MatthiasGeorgImhof/Hardware_CSAT/auxio_board/README.md

# Auxilliary board #

The auxilliary board provides desktop connectivity and power for the cubesat modules

- STM32L496
- 2x CAN buses
- 3x USB
- 3.3V and unregulated power

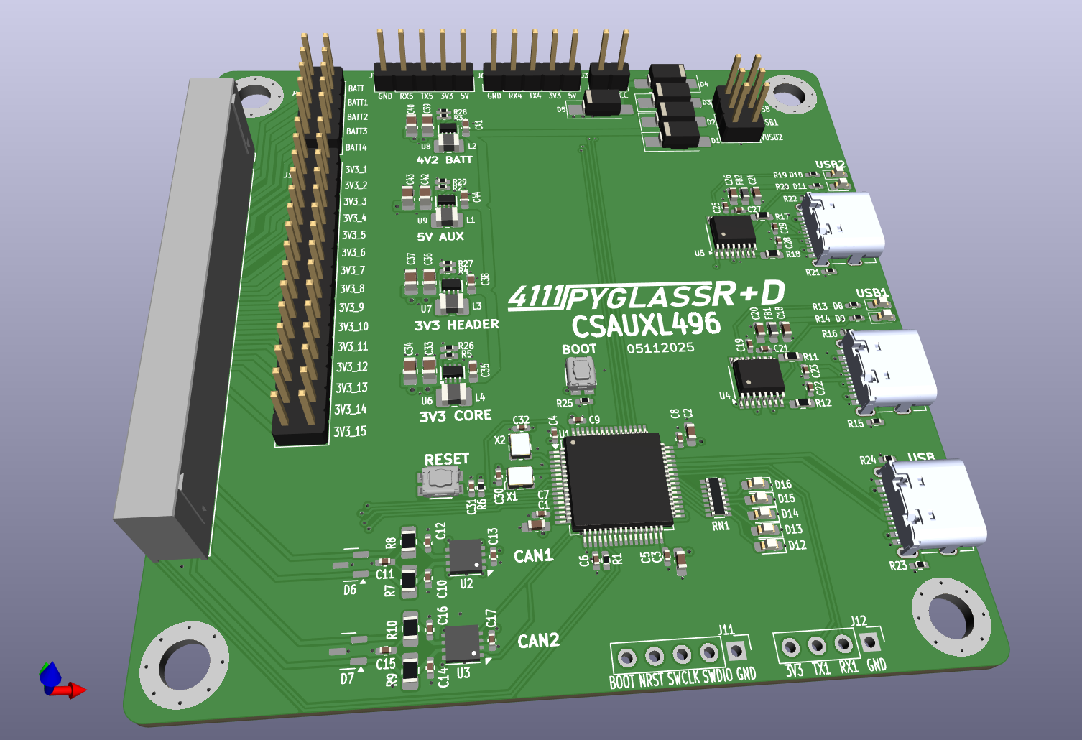
[picture p1: aux_board/aux_board_front.png]
Auxilliary board auxilliary board
