MatthiasGeorgImhof/Hardware_CSAT/avionics_board/README.md

# Avionics board #
- STM32L496 controller
- IMU and magenetometer
- UART for GPS receiver
- Magnetorquer controllers
- Temperature sensors
- Sun detectors

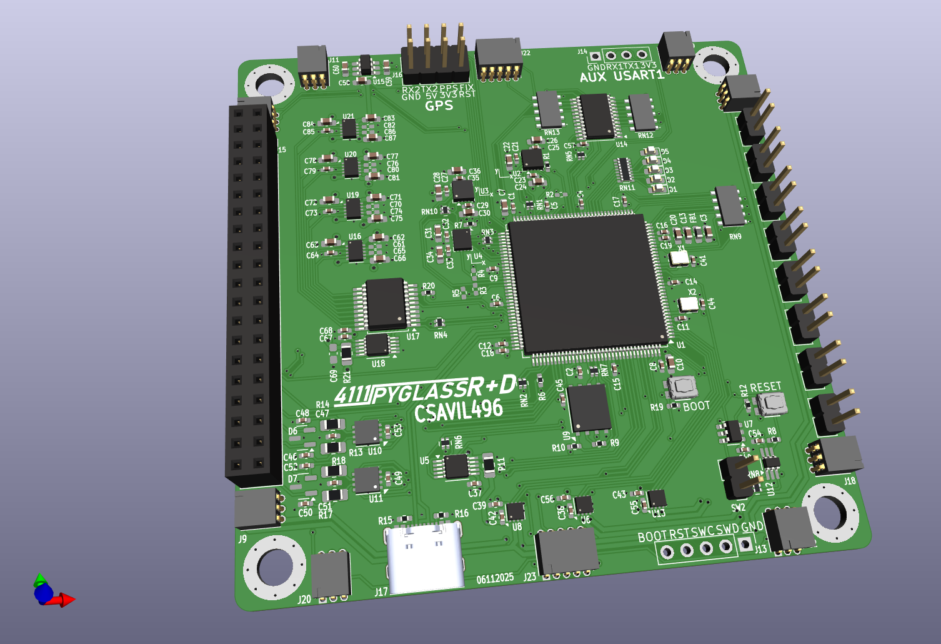
[picture p2: avionics_board/AVIONICS_BOARD.png]
Avionics board
