MatthiasGeorgImhof/Hardware_CSAT/eps_board/README.md

# Electric Power Supply (EPS) board

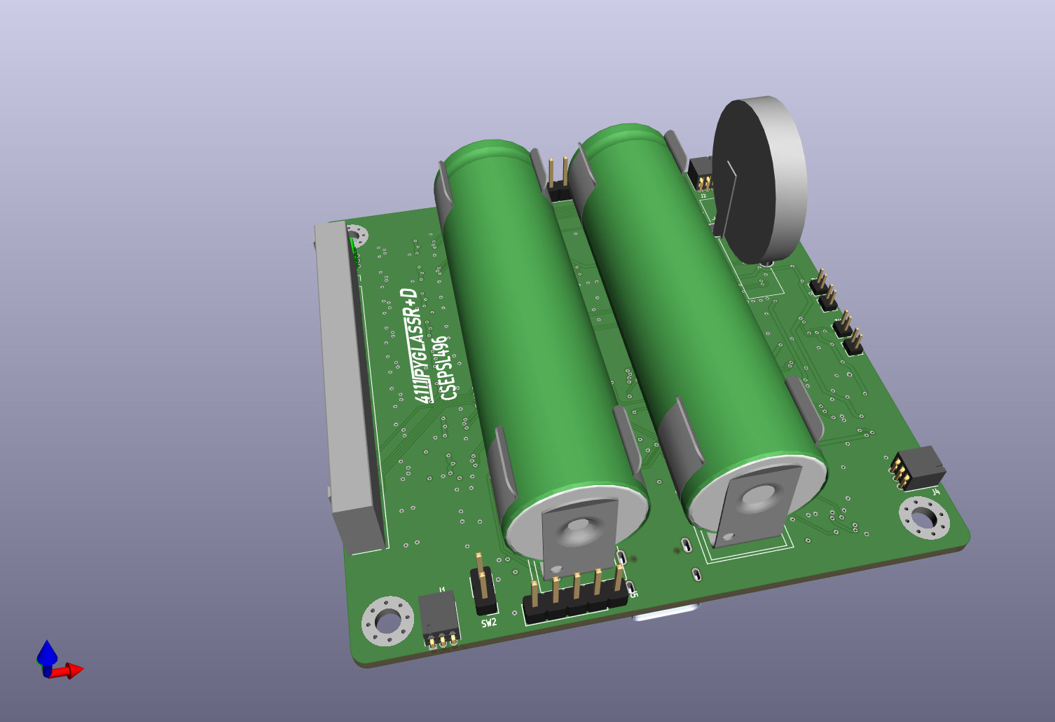
[picture p4: eps_board/EPS_front.png]
EPS board front side front side

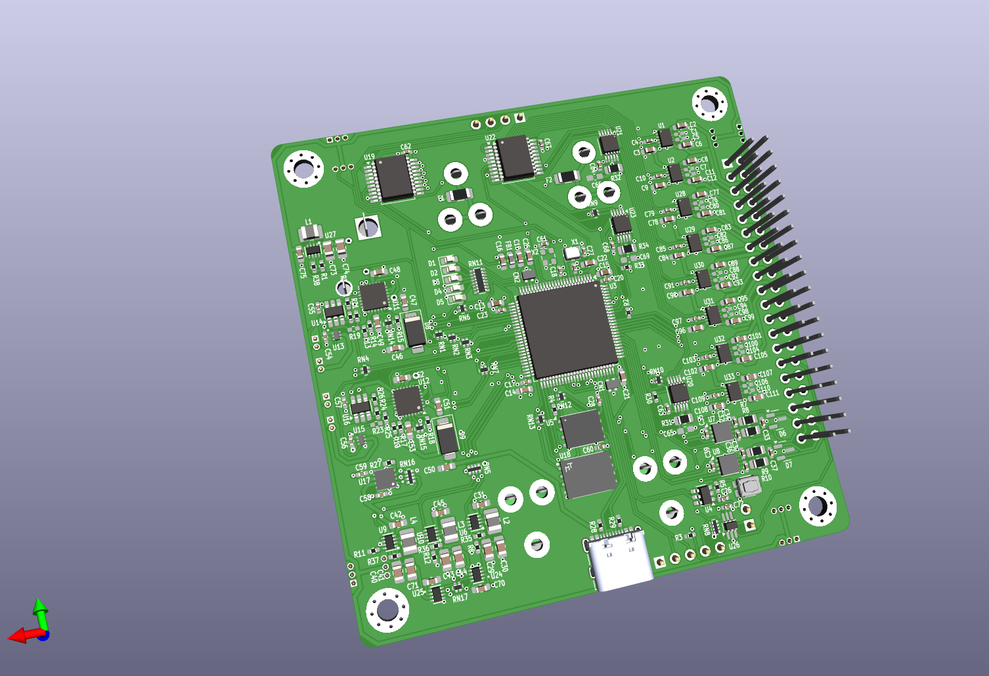
[picture p5: eps_board/EPS_back.png]
EPS board back side back side


- STM32L496VGTx controller
- 2x CAN buses
- 2x 18650 LiPo batteries for operation and 1x CR2450 cell for RTC
