MatthiasGeorgImhof/Hardware_CSAT/sci_board_wo_switches/README.md

# Science Board

- STM32L496VGTx
- 2x CAN buses
- 3x camera ports
- 1x I2C port

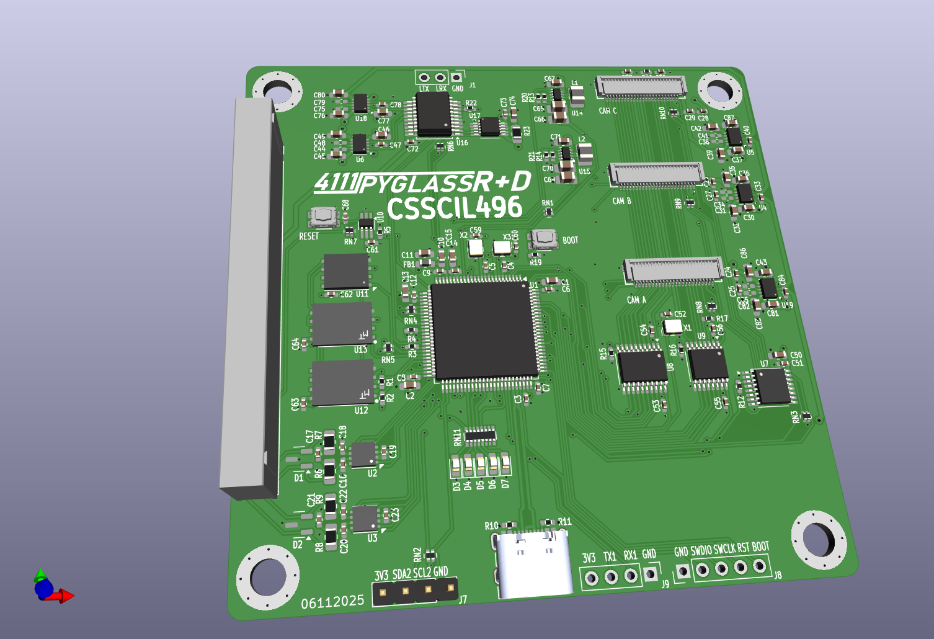
[picture p6: sci_board_wo_switches/sci_board_wo_switches_front.png]
Science board
 "Science board")
