MatthiasGeorgImhof/Hardware_CSAT/sci_board.inactive/sci_board.png

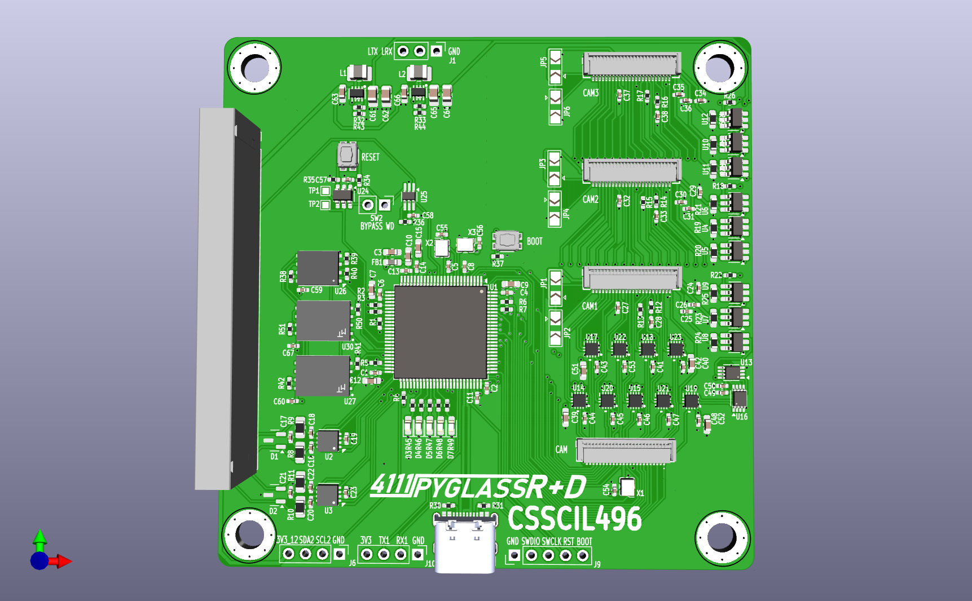
sci_board.inactive/sci_board.png
