MatthiasGeorgImhof/Hardware_CSAT/comm_board/inactive/step3d/LGA-28-6x6-0.7x0.7.step

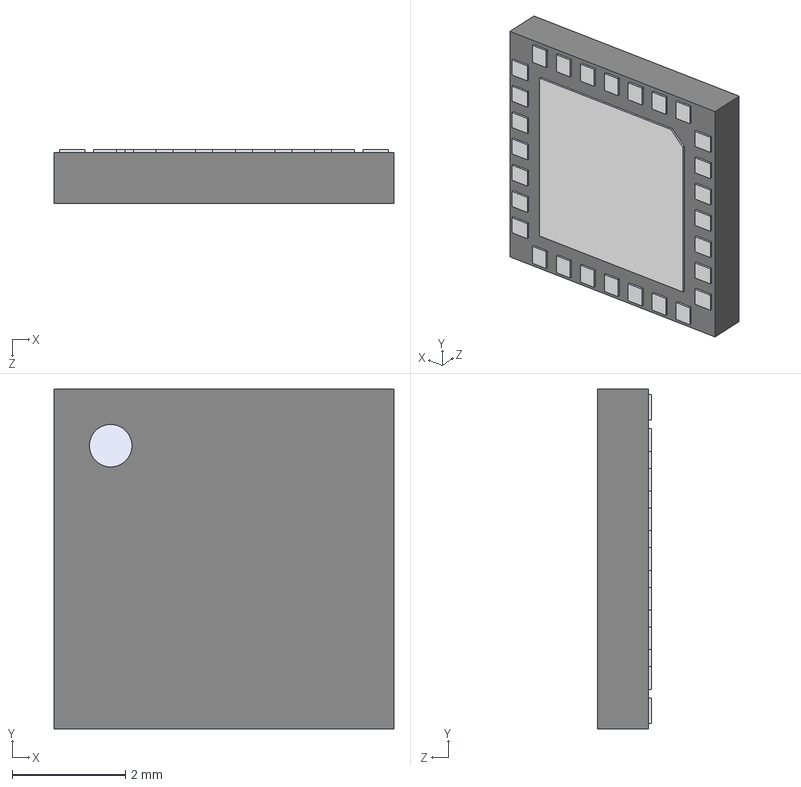
[picture p8: CAD file, 2026-06-08]
comm_board/inactive/step3d/LGA-28-6x6-0.7x0.7.step
6.00 x 6.00 x 0.95 mm
Open_CASCADE_STEP_translator_6.8_27.1
Open_CASCADE_STEP_translator_6.8_27.2.1
Thermal_Shape
Pin_Shape x 28
