MatthiasGeorgImhof/Hardware_CSAT/eps_board/inactive/Step3d/CR2450 VAN v1.step

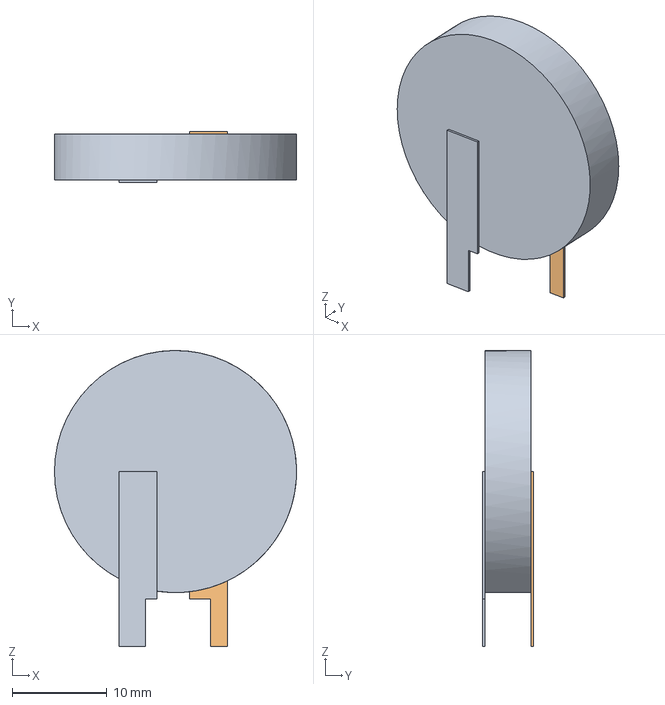
[picture p9: CAD file, 2026-06-08]
eps_board/inactive/Step3d/CR2450 VAN v1.step
25.6 x 5.35 x 31.3 mm
