MatthiasGeorgImhof/Hardware_CSAT/sci_board.inactive/Step3d/TSOT23-8_MP3416_MNP.step

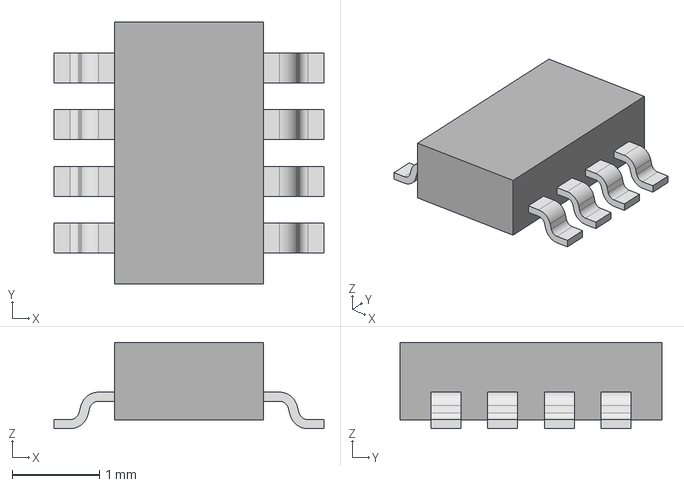
[picture p10: CAD file, 2026-06-08]
sci_board.inactive/Step3d/TSOT23-8_MP3416_MNP.step
3.09 x 3.00 x 0.991 mm
