MatthiasGeorgImhof/Hardware_CSAT/sci_board_wo_switches/inactive/Step3d/MT29F4G01ABAFDWB-IT_F.stp

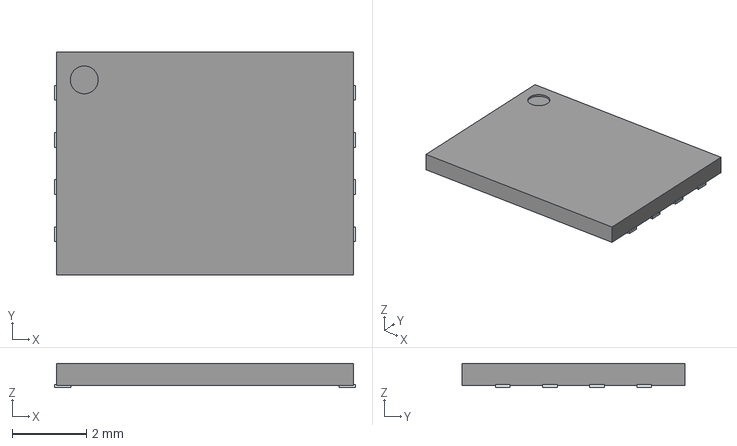
[picture p11: CAD file, 2026-06-08]
sci_board_wo_switches/inactive/Step3d/MT29F4G01ABAFDWB-IT_F.stp
8.10 x 6.00 x 0.65 mm
PinsArrayLR
