MatthiasGeorgImhof/Hardware_CSAT/auxio_board/inactive/step/ESQ-124-38-L-D.step

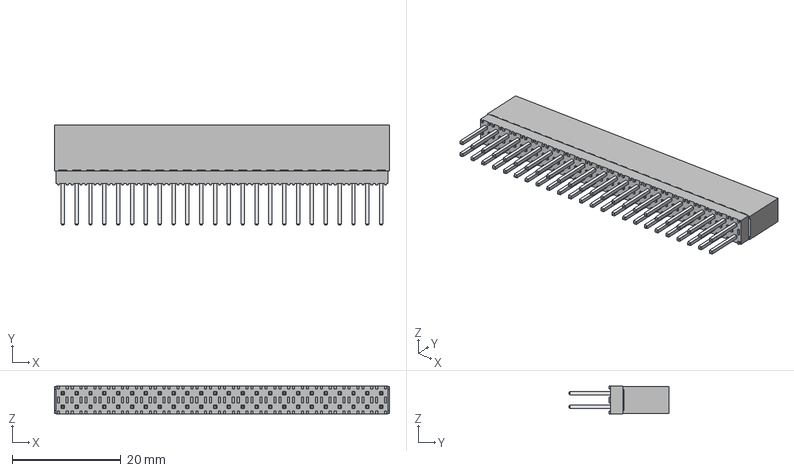
[picture p12: CAD file, 2026-06-08]
auxio_board/inactive/step/ESQ-124-38-L-D.step
61.5 x 18.4 x 5.08 mm
ESQ-124-38-L-D_socket
ESQ-124-38-L-D_pins
ESQ-124-38-L-D2_pins
ESQ-124-38-G-D-LL_bpins
