MatthiasGeorgImhof/Hardware_CSAT/common/step3d/TG2520_EPS.step

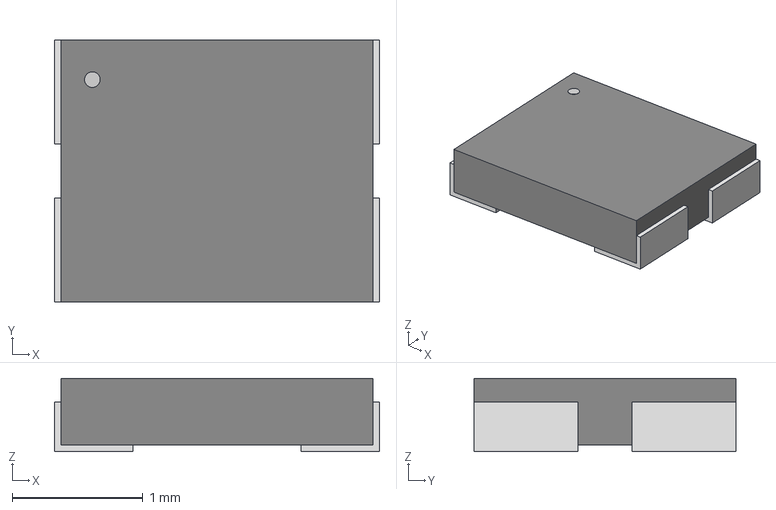
[picture p13: CAD file, 2026-06-08]
common/step3d/TG2520_EPS.step
2.49 x 2.01 x 0.561 mm
