MatthiasGeorgImhof/Hardware_CSAT/eps_board/inactive/Step3d/keystone-PN54.STEP

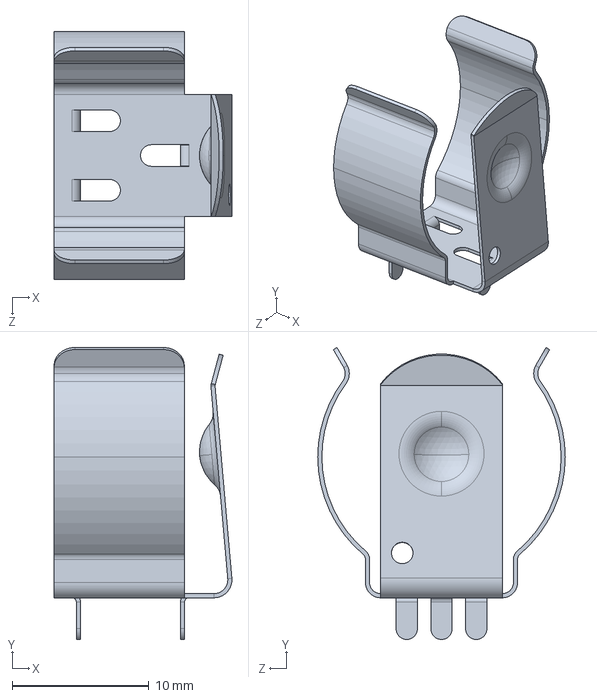
[picture p14: CAD file, 2026-06-08]
eps_board/inactive/Step3d/keystone-PN54.STEP
13.0 x 21.4 x 18.1 mm
