MatthiasGeorgImhof/Hardware_CSAT/sci_board.inactive/Step3d/ECS-270-20-30B-TR.step

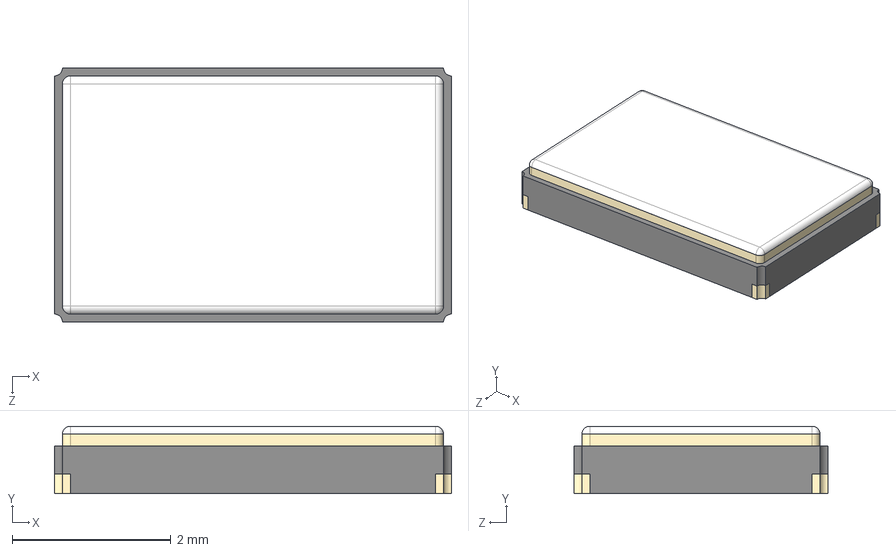
[picture p15: CAD file, 2026-06-08]
sci_board.inactive/Step3d/ECS-270-20-30B-TR.step
5.00 x 0.85 x 3.20 mm
