MatthiasGeorgImhof/Hardware_CSAT/auxio_board/inactive/step/ECS-TXO-2016-33-100-TR.step

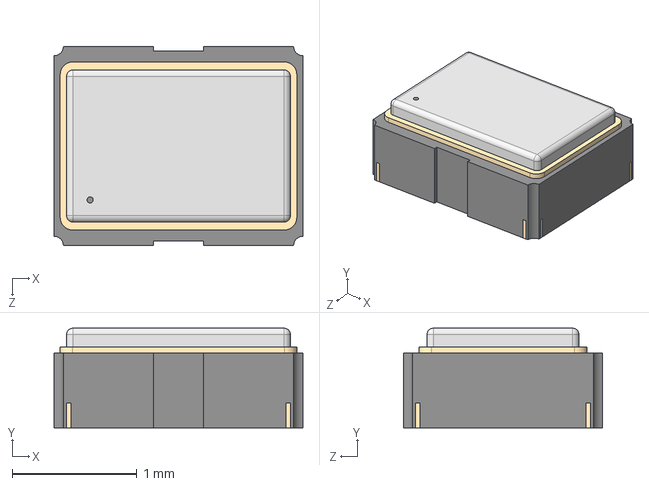
[picture p16: CAD file, 2026-06-08]
auxio_board/inactive/step/ECS-TXO-2016-33-100-TR.step
2.00 x 0.8 x 1.60 mm
