MatthiasGeorgImhof/Hardware_CSAT/comm_board/inactive/step3d/CONSMA001-G.step

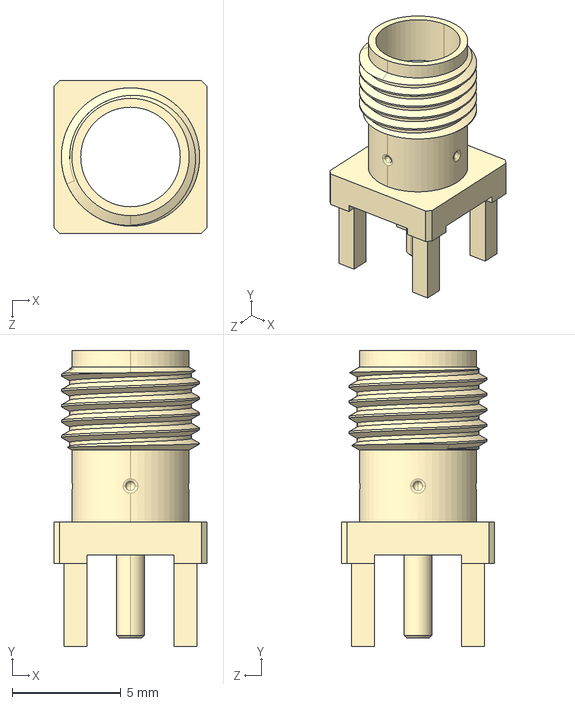
[picture p17: CAD file, 2026-06-08]
comm_board/inactive/step3d/CONSMA001-G.step
7.01 x 13.6 x 7.01 mm
