MatthiasGeorgImhof/Hardware_CSAT/eps_board/inactive/Step3d/User Library-CR2354-VCN-1.STEP

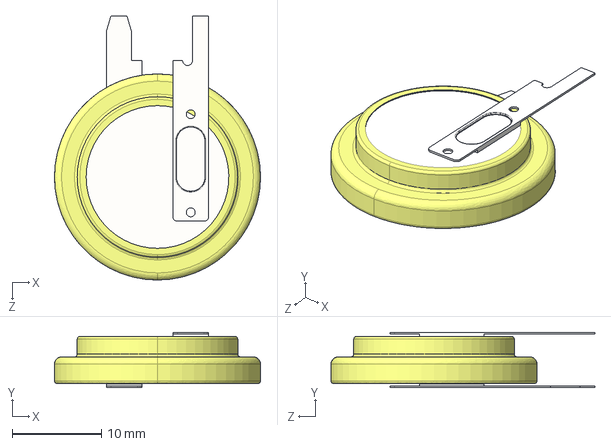
[picture p18: CAD file, 2026-06-08]
eps_board/inactive/Step3d/User Library-CR2354-VCN-1.STEP
23.1 x 6.20 x 29.6 mm
