MatthiasGeorgImhof/Hardware_CSAT/sci_board.inactive/Step3d/TMUX131RMGR.step

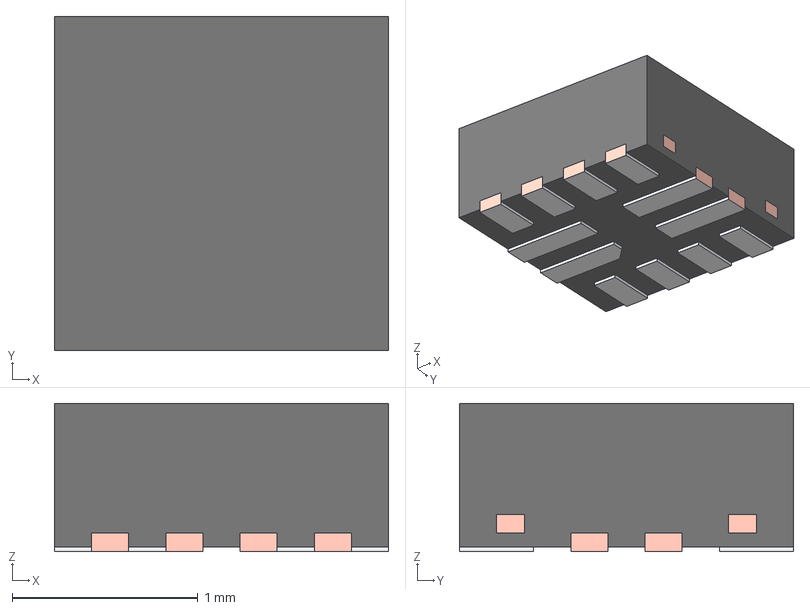
[picture p19: CAD file, 2026-06-08]
sci_board.inactive/Step3d/TMUX131RMGR.step
1.80 x 1.80 x 0.8 mm
FRAME
PIN1_AREA
