MatthiasGeorgImhof/Hardware_CSAT/auxio_board/inactive/step/evpaa602w.stp

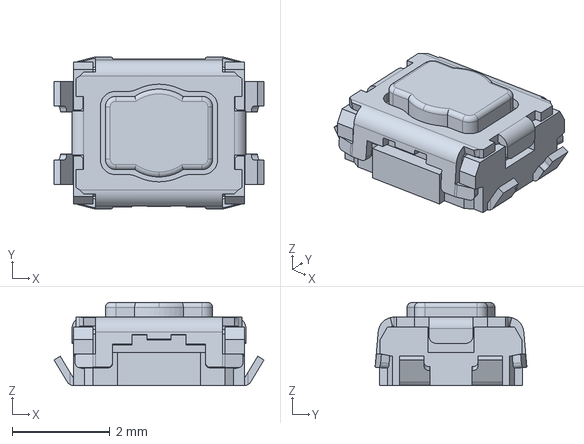
[picture p20: CAD file, 2026-06-08]
auxio_board/inactive/step/evpaa602w.stp
4.30 x 3.11 x 1.70 mm
