MatthiasGeorgImhof/Hardware_CSAT/comm_board/inactive/step3d/204-211.step

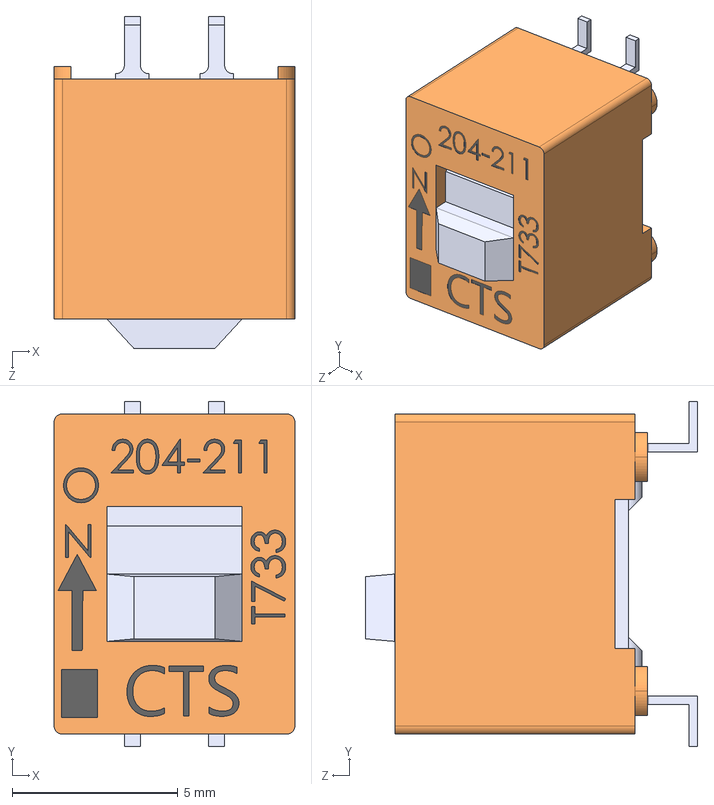
[picture p21: CAD file, 2026-06-08]
comm_board/inactive/step3d/204-211.step
7.27 x 10.4 x 10.0 mm
204-211R cover
204-211 actuator
204-2 pole assembly
