MatthiasGeorgImhof/Hardware_CSAT/common/step3d/SAMTEC-CLP-102-02-X-DH.step

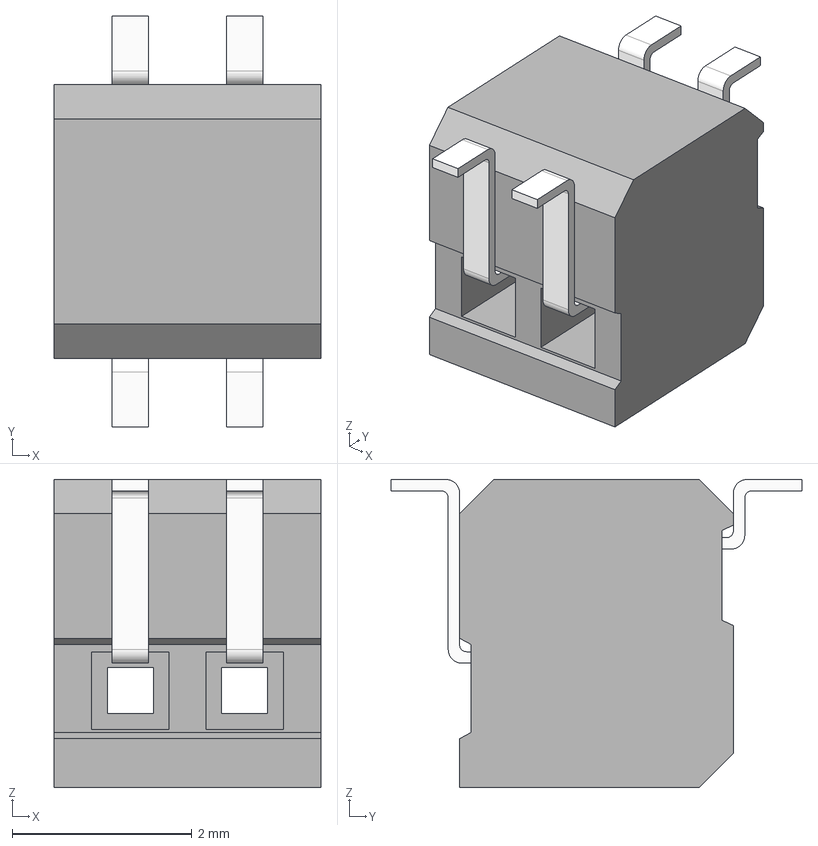
[picture p22: CAD file, 2026-06-08]
common/step3d/SAMTEC-CLP-102-02-X-DH.step
2.97 x 4.57 x 3.43 mm
CLP-102-2-F-DH-TR_terminal
C-70-04-1-F-02_Pin_2_dh
C-70-05-1-F-02_Pin_dh
