MatthiasGeorgImhof/Hardware_CSAT/sci_board.inactive/Step3d/SF-DFN8_EVS.step

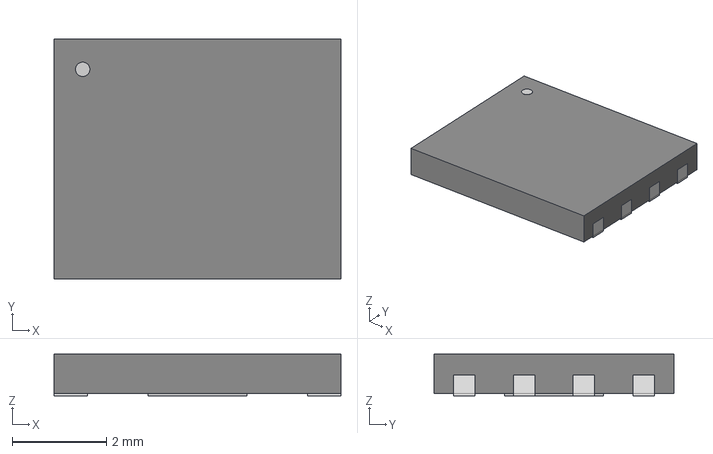
[picture p23: CAD file, 2026-06-08]
sci_board.inactive/Step3d/SF-DFN8_EVS.step
6.10 x 5.11 x 0.892 mm
