MatthiasGeorgImhof/Hardware_CSAT/sci_board_wo_switches/inactive/Step3d/MT29F2G01ABAGDWB-IT_G TR.step

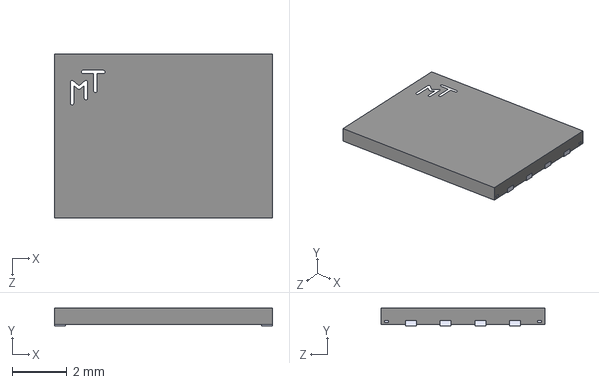
[picture p24: CAD file, 2026-06-08]
sci_board_wo_switches/inactive/Step3d/MT29F2G01ABAGDWB-IT_G TR.step
8.00 x 0.65 x 6.00 mm
