MatthiasGeorgImhof/Hardware_CSAT/comm_board/inactive/step3d/SF2446E.stp

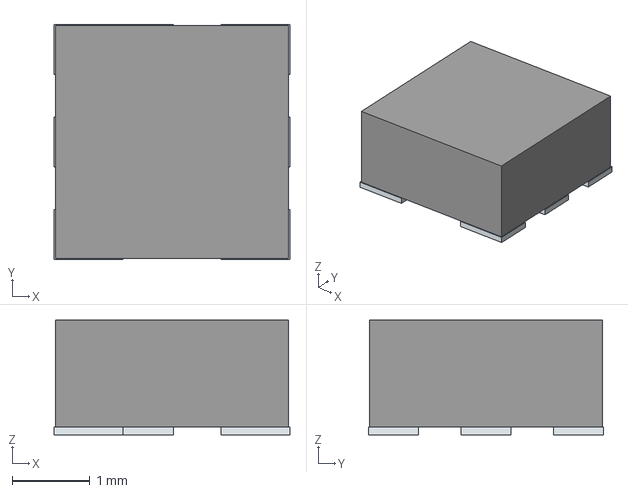
[picture p25: CAD file, 2026-06-08]
comm_board/inactive/step3d/SF2446E.stp
3.04 x 3.03 x 1.48 mm
Pins
