MatthiasGeorgImhof/Hardware_CSAT/common/step3d/ECS-2520MVLC-100-BN-TR.step

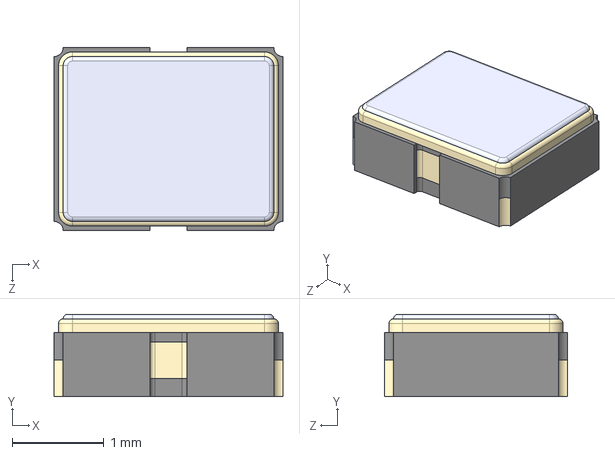
[picture p26: CAD file, 2026-06-08]
common/step3d/ECS-2520MVLC-100-BN-TR.step
2.50 x 0.9 x 2.00 mm
