MatthiasGeorgImhof/Hardware_CSAT/common/step3d/PW0020A.stp

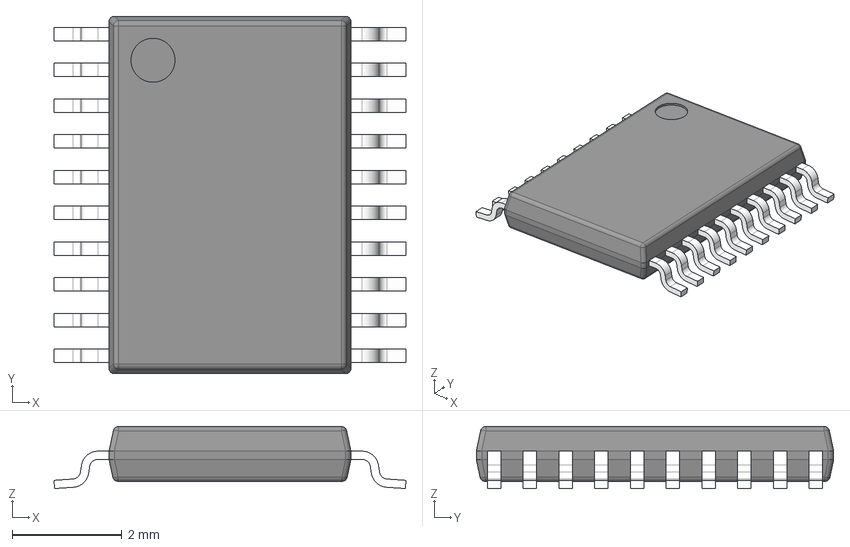
[picture p27: CAD file, 2026-06-08]
common/step3d/PW0020A.stp
6.40 x 6.50 x 1.13 mm
BODY-TSSOP
LEAD-TSSOP x 20
PIN1
