MatthiasGeorgImhof/Hardware_CSAT/common/step3d/DCU0008A.stp

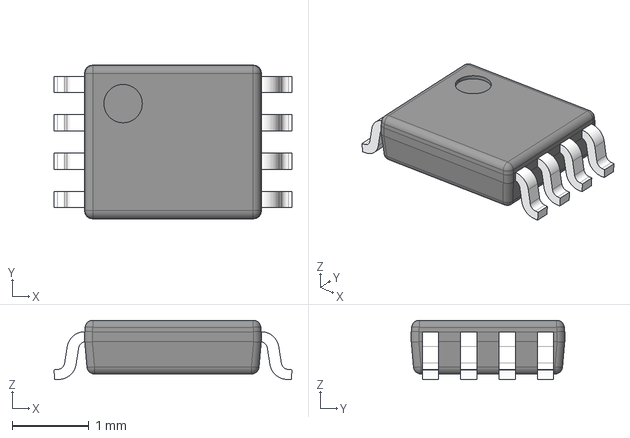
[picture p28: CAD file, 2026-06-08]
common/step3d/DCU0008A.stp
3.10 x 2.00 x 0.775 mm
BODY-VSSOP
LEAD-VSSOP x 8
