MatthiasGeorgImhof/Hardware_CSAT/common/step3d/YC158TJR.STEP

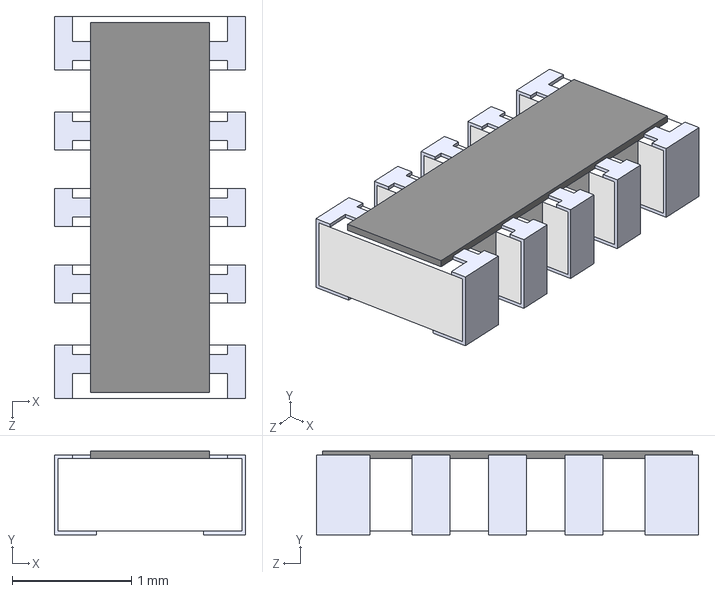
[picture p29: CAD file, 2026-06-08]
common/step3d/YC158TJR.STEP
1.60 x 0.7 x 3.20 mm
