MatthiasGeorgImhof/Hardware_CSAT/common/step3d/TCAN3413DRBR.STEP

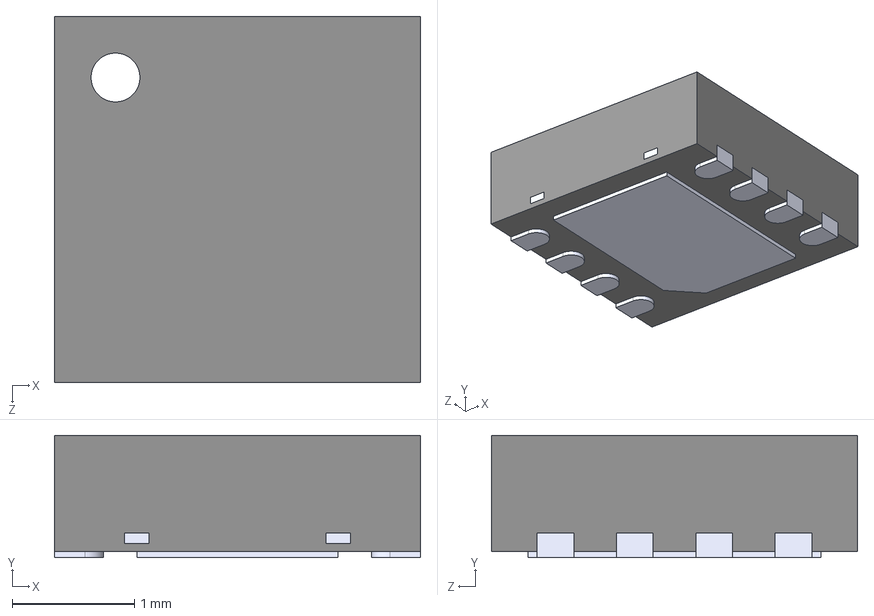
[picture p30: CAD file, 2026-06-08]
common/step3d/TCAN3413DRBR.STEP
3.00 x 1.00 x 3.00 mm
