MatthiasGeorgImhof/Hardware_CSAT/common/step3d/RJMG1BD3B8K1ANR.STEP

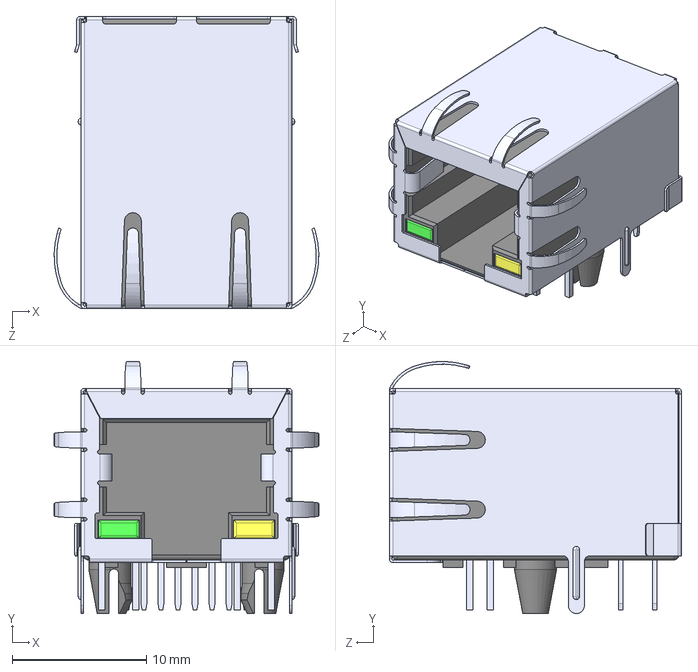
[picture p31: CAD file, 2026-06-08]
common/step3d/RJMG1BD3B8K1ANR.STEP
19.7 x 18.8 x 21.8 mm
