MatthiasGeorgImhof/Hardware_CSAT/common/step3d/SAMTEC-CLP-103-02-X-DH.step

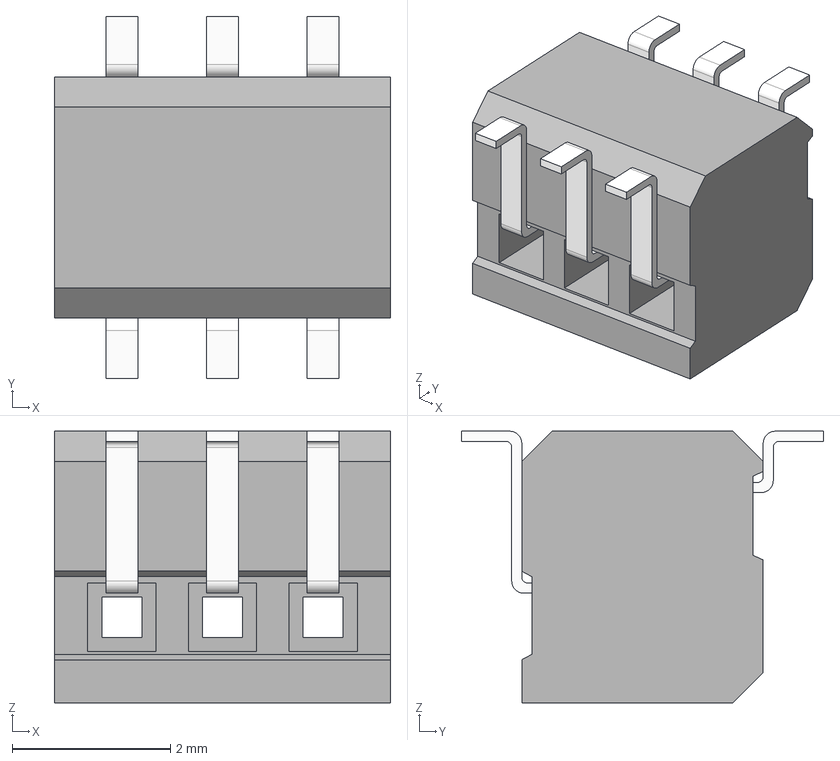
[picture p32: CAD file, 2026-06-08]
common/step3d/SAMTEC-CLP-103-02-X-DH.step
4.24 x 4.57 x 3.43 mm
CLP-103-2-L-DH-TR_terminal
C-70-04-1-L-03_Pin_2_dh
C-70-05-1-L-03_Pin_dh
