MatthiasGeorgImhof/Hardware_CSAT/common/step3d/W2A2-X.stp

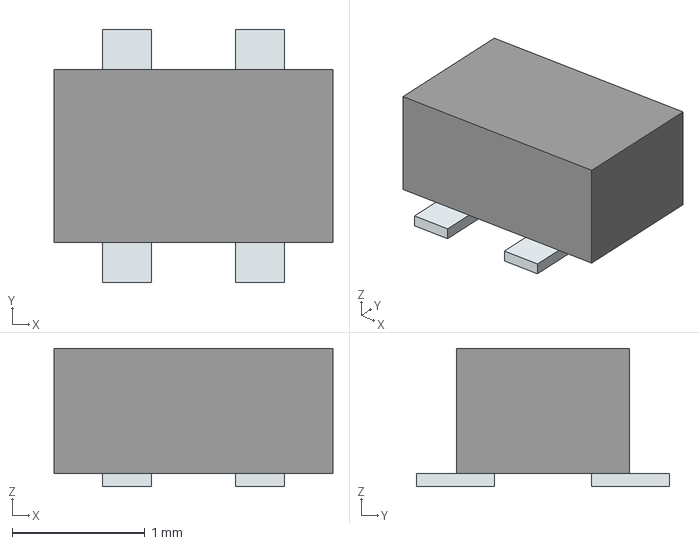
[picture p33: CAD file, 2026-06-08]
common/step3d/W2A2-X.stp
2.10 x 1.91 x 1.04 mm
Pins
