MatthiasGeorgImhof/Hardware_CSAT/common/step3d/SAMTEC-CLP-104-02-X-DH.step

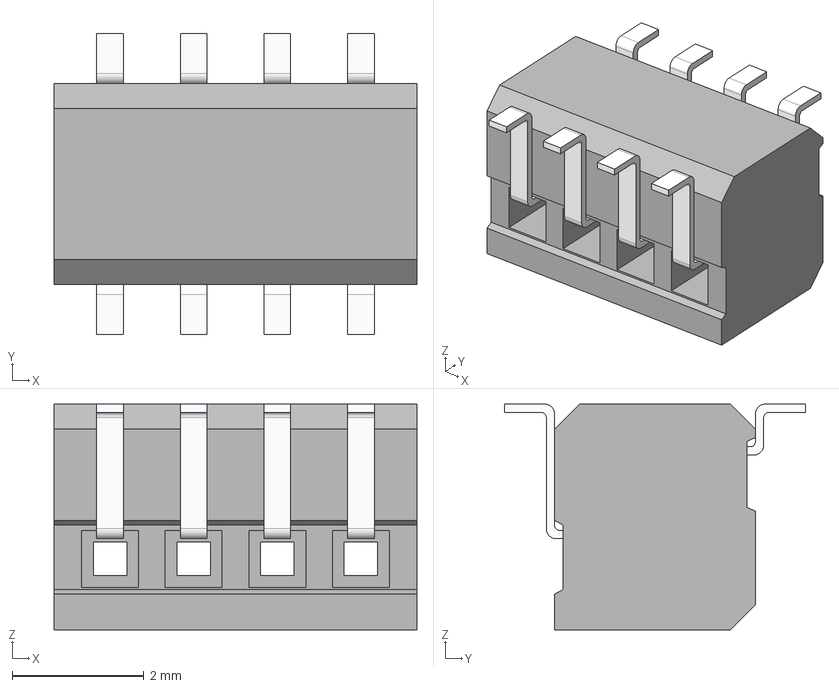
[picture p34: CAD file, 2026-06-08]
common/step3d/SAMTEC-CLP-104-02-X-DH.step
5.51 x 4.57 x 3.43 mm
CLP-104-2-F-DH_terminal
C-70-04-1-F-04_Pin_2_dh
C-70-05-1-F-04_Pin_dh
