MatthiasGeorgImhof/Hardware_CSAT/common/step3d/RZG0006A.stp

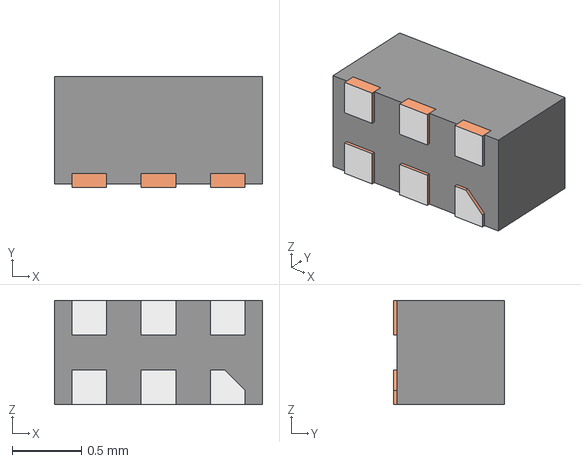
[picture p35: CAD file, 2026-06-08]
common/step3d/RZG0006A.stp
1.50 x 0.8 x 0.75 mm
BODY-RZG0006A
FRAME-RZG0006A
