MatthiasGeorgImhof/Hardware_CSAT/common/step3d/CC1101RGPR.stp

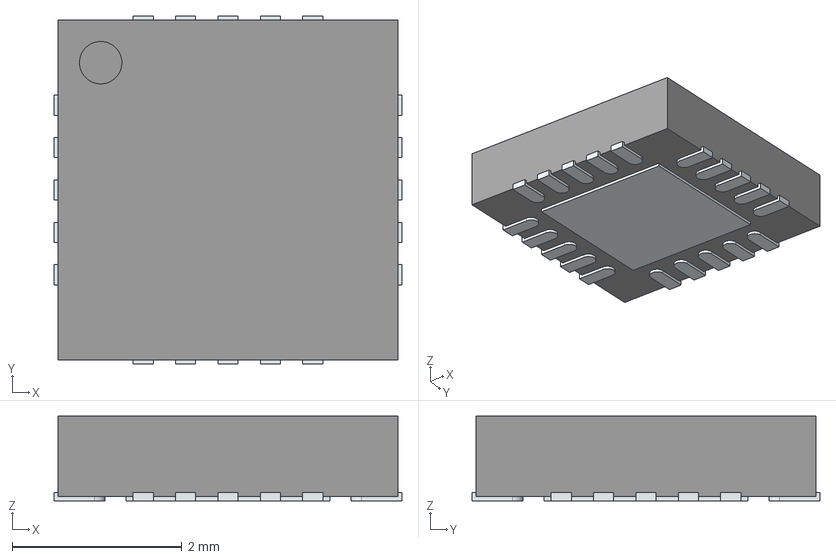
[picture p36: CAD file, 2026-06-08]
common/step3d/CC1101RGPR.stp
4.10 x 4.10 x 1.00 mm
ThermalPin
PinsArrayLR
PinsArrayTB
