MatthiasGeorgImhof/Hardware_CSAT/common/step3d/YC248-JR.STEP

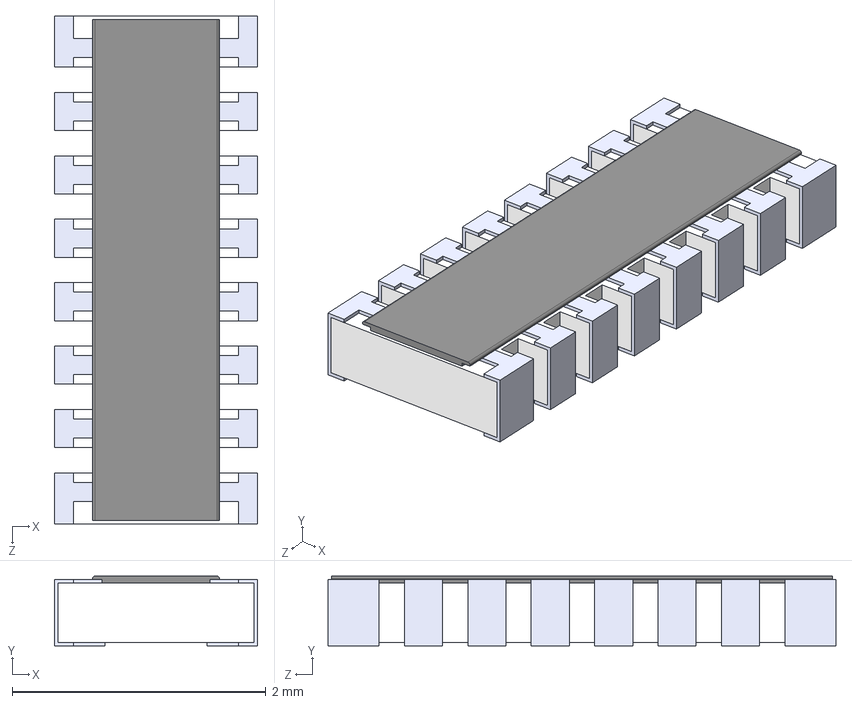
[picture p37: CAD file, 2026-06-08]
common/step3d/YC248-JR.STEP
1.60 x 0.55 x 4.00 mm
