MatthiasGeorgImhof/Hardware_CSAT/common/step3d/TSSOP8_SOT505-1_NXP.step

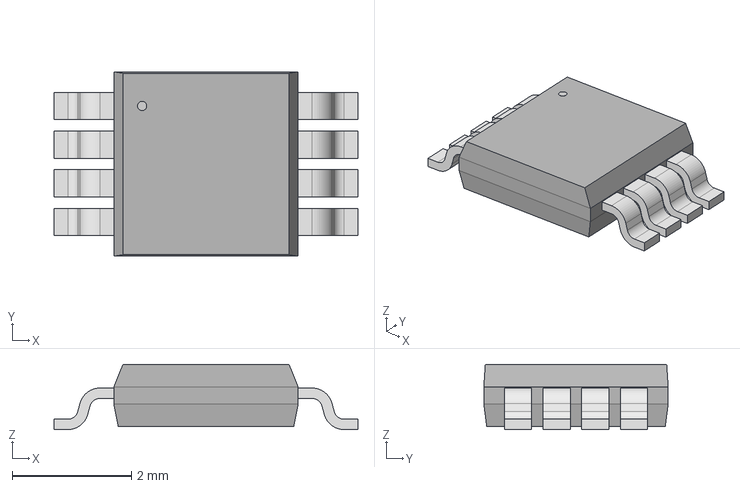
[picture p38: CAD file, 2026-06-08]
common/step3d/TSSOP8_SOT505-1_NXP.step
5.11 x 3.10 x 1.09 mm
