MatthiasGeorgImhof/Hardware_CSAT/common/step3d/SSOP28_MC_MCH.step

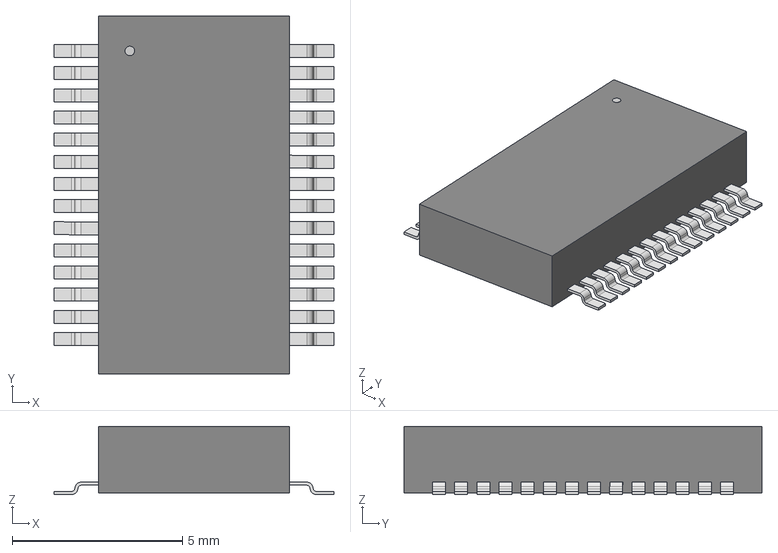
[picture p39: CAD file, 2026-06-08]
common/step3d/SSOP28_MC_MCH.step
8.20 x 10.5 x 2.00 mm
