MatthiasGeorgImhof/Hardware_CSAT/common/step3d/SSOP20_MC_MCH.step

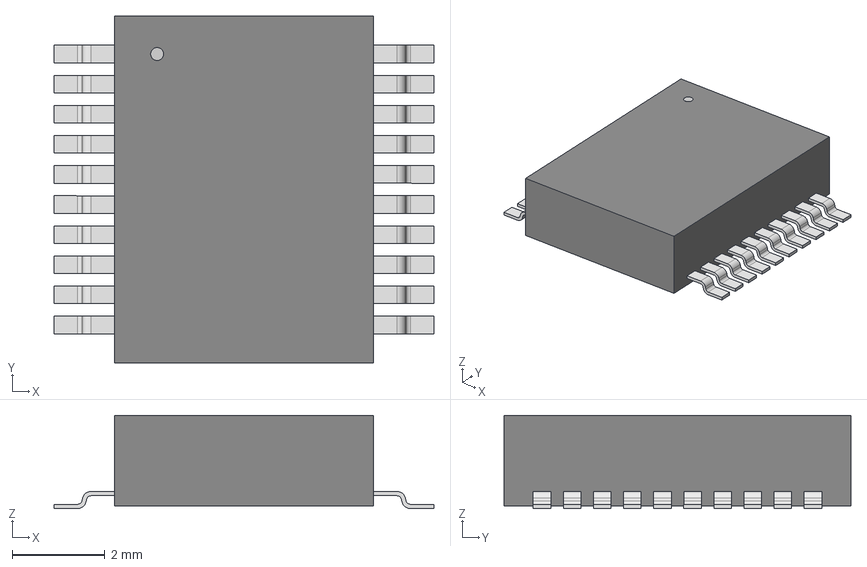
[picture p40: CAD file, 2026-06-08]
common/step3d/SSOP20_MC_MCH.step
8.20 x 7.49 x 2.01 mm
