MatthiasGeorgImhof/Hardware_CSAT/common/step3d/DRL0008A.stp

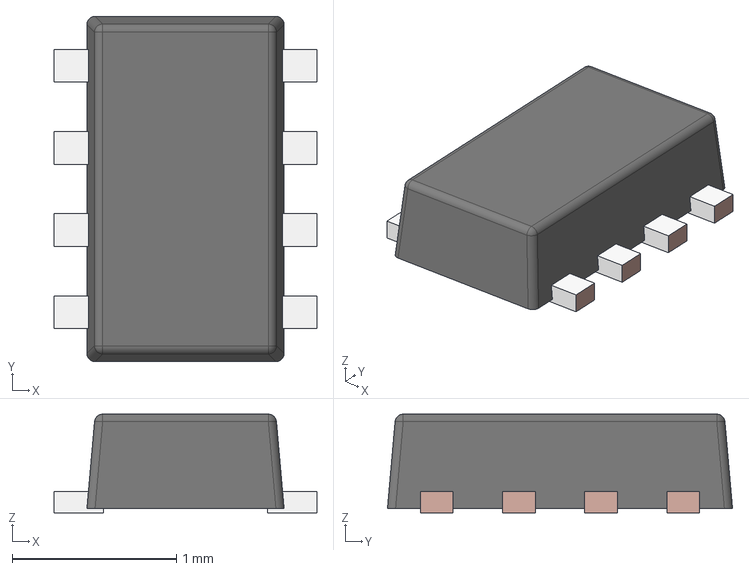
[picture p41: CAD file, 2026-06-08]
common/step3d/DRL0008A.stp
1.60 x 2.10 x 0.6 mm
FRAME-DRL0008A
BODY-SOT
