MatthiasGeorgImhof/Hardware_CSAT/common/step3d/YC358TJK.step

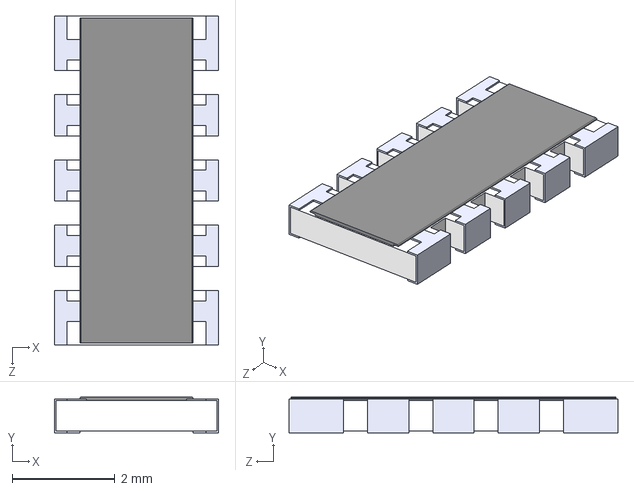
[picture p42: CAD file, 2026-06-08]
common/step3d/YC358TJK.step
3.20 x 0.7 x 6.40 mm
