MatthiasGeorgImhof/Hardware_CSAT/common/step3d/SAMTEC-CLP-106-02-X-DH.step

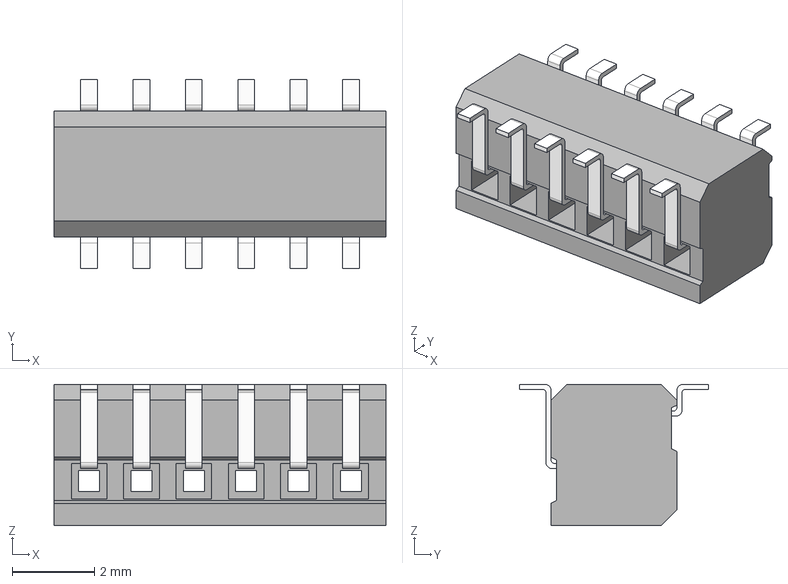
[picture p43: CAD file, 2026-06-08]
common/step3d/SAMTEC-CLP-106-02-X-DH.step
8.05 x 4.57 x 3.43 mm
CLP-106-2-F-DH_terminal
C-70-04-1-F-06_Pin_2_dh
C-70-05-1-F-06_Pin_dh
