MatthiasGeorgImhof/Hardware_CSAT/common/step3d/SAMTEC-CLP-105-02-X-DH.step

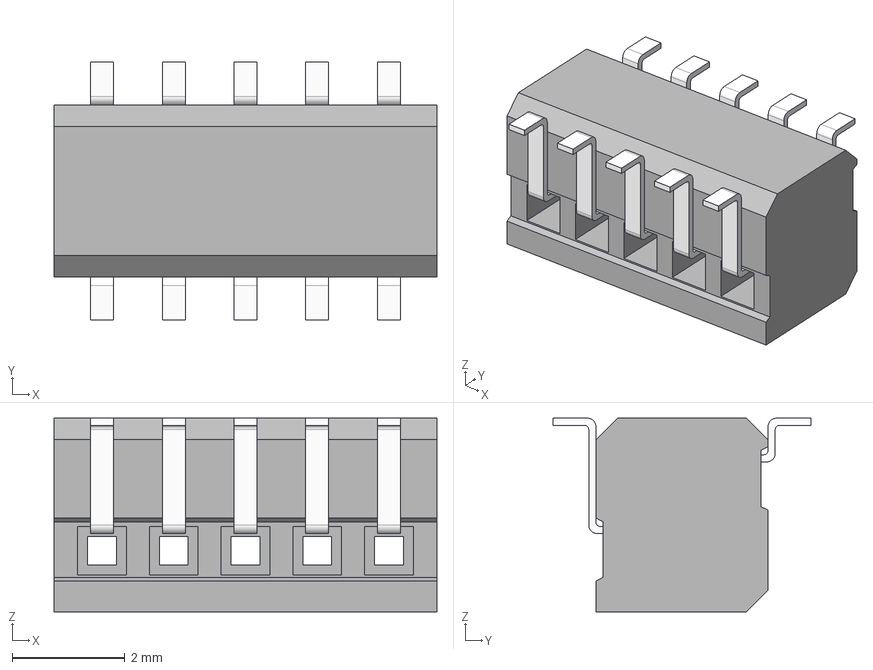
[picture p44: CAD file, 2026-06-08]
common/step3d/SAMTEC-CLP-105-02-X-DH.step
6.78 x 4.57 x 3.43 mm
CLP-105-2-F-DH_terminal
C-70-04-1-F-05_Pin_2_dh
C-70-05-1-F-05_Pin_dh
