MatthiasGeorgImhof/Hardware_CSAT/common/step3d/EXB-A10P.stp

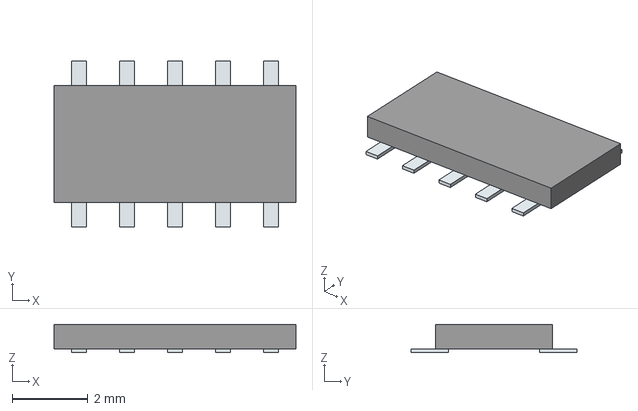
[picture p45: CAD file, 2026-06-08]
common/step3d/EXB-A10P.stp
6.40 x 4.40 x 0.75 mm
Pins
