MatthiasGeorgImhof/Hardware_CSAT/common/step3d/TSSOP20_SOT360-1_NEX.step

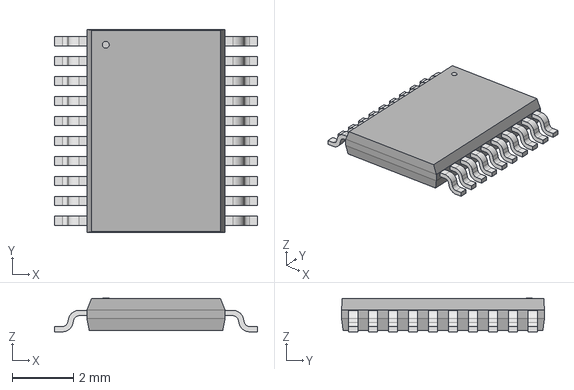
[picture p46: CAD file, 2026-06-08]
common/step3d/TSSOP20_SOT360-1_NEX.step
6.60 x 6.60 x 1.09 mm
