MatthiasGeorgImhof/Hardware_CSAT/common/step3d/RB1-125BAG1A.step

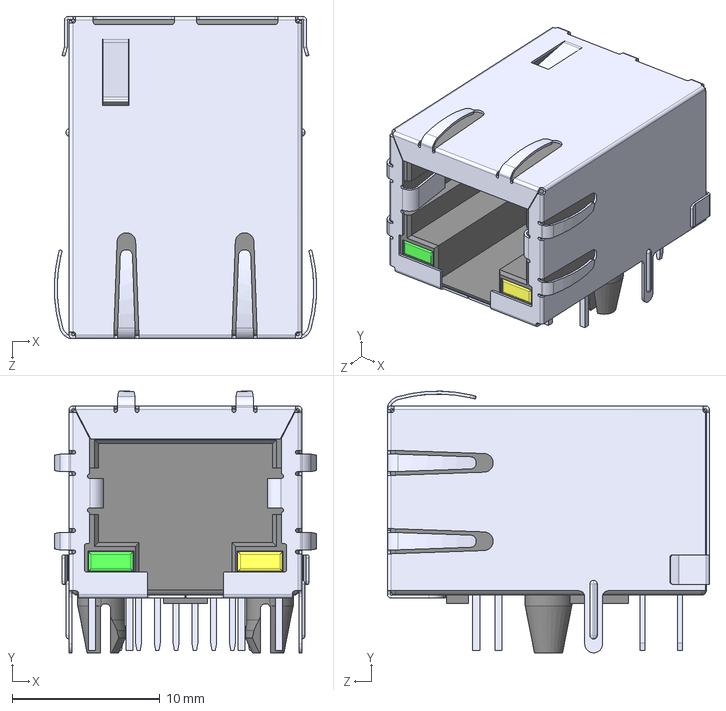
[picture p47: CAD file, 2026-06-08]
common/step3d/RB1-125BAG1A.step
17.7 x 17.7 x 21.8 mm
