MatthiasGeorgImhof/Hardware_CSAT/common/step3d/ECS-2033-100-AU.step

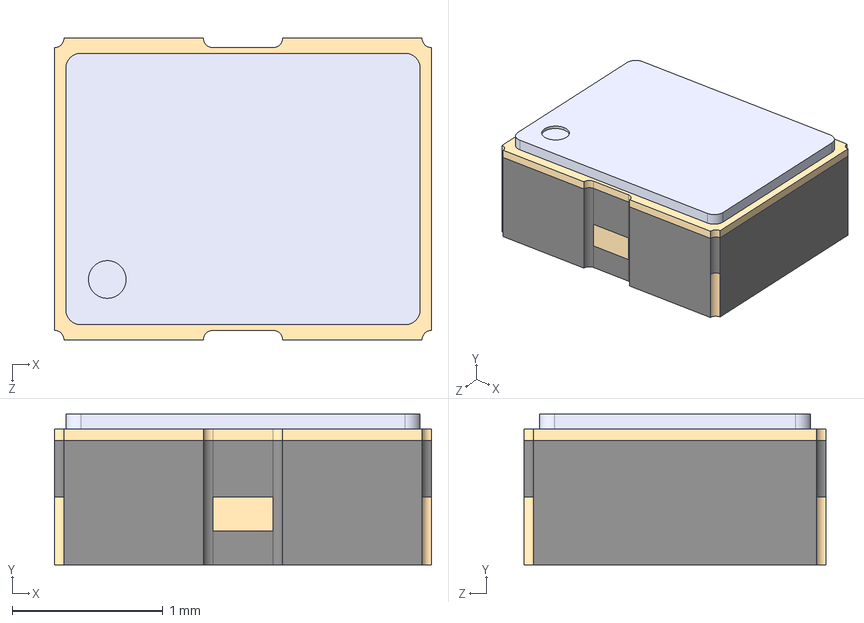
[picture p48: CAD file, 2026-06-08]
common/step3d/ECS-2033-100-AU.step
2.50 x 1.00 x 2.00 mm
