MatthiasGeorgImhof/Hardware_CSAT/common/step3d/CC1190RGVR.stp

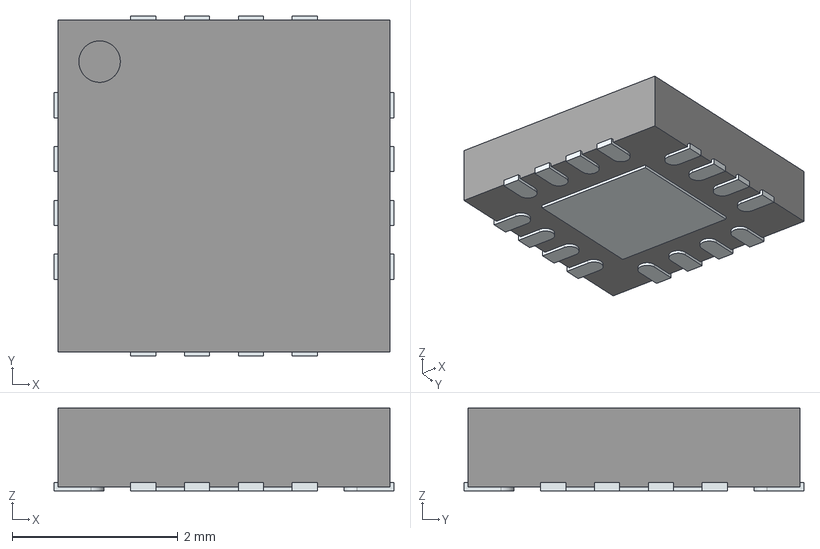
[picture p49: CAD file, 2026-06-08]
common/step3d/CC1190RGVR.stp
4.10 x 4.10 x 1.00 mm
ThermalPin
PinsArrayLR
PinsArrayTB
