MatthiasGeorgImhof/Hardware_CSAT/common/step3d/ECS-327MVATX-2-CN-TR3.STEP

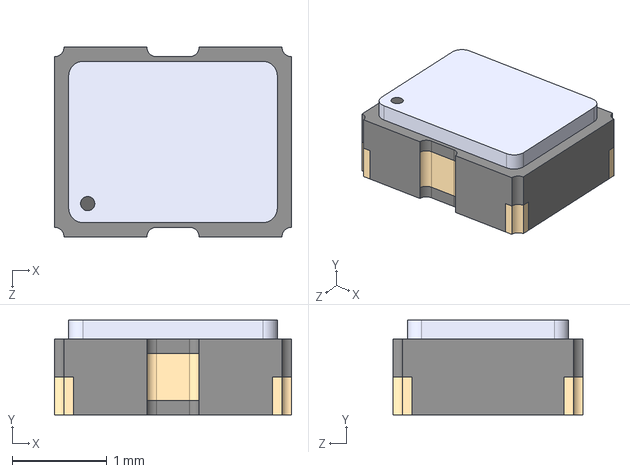
[picture p50: CAD file, 2026-06-08]
common/step3d/ECS-327MVATX-2-CN-TR3.STEP
2.50 x 1.00 x 2.00 mm
