MatthiasGeorgImhof/Hardware_CSAT/common/step3d/DMG0010A.stp

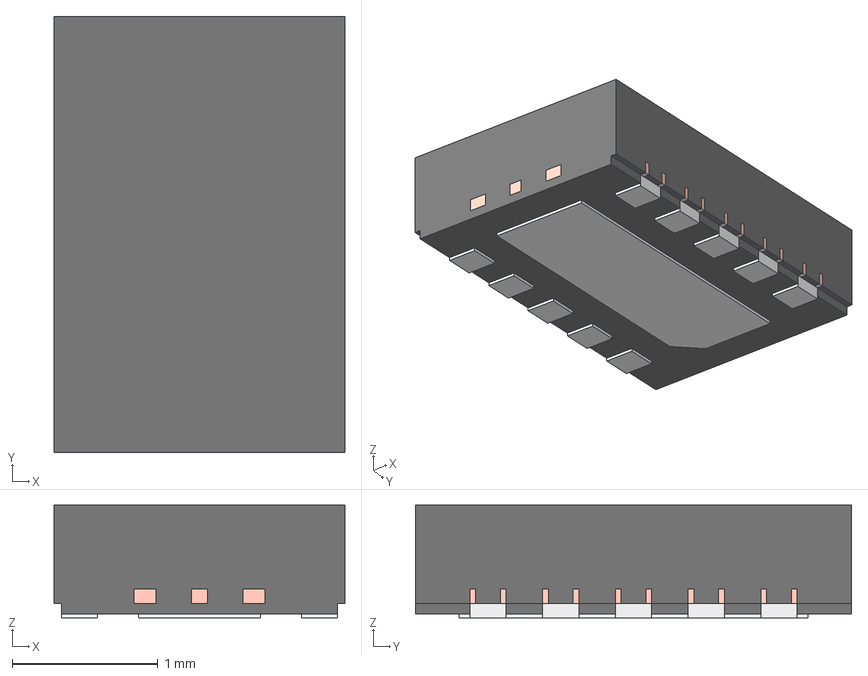
[picture p51: CAD file, 2026-06-08]
common/step3d/DMG0010A.stp
2.00 x 3.00 x 0.775 mm
BODY-SON_AF0
PIN1-ID
FRAME-DMG0010A_AF0
