MatthiasGeorgImhof/Hardware_CSAT/common/step3d/PW0016A.stp

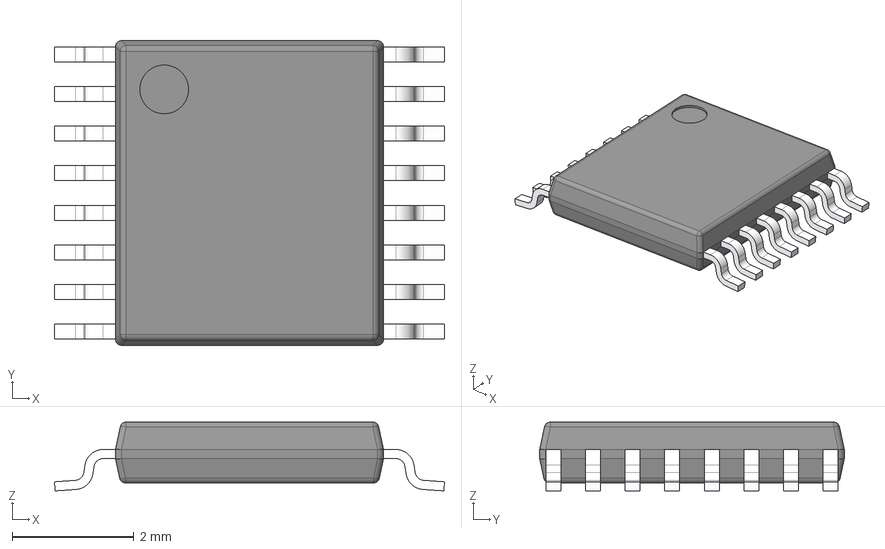
[picture p52: CAD file, 2026-06-08]
common/step3d/PW0016A.stp
6.40 x 5.00 x 1.13 mm
BODY-TSSOP
LEAD-TSSOP x 16
PIN1
