MatthiasGeorgImhof/Hardware_CSAT/(list of files, cad)

Other CAD files:
common/step3d/TPS2115ADRBR.step
auxio_board/inactive/step/10155435-00011LF.step
comm_board/inactive/step3d/JS202011JCQN.step
common/step3d/10051922-2410EHLF.STEP
common/step3d/10153301-201xxLF.stp
common/step3d/18650-battery-01a-v1.step
common/step3d/B39921B2672P810.stp
common/step3d/M50-3200345.step
common/step3d/M50-3200445.step
common/step3d/M50-3200545.step
common/step3d/M50-3200645.step
eps_board/inactive/Step3d/18650-battery-01a-v1.step
sci_board.inactive/Step3d/10051922-2410EHLF.STEP
sci_board_wo_switches/inactive/Step3d/10051922-2410EHLF.STEP
