MatthiasGeorgImhof/Hardware_CSAT/auxio_board/auxio_board.kicad_pcb

## KiCad design auxio_board/auxio_board.kicad_pcb (2026-09-15)

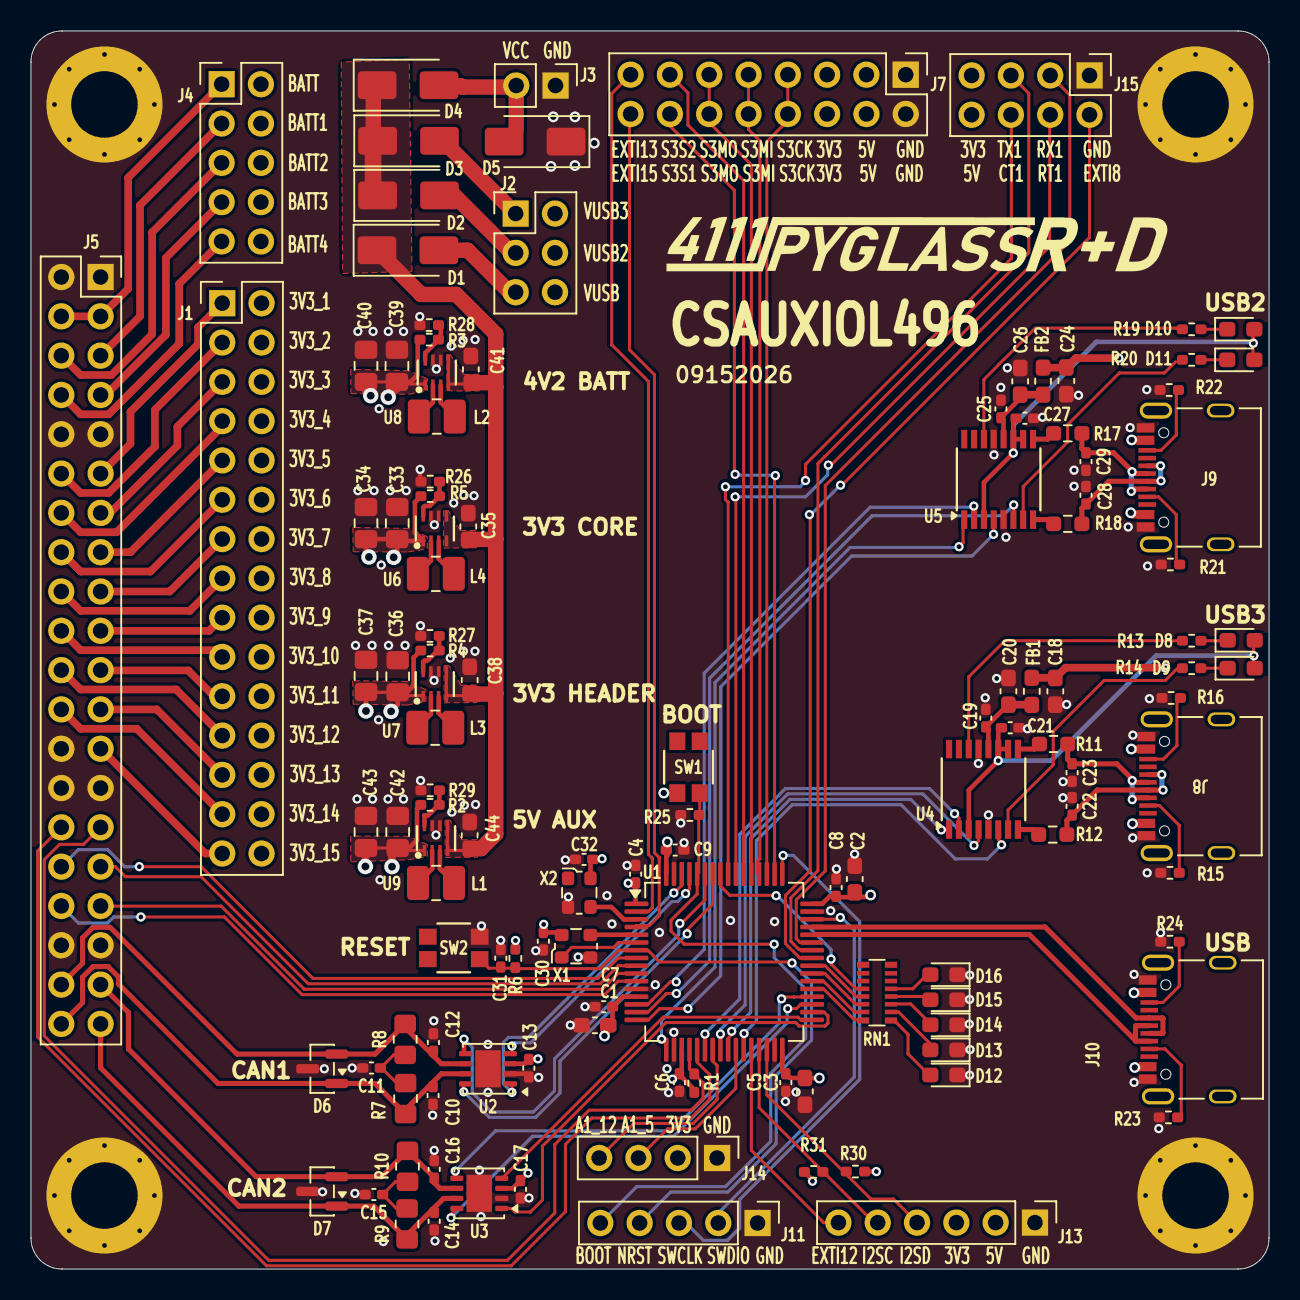
[picture p53: board auxio_board.kicad_pcb from above]

Board: 4 copper layers, 80.0 x 80.0 mm, 128 parts (0 on the bottom side), 135 nets.

Parts:
C1, C2, C3, C18, C20, C24, C26: 10uF; C_0603_1608Metric_Pad1.08x0.95mm_HandSolder
C4, C5, C6, C7, C8, C9, C19, C21, C25, C27: 100nF; C_0402_1005Metric_Pad0.74x0.62mm_HandSolder
C10, C12, C14, C16: 100p; C_0402_1005Metric_Pad0.74x0.62mm_HandSolder
C11, C15: 4n7; C_0402_1005Metric_Pad0.74x0.62mm_HandSolder
C13, C17, C30, C31, C32: 100n; C_0402_1005Metric_Pad0.74x0.62mm_HandSolder
C22, C23, C28, C29: 47pF; C_0402_1005Metric_Pad0.74x0.62mm_HandSolder
C33, C34, C36, C37, C39, C40, C42, C43: 47uF; C_0805_2012Metric_Pad1.18x1.45mm_HandSolder
C35, C38, C41, C44: 22uF; C_0603_1608Metric_Pad1.08x0.95mm_HandSolder
D1, D2, D3, D4: CDBA240LL-HF; D_SMA
D5: SMAJ6.0CA; D_SMA
D6, D7: NUP2105LT1G; SOT-23
D8, D10: LED_SMD_GREEN; LED_0603_1608Metric_Pad1.05x0.95mm_HandSolder
D9, D11: LED_SMD_RED; LED_0603_1608Metric_Pad1.05x0.95mm_HandSolder
D12: RED; LED_0603_1608Metric_Pad1.05x0.95mm_HandSolder
D13: GREEN; LED_0603_1608Metric_Pad1.05x0.95mm_HandSolder
D14, D15, D16: YELLOW; LED_0603_1608Metric_Pad1.05x0.95mm_HandSolder
FB1, FB2: 120R; L_0603_1608Metric_Pad1.05x0.95mm_HandSolder
H1, H2, H3, H4: MountingHole_Pad; MountingHole_4.3mm_M4_Pad_Via_Custom
J1: Conn_02x15_Odd_Even; PinHeader_2x15_P2.54mm_Vertical
J2: Conn_02x03_Odd_Even; PinHeader_2x03_P2.54mm_Vertical
J3: Conn_01x02_Pin; PinHeader_1x02_P2.54mm_Vertical
J4: Conn_02x05_Odd_Even; PinHeader_2x05_P2.54mm_Vertical
J5: PC104 Conn_02x20_Odd_Even; PinSocket_2x20_P2.54mm_Vertical
J7: Conn_02x08_Odd_Even; PinHeader_2x08_P2.54mm_Vertical
J8, J9, J10: 10155435-00011LF; AMPHENOL_10155435-00011LF
J11: Conn_01x05_Pin Vertical; PinHeader_1x05_P2.54mm_Vertical
J13: Conn_01x06_Pin; PinHeader_1x06_P2.54mm_Vertical
J14: Conn_01x04_Pin; PinHeader_1x04_P2.54mm_Vertical
J15: Conn_02x04_Odd_Even; PinHeader_2x04_P2.54mm_Vertical
L1, L2, L3, L4: 1uH; L_1008_2520Metric_Pad1.43x2.20mm_HandSolder
R1: 330K; R_0402_1005Metric_Pad0.72x0.64mm_HandSolder
R2: 806K; R_0402_1005Metric_Pad0.72x0.64mm_HandSolder
R3: 665K; R_0402_1005Metric_Pad0.72x0.64mm_HandSolder
R4, R5: 511K; R_0402_1005Metric_Pad0.72x0.64mm_HandSolder
R6, R25: 100K; R_0402_1005Metric_Pad0.72x0.64mm_HandSolder
R7, R8, R9, R10: 60R4; R_0805_2012Metric_Pad1.20x1.40mm_HandSolder
R11, R12, R17, R18: 27R; R_0603_1608Metric_Pad0.98x0.95mm_HandSolder
R13, R14, R19, R20: 1K; R_0402_1005Metric_Pad0.72x0.64mm_HandSolder
R15, R16, R21, R22, R23, R24, R30, R31: 5K1; R_0402_1005Metric_Pad0.72x0.64mm_HandSolder
R26, R27, R28, R29: 91K; R_0402_1005Metric_Pad0.72x0.64mm_HandSolder
RN1: 1K; R_Array_Convex_8x0602_widepads
SW1, SW2: EVP-AA602W; EVP602AA
U1: STM32L496RGT6; LQFP-64_10x10mm_P0.5mm
U2, U3: TCAN3414; VSON-8-1EP_3x3mm_P0.65mm_EP1.65x2.4mm
U4, U5: FT230XS; SSOP-16_3.9x4.9mm_P0.635mm
U6, U7, U8, U9: TPS631000DRLR; TPS631000DRLR_TEX
X1: 10MHz; Oscillator_SMD_ECS_2520MV-xxx-xx-4Pin_2.5x2.0mm
X2: 32.768KHZ; Oscillator_SMD_ECS_2520MV-xxx-xx-4Pin_2.5x2.0mm

Connections:
+3V3: C36.1, C37.1, J1.2, J1.4, J1.6, J1.8, J1.10, J1.12, J1.14, J1.16, J1.18, J1.20, J1.22, J1.24, J1.26, J1.28, J1.30, R4.2, U7.1 (VOUT)
+3V3_Core: C1.1, C2.1, C3.1, C4.1, C5.1, C6.1, C7.1, C8.1, C9.1, C13.1, C17.1, C30.1, C32.1, C33.1, C34.1, J7.5, J7.6, J13.3, J14.2, J15.7, R1.1, R5.2, R6.1, R30.2, R31.2, SW1.1, U1.1 (VBAT), U1.13 (VDDA), U1.19 (VDD), U1.32 (VDD), U1.48 (VDDUSB), U1.64 (VDD), U2.3 (VCC), U3.3 (VCC), U6.1 (VOUT), X1.4 (VDD), X2.4 (VCC)
+5V: C42.1, C43.1, J7.3, J7.4, J13.2, J15.8, R2.2, U9.1 (VOUT)
+VBAT: C39.1, C40.1, J4.2, J4.4, J4.6, J4.8, J4.10, R3.2, U8.1 (VOUT)
/*ATTENTION: J5.29, R1.2, U1.20 (PA4)
/*AVI_RST: J5.32, U1.8 (PC0)
/*COMM1_RST: J5.33, U1.10 (PC2)
/*COMM2_RST: J5.34, U1.11 (PC3)
/*EPS_RST: J5.30, U1.21 (PA5)
/*SCI_RST: J5.31, U1.9 (PC1)
/CAN1_H: C10.1, D6.1 (K), J5.40, R7.1, U2.7 (CANH)
/CAN1_L: C12.2, D6.2 (K), J5.38, R8.2, U2.6 (CANL)
/CAN2_H: C14.1, D7.1 (K), J5.39, R9.1, U3.7 (CANH)
/CAN2_L: C16.2, D7.2 (K), J5.37, R10.2, U3.6 (CANL)
/CAN TO USB/ASC1_IN12: J14.4, U1.23 (PA7)
/CAN TO USB/ASC1_IN15: J14.3, U1.26 (PB0)
/CAN TO USB/BOOT: J11.5, R25.1, SW1.2, U1.60 (PH3_BOOT0)
/CAN TO USB/CAN1_RX: U1.61 (PB8), U2.4 (RXD)
/CAN TO USB/CAN1_SHTD: U1.59 (PB7), U2.5 (SHTD)
/CAN TO USB/CAN1_STB: U1.58 (PB6), U2.8 (STB)
/CAN TO USB/CAN1_TX: U1.62 (PB9), U2.1 (TXD)
/CAN TO USB/CAN2_RX: U1.33 (PB12), U3.4 (RXD)
/CAN TO USB/CAN2_SHTD: U1.36 (PB15), U3.5 (SHTD)
/CAN TO USB/CAN2_STB: U1.35 (PB14), U3.8 (STB)
/CAN TO USB/CAN2_TX: U1.34 (PB13), U3.1 (TXD)
/CAN TO USB/EXTI_8: J15.2, U1.41 (PA8)
/CAN TO USB/EXTI_12: J13.6, U1.28 (PB2)
/CAN TO USB/EXTI_13: J7.15, U1.2 (PC13)
/CAN TO USB/EXTI_15: J7.16, U1.4 (PC15)
/CAN TO USB/FTDI1/3V3: C27.1, D10.2 (A), D11.2 (A), U5.3 (VCCIO), U5.10 (3V3OUT), U5.11 (~RESET)
/CAN TO USB/FTDI1/RXLED: R20.2, U5.7 (CBUS2)
/CAN TO USB/FTDI1/TXLED: R19.2, U5.14 (CBUS1)
/CAN TO USB/FTDI1/USB/DN: C29.1, J9.A7 (DN1_A), J9.B7 (DN2_B), R17.1
/CAN TO USB/FTDI1/USB/DP: C28.1, J9.A6 (DP1_A), J9.B6 (DP2_B), R18.1
/CAN TO USB/FTDI/3V3: C21.1, D8.2 (A), D9.2 (A), U4.3 (VCCIO), U4.10 (3V3OUT), U4.11 (~RESET)
/CAN TO USB/FTDI/RXLED: R14.2, U4.7 (CBUS2)
/CAN TO USB/FTDI/TXLED: R13.2, U4.14 (CBUS1)
/CAN TO USB/FTDI/USB/DN: C23.1, J8.A7 (DN1_A), J8.B7 (DN2_B), R11.1
/CAN TO USB/FTDI/USB/DP: C22.1, J8.A6 (DP1_A), J8.B6 (DP2_B), R12.1
/CAN TO USB/HSE_IN: U1.5 (PH0), X1.3 (OUTPUT)
/CAN TO USB/HSE_OE: U1.6 (PH1), X1.1 (TRI-STATE)
/CAN TO USB/I2C2_SCL: J13.5, R31.1, U1.29 (PB10)
/CAN TO USB/I2C2_SDA: J13.4, R30.1, U1.30 (PB11)
/CAN TO USB/LED1: RN1.16 (R), U1.37 (PC6)
/CAN TO USB/LED2: RN1.15 (R), U1.38 (PC7)
/CAN TO USB/LED3: RN1.14 (R), U1.39 (PC8)
/CAN TO USB/LED4: RN1.13 (R), U1.40 (PC9)
/CAN TO USB/LED5: RN1.12 (R), U1.57 (PB5)
/CAN TO USB/NRST: C31.1, J11.4, R6.2, SW2.3, U1.7 (NRST)
/CAN TO USB/OSC_32_IN: U1.3 (PC14), X2.3 (OUT)
/CAN TO USB/SPI3_CS1: J7.14, U1.50 (PA15)
/CAN TO USB/SPI3_CS2: J7.13, U1.54 (PD2)
/CAN TO USB/SPI3_MISO: J7.9, J7.10, U1.52 (PC11)
/CAN TO USB/SPI3_MOSI: J7.11, J7.12, U1.53 (PC12)
/CAN TO USB/SPI3_SCK: J7.7, J7.8, U1.51 (PC10)
/CAN TO USB/SYS_JTMS_SWCLK: J11.3, U1.49 (PA14)
/CAN TO USB/SYS_JTMS_SWDIO: J11.2, U1.46 (PA13)
/CAN TO USB/USART1_CTS: J15.6, U1.56 (PB4)
/CAN TO USB/USART1_RTS: J15.4, U1.55 (PB3)
/CAN TO USB/USART1_RX: J15.3, U1.43 (PA10)
/CAN TO USB/USART1_TX: J15.5, U1.42 (PA9)
/CAN TO USB/USART2_CTS: U1.14 (PA0), U5.2 (~RTS)
/CAN TO USB/USART2_RTS: U1.15 (PA1), U5.6 (~CTS)
/CAN TO USB/USART2_RX: U1.17 (PA3), U5.1 (TXD)
/CAN TO USB/USART2_TX: U1.16 (PA2), U5.4 (RXD)
/CAN TO USB/USART3_CTS: U1.22 (PA6), U4.2 (~RTS)
/CAN TO USB/USART3_RTS: U1.27 (PB1), U4.6 (~CTS)
/CAN TO USB/USART3_RX: U1.25 (PC5), U4.1 (TXD)
/CAN TO USB/USART3_TX: U1.24 (PC4), U4.4 (RXD)
/CAN TO USB/USB_OTG_FS_D+: J10.A6 (DP1_A), J10.B6 (DP2_B), U1.45 (PA12)
/CAN TO USB/USB_OTG_FS_D-: J10.A7 (DN1_A), J10.B7 (DN2_B), U1.44 (PA11)
/CAN TO USB/VBUS1: J2.6, J10.A4_B9 (VBUS), J10.B4_A9 (VBUS__1)
/CAN TO USB/VBUS2: C24.1, FB2.1, J2.4, J9.A4_B9 (VBUS), J9.B4_A9 (VBUS__1)
/CAN TO USB/VBUS3: C18.1, FB1.1, J2.2, J8.A4_B9 (VBUS), J8.B4_A9 (VBUS__1)
/INTERBOARD_CONNECTOR/3V3_1: J1.1, J5.11
/INTERBOARD_CONNECTOR/3V3_2: J1.3, J5.12
/INTERBOARD_CONNECTOR/3V3_3: J1.5, J5.13
/INTERBOARD_CONNECTOR/3V3_4: J1.7, J5.14
/INTERBOARD_CONNECTOR/3V3_5: J1.9, J5.15
/INTERBOARD_CONNECTOR/3V3_6: J1.11, J5.16
/INTERBOARD_CONNECTOR/3V3_7: J1.13, J5.17
/INTERBOARD_CONNECTOR/3V3_8: J1.15, J5.18
/INTERBOARD_CONNECTOR/3V3_9: J1.17, J5.19
/INTERBOARD_CONNECTOR/3V3_10: J1.19, J5.20
/INTERBOARD_CONNECTOR/3V3_11: J1.21, J5.21
/INTERBOARD_CONNECTOR/3V3_12: J1.23, J5.22
/INTERBOARD_CONNECTOR/3V3_13: J1.25, J5.23
/INTERBOARD_CONNECTOR/3V3_14: J1.27, J5.24
/INTERBOARD_CONNECTOR/3V3_15: J1.29, J5.25
/INTERBOARD_CONNECTOR/BATT: J4.1, J5.3, J5.4
/INTERBOARD_CONNECTOR/BATT_1: J4.3, J5.5
/INTERBOARD_CONNECTOR/BATT_2: J4.5, J5.6
/INTERBOARD_CONNECTOR/BATT_3: J4.7, J5.7
/INTERBOARD_CONNECTOR/BATT_4: J4.9, J5.8
/Regulator 3V3/LX1: L3.1, U7.3 (LX1)
/Regulator 3V3/LX2: L3.2, U7.2 (LX2)
/Regulator 3V3/R-: R4.1, R27.1, U7.8 (FB)
/Regulator 3V4/LX1: L4.1, U6.3 (LX1)
/Regulator 3V4/LX2: L4.2, U6.2 (LX2)
/Regulator 3V4/R-: R5.1, R26.1, U6.8 (FB)
/Regulator 4V2/LX1: L2.1, U8.3 (LX1)
/Regulator 4V2/LX2: L2.2, U8.2 (LX2)
/Regulator 4V2/R-: R3.1, R28.1, U8.8 (FB)
/Regulator 5V/LX1: L1.1, U9.3 (LX1)
/Regulator 5V/LX2: L1.2, U9.2 (LX2)
/Regulator 5V/R-: R2.1, R29.1, U9.8 (FB)
GND: C1.2, C2.2, C3.2, C4.2, C5.2, C6.2, C7.2, C8.2, C9.2, C10.2, C11.2, C12.1, C13.2, C14.2, C15.2, C16.1, C17.2, C18.2, C19.2, C20.2, C21.2, C22.2, C23.2, C24.2, C25.2, C26.2, C27.2, C28.2, C29.2, C30.2, C31.2, C32.2, C33.2, C34.2, C35.2, C36.2, C37.2, C38.2, C39.2, C40.2, C41.2, C42.2, C43.2, C44.2, D5.1 (A1), D6.3 (A), D7.3 (A), D12.1 (K), D13.1 (K), D14.1 (K), D15.1 (K), D16.1 (K), H1.1, H2.1, H3.1, H4.1, J3.1, J5.1, J5.2, J5.9, J5.10, J5.26, J5.27, J5.28, J5.35, J5.36, J7.1, J7.2, J8.A1_B12 (GND), J8.B1_A12 (GND__1), J9.A1_B12 (GND), J9.B1_A12 (GND__1), J10.A1_B12 (GND), J10.B1_A12 (GND__1), J11.1, J13.1, J14.1, J15.1, R15.1, R16.1, R21.1, R22.1, R23.1, R24.1, R25.2, R26.2, R27.2, R28.2, R29.2, SW2.4, U1.12 (VSSA), U1.18 (VSS), U1.31 (VSS), U1.47 (VSS), U1.63 (VSS), U2.2 (GND), U2.9 (GND), U3.2 (GND), U3.9 (GND), U4.5 (GND), U4.13 (GND), U5.5 (GND), U5.13 (GND), U6.6 (MODE), U6.7 (GND), U7.6 (MODE), U7.7 (GND), U8.6 (MODE), U8.7 (GND), U9.6 (MODE), U9.7 (GND), X1.2 (GND), X2.2 (GND)
unnamed: C11.1, R7.2, R8.1
unnamed: C15.1, R9.2, R10.1
unnamed: D1.2 (A), J2.5
unnamed: D2.2 (A), J2.3
unnamed: D3.2 (A), J2.1
unnamed: D4.2 (A), D5.2 (A2), J3.2
unnamed: D8.1 (K), R13.1
unnamed: D9.1 (K), R14.1
unnamed: D10.1 (K), R19.1
unnamed: D11.1 (K), R20.1
unnamed: D12.2 (A), RN1.1 (R)
unnamed: D13.2 (A), RN1.2 (R)
unnamed: D14.2 (A), RN1.3 (R)
unnamed: D15.2 (A), RN1.4 (R)
unnamed: D16.2 (A), RN1.5 (R)
unnamed: J8.A5 (CC1_A), R15.2
unnamed: J8.B5 (CC2_B), R16.2
unnamed: J9.A5 (CC1_A), R21.2
unnamed: J9.B5 (CC2_B), R22.2
unnamed: J10.A5 (CC1_A), R23.2
unnamed: J10.B5 (CC2_B), R24.2
unnamed: R11.2, U4.9 (USBDM)
unnamed: R12.2, U4.8 (USBDP)
unnamed: C19.1, C20.1, FB1.2, U4.12 (VCC)
unnamed: R17.2, U5.9 (USBDM)
unnamed: R18.2, U5.8 (USBDP)
unnamed: C25.1, C26.1, FB2.2, U5.12 (VCC)
VBUS: C35.1, C38.1, C41.1, C44.1, D1.1 (K), D2.1 (K), D3.1 (K), D4.1 (K), U6.4 (VIN), U6.5 (EN), U7.4 (VIN), U7.5 (EN), U8.4 (VIN), U8.5 (EN), U9.4 (VIN), U9.5 (EN)
