MatthiasGeorgImhof/Hardware_CSAT/eps_board/EPS.kicad_pcb

## KiCad design eps_board/EPS.kicad_pcb (2026-09-15)

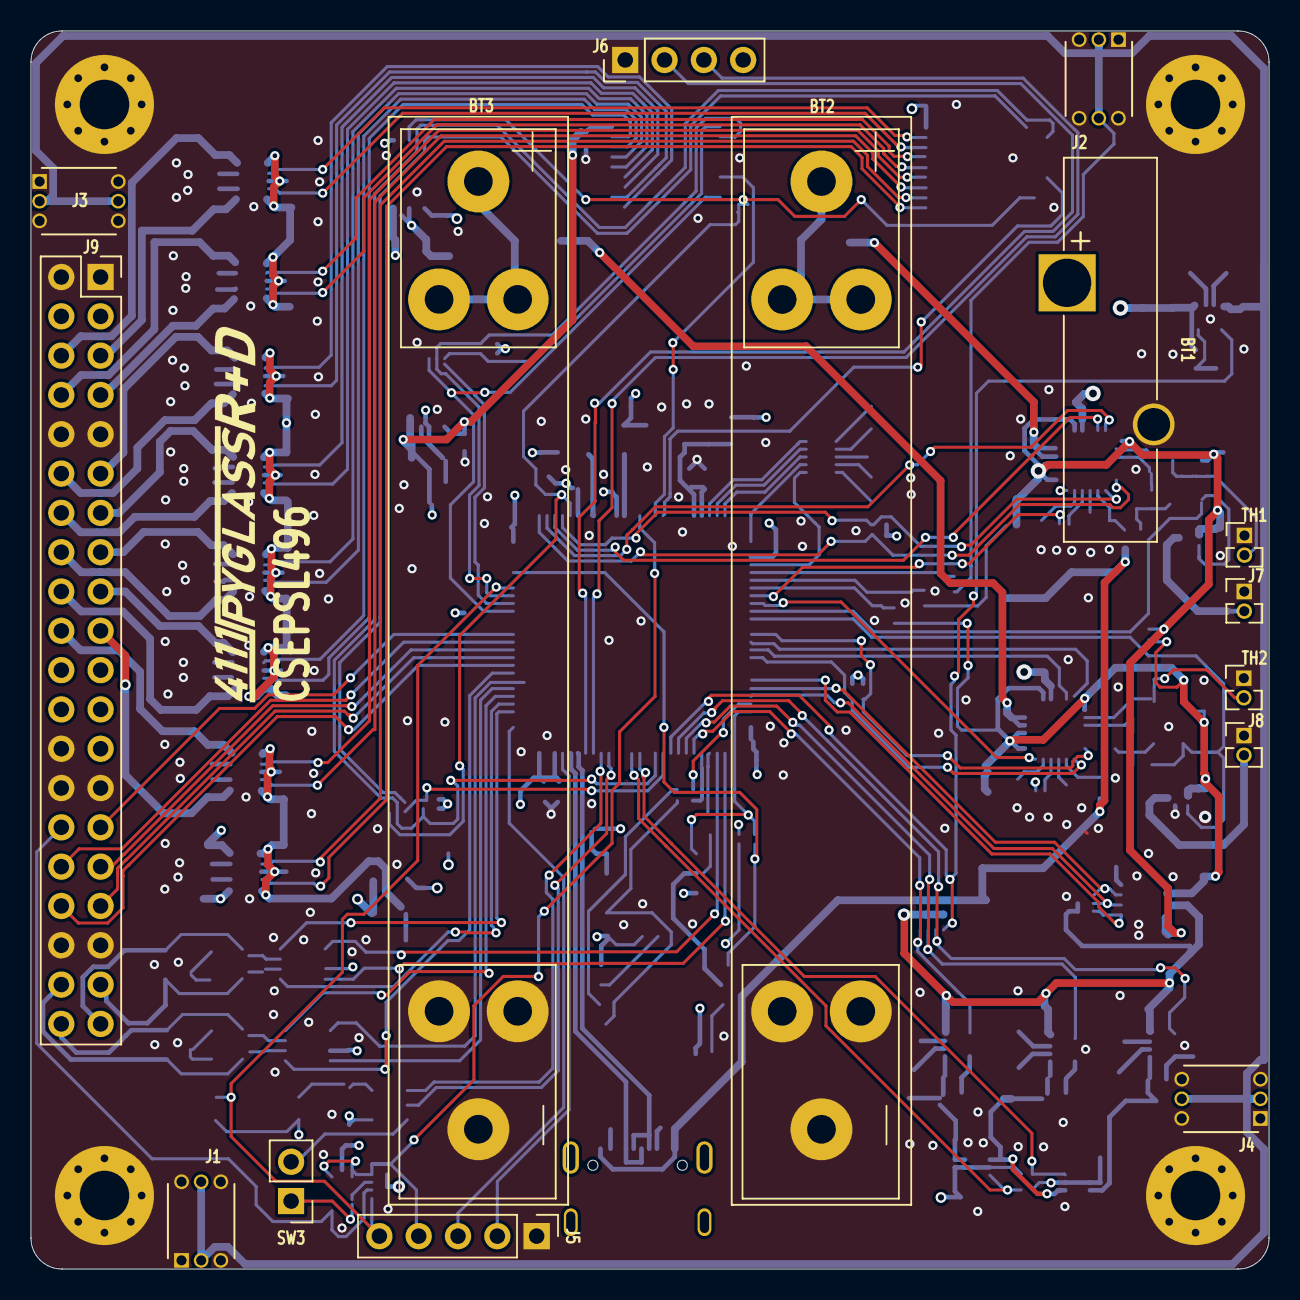
[picture p54: board EPS.kicad_pcb from above]

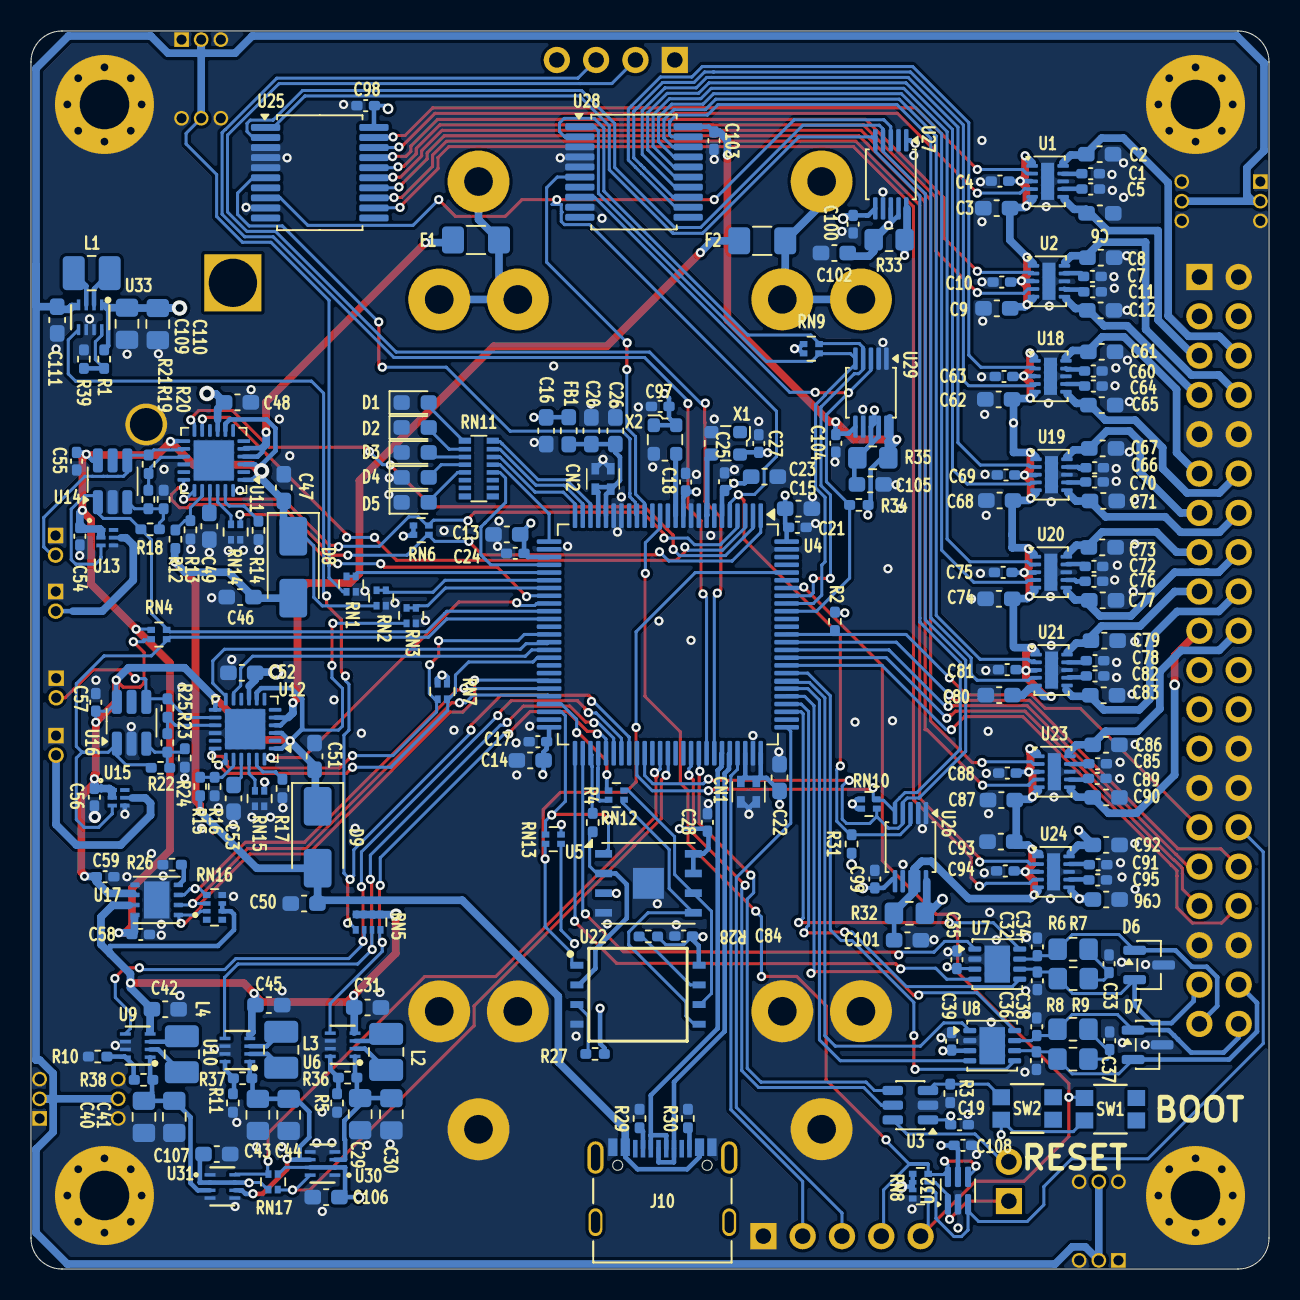
[picture p55: board EPS.kicad_pcb from below]

Board: 4 copper layers, 80.0 x 80.0 mm, 242 parts (223 on the bottom side), 187 nets.

Parts:
BT1: CR2450; Battery_Panasonic_CR2450-VAN_Vertical_CircularHoles
BT2, BT3: Battery_Cell; BatteryHolder_Keystone_54_v2_1x18650
C1, C5, C7, C11, C60, C64, C66, C70, C72, C76, C78, C82, C85, C89, C91, C95: 220pF; C_0402_1005Metric_Pad0.74x0.62mm_HandSolder
C2, C6, C8, C12, C61, C65, C67, C71, C73, C77, C79, C83, C86, C90, C92, C96: 10u; C_0603_1608Metric_Pad1.08x0.95mm_HandSolder
C3, C9, C62, C68, C74, C80, C87, C93: 22u; C_0603_1608Metric_Pad1.08x0.95mm_HandSolder
C4, C10, C27, C28, C35, C39, C63, C69, C75, C81, C84, C88, C94, C97, C108: 100n; C_0402_1005Metric_Pad0.74x0.62mm_HandSolder
C13, C14, C15, C16, C20, C22, C23, C26, C101, C102, C105, C106, C107: 10uF; C_0603_1608Metric_Pad1.08x0.95mm_HandSolder
C17, C18, C19, C21, C24, C25, C54, C55, C56, C57, C58, C59, C98, C99, C100, C103, C104: 100nF; C_0402_1005Metric_Pad0.74x0.62mm_HandSolder
C29, C30, C40, C41, C43, C44, C109, C110: 47uF; C_0805_2012Metric_Pad1.18x1.45mm_HandSolder
C31, C42, C45, C111: 22uF; C_0603_1608Metric_Pad1.08x0.95mm_HandSolder
C32, C34, C36, C38: 100p; C_0402_1005Metric_Pad0.74x0.62mm_HandSolder
C33, C37: 4n7; C_0402_1005Metric_Pad0.74x0.62mm_HandSolder
C46, C47, C48, C49, C50, C51, C52, C53: 4.7uF; C_0603_1608Metric_Pad1.08x0.95mm_HandSolder
CN1, CN2: 100nF; W2A2-X
D1: RED; LED_0603_1608Metric_Pad1.05x0.95mm_HandSolder
D2: GREEN; LED_0603_1608Metric_Pad1.05x0.95mm_HandSolder
D3, D4, D5: YELLOW; LED_0603_1608Metric_Pad1.05x0.95mm_HandSolder
D6, D7: NUP2105LT1G; SOT-23
D8, D9: NRVBA210LNT3G; D_SMA
F1, F2: Polyfuse; Fuse_1206_3216Metric_Pad1.42x1.75mm_HandSolder
FB1: 120R; L_0603_1608Metric_Pad1.05x0.95mm_HandSolder
H1, H2, H3, H4: MountingHole_Pad; MountingHole_3.2mm_M3_Pad_Via
J1, J2, J3, J4: Conn_02x03_Odd_Even; HARWIN_M50-3200345
J5: Conn_01x05_Pin Vertical; PinHeader_1x05_P2.54mm_Vertical
J6: Conn_01x04_Pin Vertical; PinHeader_1x04_P2.54mm_Vertical
J7, J8: Conn_01x02; PinHeader_1x02_P1.27mm_Vertical
J9: PC104 Conn_02x20_Odd_Even; PinSocket_2x20_P2.54mm_Vertical
J10: 10155435-00011LF; AMPHENOL_10155435-00011LF
L1, L2, L3, L4: 1uH; L_1008_2520Metric_Pad1.43x2.20mm_HandSolder
R1: 806K; R_0402_1005Metric_Pad0.72x0.64mm_HandSolder
R2: 330K; R_0402_1005Metric_Pad0.72x0.64mm_HandSolder
R3: 22K; R_0402_1005Metric_Pad0.72x0.64mm_HandSolder
R4: 22R; R_0402_1005Metric_Pad0.72x0.64mm_HandSolder
R5, R10, R11, R39: 91K; R_0402_1005Metric_Pad0.72x0.64mm_HandSolder
R6, R7, R8, R9: 60R4; R_0805_2012Metric_Pad1.20x1.40mm_HandSolder
R12, R15: 26.7K; R_0402_1005Metric_Pad0.72x0.64mm_HandSolder
R13, R16, R21, R25: 10K; R_0402_1005Metric_Pad0.72x0.64mm_HandSolder
R14, R17: 1M; R_0402_1005Metric_Pad0.72x0.64mm_HandSolder
R18, R22: DNP; R_0402_1005Metric_Pad0.72x0.64mm_HandSolder
R19, R23, R27, R28, R31, R34: 100K; R_0402_1005Metric_Pad0.72x0.64mm_HandSolder
R20, R24: 280K; R_0402_1005Metric_Pad0.72x0.64mm_HandSolder
R26: 330R; R_0402_1005Metric_Pad0.72x0.64mm_HandSolder
R29, R30: 5K1; R_0402_1005Metric_Pad0.72x0.64mm_HandSolder
R32, R33, R35: 10m; R_0805_2012Metric_Pad1.20x1.40mm_HandSolder
R36, R38: 511K; R_0402_1005Metric_Pad0.72x0.64mm_HandSolder
R37: 490K; R_0402_1005Metric_Pad0.72x0.64mm_HandSolder
RN1, RN2, RN3, RN4, RN6, RN7, RN13: 100K; R_Array_Convex_2x0402_widepads
RN5, RN8, RN16: 100K; R_Array_Convex_4x0402_widepads
RN9, RN10: 5K6; R_Array_Convex_2x0402_widepads
RN11: 1K; R_Array_Convex_8x0602_widepads
RN12: 22R; R_Array_Convex_2x0402_widepads
RN14, RN15, RN17: 10K; R_Array_Convex_2x0402_widepads
SW1, SW2: EVP-AA602W; EVP602AA
SW3: Conn_01x02_Pin Vertical; PinHeader_1x02_P2.54mm_Vertical
TH1, TH2: Thermistor_NTC; PinHeader_1x02_P1.27mm_Vertical
U1, U2, U18, U19, U20, U21, U23, U24: TPS22968QDMGRQ1; WSON-10-1EP_2x3mm_P0.5mm_EP0.84x2.4mm
U3: TPL5010; SOT-23-6
U4: STM32L496VGTx; LQFP-100_14x14mm_P0.5mm
U5: MR25H10; DFN-8-1EP_6x5mm_P1.27mm_EP2x2mm
U6, U9, U10, U33: TPS631000DRLR; TPS631000DRLR_TEX
U7, U8: TCAN3414; VSON-8-1EP_3x3mm_P0.65mm_EP1.65x2.4mm
U11, U12: LTC4066; QFN-24-1EP_4x4mm_P0.5mm_EP2.6x2.6mm
U13, U15: TPS22995; WQFN-HR6_RZG_TEX
U14, U16: MCP65R46; SOT-23-6_Handsoldering
U17: TPS2115ADRBR; SON65P300X300X100-9N
U22: MT29F4G01ABAFDWB-IT:F TR; SON127P800X600X65-8N
U25, U28: MCP23008T-E/SS; SSOP-20_5.3x7.2mm_P0.65mm
U26, U27: INA226AIDGSR; VSSOP-10_3x3mm_P0.5mm
U29: INA226; VSSOP-10_3x3mm_P0.5mm
U30, U31: LM66200DRLR; SOT-5X3_DRL_TEX
U32: 74LVC2G07; SOT-363_SC-70-6
X1: 32.768KHZ; Oscillator_SMD_ECS_2520MV-xxx-xx-4Pin_2.5x2.0mm
X2: 10MHz; Oscillator_SMD_ECS_2520MV-xxx-xx-4Pin_2.5x2.0mm

Connections:
+3V3: C103.1, C104.1, C107.1, R34.1, R35.1, RN17.3 (R2.2), U28.20 (VDD), U29.6 (VS), U29.10 (IN+), U31.2 (VOUT), U31.7 (VOUT)
+3V3_CORE: C13.1, C14.1, C15.1, C16.1, C17.1, C18.1, C19.1, C21.2, C22.2, C24.1, C27.1, C35.1, C39.1, C97.1, C98.1, C99.1, C100.1, C106.1, C108.2, CN1.1, CN1.2, FB1.1, J6.4, R2.1, R31.1, R32.1, RN6.1 (R1.1), RN6.2 (R2.1), RN7.1 (R1.1), RN7.2 (R2.1), RN8.5 (R4.2), RN8.6 (R3.2), RN8.7 (R2.2), RN9.1 (R1.1), RN9.2 (R2.1), RN10.1 (R1.1), RN10.2 (R2.1), RN17.1 (R1.1), SW1.2, SW2.2, U3.1 (VDD), U4.11 (VDD), U4.28 (VDD), U4.50 (VDD), U4.73 (VDDUSB), U4.75 (VDD), U4.100 (VDD), U7.3 (VCC), U8.3 (VCC), U25.20 (VDD), U26.6 (VS), U26.10 (IN+), U27.1 (A1), U27.6 (VS), U30.2 (VOUT), U30.7 (VOUT), U32.5 (VCC), X1.4 (VCC), X2.1 (TRI-STATE), X2.4 (VDD)
/3V3_1: C61.1, J9.11, U18.10 (VOUT1)
/3V3_2: C65.2, J9.12, U18.6 (VOUT2)
/3V3_3: C67.1, J9.13, U19.10 (VOUT1)
/3V3_4: C71.2, J9.14, U19.6 (VOUT2)
/3V3_5: C73.1, J9.15, U20.10 (VOUT1)
/3V3_6: C77.2, J9.16, U20.6 (VOUT2)
/3V3_7: C79.1, J9.17, U21.10 (VOUT1)
/3V3_8: C83.2, J9.18, U21.6 (VOUT2)
/3V3_9: C90.2, J9.19, U23.6 (VOUT2)
/3V3_10: C86.1, J9.20, U23.10 (VOUT1)
/3V3_EPS_FLASH: C84.1, C96.2, R27.1, R28.1, RN13.1 (R1.1), U22.8 (VCC), U24.6 (VOUT2)
/3V3_EPS_MRAM: C28.1, C92.1, RN13.2 (R2.1), U5.3 (~WP), U5.7 (~HOLD), U5.8 (VDD), U24.10 (VOUT1)
/*BC_1_CHRG: RN6.3 (R2.2), U4.1 (PE2), U11.18 (~CHRG)
/*BC_2_CHRG: RN7.3 (R2.2), U4.38 (PE7), U12.18 (~CHRG)
/*IDEAL_STATUS: RN16.3 (R3.1), U4.44 (PE13), U17.1 (STAT)
/ADC_SOLAR_RAW: RN1.3 (R2.2), RN1.4 (R1.2), U4.30 (PA5)
/ADC_VOUT1: RN2.3 (R2.2), RN2.4 (R1.2), U4.31 (PA6)
/ADC_VOUT2: RN3.3 (R2.2), RN3.4 (R1.2), U4.32 (PA7)
/ATTENTION: J9.29, R2.2, U4.88 (PD7)
/AVI_EXTRN_RST: J9.32, U4.87 (PD6)
/BATTERY_1/NTC: R21.2, TH1.2, U11.14 (NTC), U14.4 (-)
/BATTERY_1/VBAT: F1.1, U11.4 (BAT), U11.5 (BAT)
/BATTERY_1/VNTC: R19.1, R21.1, U11.15 (VNTC)
/BATTERY_2/NTC: R25.2, TH2.2, U12.14 (NTC), U16.4 (-)
/BATTERY_2/VBAT: F2.1, U12.4 (BAT), U12.5 (BAT)
/BATTERY_2/VNTC: R23.1, R25.1, U12.15 (VNTC)
/BATTERY_CHARGER_1/CLPROG: RN14.2 (R2.1), U11.22 (CLPROG)
/BATTERY_CHARGER_2/CLPROG: RN15.2 (R2.1), U12.22 (CLPROG)
/BATT_1: C6.2, J9.5, U1.6 (VOUT2)
/BATT_2: C2.1, J9.6, U1.10 (VOUT1)
/BATT_3: C12.2, J9.7, U2.6 (VOUT2)
/BATT_4: C8.1, J9.8, U2.10 (VOUT1)
/BC_1_ISTAT: RN14.1 (R1.1), U4.33 (PC4), U11.24 (ISTAT)
/BC_1_POL: RN6.4 (R1.2), U4.4 (PE5), U11.19 (POL)
/BC_1_SHDN: U4.2 (PE3), U11.12 (SHDN)
/BC_1_SUSP: U4.3 (PE4), U11.11 (SUSP)
/BC_2_ISTAT: RN15.1 (R1.1), U4.34 (PC5), U12.24 (ISTAT)
/BC_2_POL: RN7.4 (R1.2), U4.41 (PE10), U12.19 (POL)
/BC_2_SHDN: U4.39 (PE8), U12.12 (SHDN)
/BC_2_SUSP: U4.40 (PE9), U12.11 (SUSP)
/BOOT: J5.5, RN8.1 (R1.1), SW1.1, U4.94 (PH3)
/Boost Buck Regulator 5V1/LX1: L1.2, U33.3 (LX1)
/Boost Buck Regulator 5V1/LX2: L1.1, U33.2 (LX2)
/Boost Buck Regulator 5V1/R-: R1.2, R39.1, U33.8 (FB)
/CAN1_H: C36.1, D7.1 (K), J9.40, R8.1, U8.7 (CANH)
/CAN1_L: C38.2, D7.2 (K), J9.38, R9.2, U8.6 (CANL)
/CAN2_H: C32.1, D6.1 (K), J9.39, R6.1, U7.7 (CANH)
/CAN2_L: C34.2, D6.2 (K), J9.37, R7.2, U7.6 (CANL)
/COMM1_RST: J9.33, U4.85 (PD4)
/COMM2_RST: J9.34, U4.84 (PD3)
/EPS_EXTRN_RST: J9.30, RN8.2 (R2.1), U32.3 (IN2)
/HEATER1_ENABLED: R18.1, RN4.4 (R1.2), U4.35 (PB0), U13.3 (EN), U14.1
/HEATER2_ENABLED: R22.1, RN4.3 (R2.2), U4.36 (PB1), U15.3 (EN), U16.1
/I2C1_SCL: RN9.3 (R2.2), U4.92 (PB6), U28.1 (SCL), U29.5 (SCL)
/I2C1_SDA: RN9.4 (R1.2), U4.93 (PB7), U28.2 (SDA), U29.4 (SDA)
/I2C4_SCL: RN10.4 (R1.2), U4.59 (PD12), U25.1 (SCL), U26.5 (SCL), U27.5 (SCL)
/I2C4_SDA: RN10.3 (R2.2), U4.60 (PD13), U25.2 (SDA), U26.4 (SDA), U27.4 (SDA)
/I2C Power Switches 3VAUX/ENABLE_0: U18.2 (ON1), U28.12 (GP0)
/I2C Power Switches 3VAUX/ENABLE_1: U18.4 (ON2), U28.13 (GP1)
/I2C Power Switches 3VAUX/ENABLE_2: U19.2 (ON1), U28.14 (GP2)
/I2C Power Switches 3VAUX/ENABLE_3: U19.4 (ON2), U28.15 (GP3)
/I2C Power Switches 3VAUX/ENABLE_4: U20.2 (ON1), U28.16 (GP4)
/I2C Power Switches 3VAUX/ENABLE_5: U20.4 (ON2), U28.17 (GP5)
/I2C Power Switches 3VAUX/ENABLE_6: U21.2 (ON1), U28.18 (GP6)
/I2C Power Switches 3VAUX/ENABLE_7: U21.4 (ON2), U28.19 (GP7)
/I2C Power Switches 3VAUX/VBUS: C62.1, C63.1, C68.1, C69.1, C74.1, C75.1, C80.1, C81.1, C105.1, R35.2, U18.1 (VIN1), U18.3 (VBIAS), U18.5 (VIN2), U19.1 (VIN1), U19.3 (VBIAS), U19.5 (VIN2), U20.1 (VIN1), U20.3 (VBIAS), U20.5 (VIN2), U21.1 (VIN1), U21.3 (VBIAS), U21.5 (VIN2), U29.8 (VBUS), U29.9 (IN-)
/I2C Power Switches 3VCORE/3V3_METERED: C87.1, C88.1, C93.1, C94.1, C101.1, R32.2, U23.1 (VIN1), U23.3 (VBIAS), U23.5 (VIN2), U24.1 (VIN1), U24.3 (VBIAS), U24.5 (VIN2), U26.8 (VBUS), U26.9 (IN-)
/I2C Power Switches 3VCORE/ENABLE0: U24.4 (ON2), U25.12 (GP0)
/I2C Power Switches 3VCORE/ENABLE1: U24.2 (ON1), U25.13 (GP1)
/I2C Power Switches 3VCORE/ENABLE2: U23.4 (ON2), U25.14 (GP2)
/I2C Power Switches 3VCORE/ENABLE3: U23.2 (ON1), U25.15 (GP3)
/I2C Power Switches 3VCORE/ENABLE4: U2.4 (ON2), U25.16 (GP4)
/I2C Power Switches 3VCORE/ENABLE5: U2.2 (ON1), U25.17 (GP5)
/I2C Power Switches 3VCORE/ENABLE6: U1.4 (ON2), U25.18 (GP6)
/I2C Power Switches 3VCORE/ENABLE7: U1.2 (ON1), U25.19 (GP7)
/I2C Power Switches 3VCORE/VBUS_METERED: C3.1, C4.1, C9.1, C10.1, C102.1, R33.2, U1.1 (VIN1), U1.3 (VBIAS), U1.5 (VIN2), U2.1 (VIN1), U2.3 (VBIAS), U2.5 (VIN2), U27.8 (VBUS), U27.9 (IN-)
/IDEAL_DO0: RN16.2 (R2.1), U4.46 (PE15), U17.2 (D0)
/IDEAL_DO1: RN16.1 (R1.1), U4.45 (PE14), U17.3 (D1)
/INT_PS_3V3: R34.2, U4.91 (PB5), U28.8 (INT), U29.3 (ALERT)
/INT_PS_CORE_VBUS: R31.2, U4.5 (PE6), U25.8 (INT), U26.3 (ALERT), U27.3 (ALERT)
/NRST: J5.4, RN8.4 (R4.1), U4.14 (NRST), U32.4 (OUT2), U32.6 (OUT1)
/PMIC/CAN1_RX: U4.81 (PD0), U8.4 (RXD)
/PMIC/CAN1_SHDN: U4.83 (PD2), U8.5 (SHTD)
/PMIC/CAN1_STBY: U4.80 (PC12), U8.8 (STB)
/PMIC/CAN1_TX: U4.82 (PD1), U8.1 (TXD)
/PMIC/CAN2_RX: U4.51 (PB12), U7.4 (RXD)
/PMIC/CAN2_SHDN: U4.79 (PC11), U7.5 (SHTD)
/PMIC/CAN2_STBY: U4.78 (PC10), U7.8 (STB)
/PMIC/CAN2_TX: U4.52 (PB13), U7.1 (TXD)
/PMIC/HSE_CLK: U4.12 (PH0), X2.3 (OUTPUT)
/PMIC/LED_1: RN11.16 (R), U4.23 (PA0)
/PMIC/LED_2: RN11.15 (R), U4.24 (PA1)
/PMIC/LED_3: RN11.14 (R), U4.25 (PA2)
/PMIC/LED_4: RN11.13 (R), U4.26 (PA3)
/PMIC/LED_5: RN11.12 (R), U4.29 (PA4)
/PMIC/RCC_OSC32_IN: U4.8 (PC14), X1.3 (OUT)
/PMIC/SPI2_FLASH_CS: RN13.4 (R1.2), U4.96 (PB9), U22.1 (CS#)
/PMIC/SPI2_MISO: R4.2, U4.53 (PB14)
/PMIC/SPI2_MOSI: RN12.2 (R2.1), U4.54 (PB15)
/PMIC/SPI2_MRAM_CS: RN13.3 (R2.2), U4.48 (PB11), U5.1 (~CS)
/PMIC/SPI2_SCK: RN12.1 (R1.1), U4.47 (PB10)
/PMIC/SPI_MISO: R4.1, U5.2 (SO), U22.2 (SO/IO1)
/PMIC/SPI_MOSI: RN12.3 (R2.2), U5.5 (SI), U22.5 (SI/IO0)
/PMIC/SPI_SCK: RN12.4 (R1.2), U5.6 (SCK), U22.6 (SCK)
/PMIC/SWD_SWCLK: J5.3, U4.76 (PA14)
/PMIC/SWD_SWDIO: J5.2, U4.72 (PA13)
/PMIC/USART1_RX: J6.2, U4.69 (PA10)
/PMIC/USART1_TX: J6.3, U4.68 (PA9)
/PMIC/VDAA: C20.1, C26.2, CN2.1, CN2.2, FB1.2, U4.21 (VREF+), U4.22 (VDDA)
/POWER_3V3_RST: U4.16 (PC1), U28.6 (*RESET)
/POWER_CORE_VBUS_RST: U4.17 (PC2), U25.6 (*RESET)
/PWR3AUX_EN: RN5.3 (R3.1), U4.56 (PD9), U10.5 (EN)
/PWR3CORE_EN: RN5.4 (R4.1), U4.55 (PD8), U6.5 (EN)
/PWR3MAIN_EN: RN5.2 (R2.1), U4.57 (PD10), U9.5 (EN)
/Power Selector/Boost Buck Regulator 3V3/LX1: L2.2, U6.3 (LX1)
/Power Selector/Boost Buck Regulator 3V3/LX2: L2.1, U6.2 (LX2)
/Power Selector/Boost Buck Regulator 3V3/R+: C29.1, C30.1, R36.1, U6.1 (VOUT), U30.3 (VIN1)
/Power Selector/Boost Buck Regulator 3V3/R-: R5.1, R36.2, U6.8 (FB)
/Power Selector/Boost Buck Regulator 3V4/LX1: L4.2, U9.3 (LX1)
/Power Selector/Boost Buck Regulator 3V4/LX2: L4.1, U9.2 (LX2)
/Power Selector/Boost Buck Regulator 3V4/R+: C40.1, C41.1, R38.1, U9.1 (VOUT), U31.3 (VIN1)
/Power Selector/Boost Buck Regulator 3V4/R-: R10.1, R38.2, U9.8 (FB)
/Power Selector/Boost Buck Regulator 3V5/LX1: L3.2, U10.3 (LX1)
/Power Selector/Boost Buck Regulator 3V5/LX2: L3.1, U10.2 (LX2)
/Power Selector/Boost Buck Regulator 3V5/R+: C43.1, C44.1, R37.1, U10.1 (VOUT), U30.6 (VIN2), U31.6 (VIN2)
/Power Selector/Boost Buck Regulator 3V5/R-: R11.1, R37.2, U10.8 (FB)
/RST: RN8.3 (R3.1), SW3.1, U32.1 (IN1)
/SCI_EXTRN_RST: J9.31, U4.86 (PD5)
/SOLAR_EN: RN5.1 (R1.1), U4.58 (PD11), U33.5 (EN)
/STATUS_3V3: RN17.2 (R2.1), U4.62 (PD15), U31.8 (ST)
/STATUS_CORE: RN17.4 (R1.2), U4.63 (PC6), U30.8 (ST)
/USB_DN: J10.A7 (DN1_A), J10.B7 (DN2_B), U4.70 (PA11)
/USB_DP: J10.A6 (DP1_A), J10.B6 (DP2_B), U4.71 (PA12)
/VEXT: C46.1, C50.1, D8.2 (A), D9.2 (A), J10.A4_B9 (VBUS), J10.B4_A9 (VBUS__1), R12.2, R15.2
/VOUT1: C47.1, C54.1, C55.1, C58.2, D8.1 (K), RN2.1 (R1.1), RN4.1 (R1.1), U11.1 (OUT), U11.3 (OUT), U11.8 (OUT), U11.13 (HPWR), U13.1 (VBIAS), U13.2 (VIN), U14.6 (V+), U17.8 (IN1)
/VOUT2: C51.1, C56.1, C57.1, C59.2, D9.1 (K), RN3.1 (R1.1), RN4.2 (R2.1), U12.1 (OUT), U12.3 (OUT), U12.8 (OUT), U12.13 (HPWR), U15.1 (VBIAS), U15.2 (VIN), U16.6 (V+), U17.6 (IN2)
/VSOLAR_5V: C48.1, C52.1, C109.1, C110.1, R1.1, U11.9 (IN), U12.9 (IN), U33.1 (VOUT)
/VSOLAR_RAW: C111.1, J1.3, J1.4, J2.3, J2.4, J3.3, J3.4, J4.3, J4.4, RN1.1 (R1.1), U33.4 (VIN)
/WATCHDOG_DONE: U3.4 (DONE), U4.67 (PA8)
/WATCHDOG_WAKE: U3.5 (WAKE), U4.66 (PC9)
GND: BT1.2 (-), BT2.2 (-), BT3.2 (-), C1.2, C2.2, C3.2, C4.2, C5.1, C6.1, C7.2, C8.2, C9.2, C10.2, C11.1, C12.1, C13.2, C14.2, C15.2, C16.2, C17.2, C18.2, C19.2, C20.2, C21.1, C22.1, C23.2, C24.2, C25.2, C26.1, C27.2, C28.2, C29.2, C30.2, C31.2, C32.2, C33.2, C34.1, C35.2, C36.2, C37.2, C38.1, C39.2, C40.2, C41.2, C42.2, C43.2, C44.2, C45.2, C46.2, C47.2, C48.2, C49.2, C50.2, C51.2, C52.2, C53.2, C54.2, C55.2, C56.2, C57.2, C58.1, C59.1, C60.2, C61.2, C62.2, C63.2, C64.1, C65.1, C66.2, C67.2, C68.2, C69.2, C70.1, C71.1, C72.2, C73.2, C74.2, C75.2, C76.1, C77.1, C78.2, C79.2, C80.2, C81.2, C82.1, C83.1, C84.2, C85.2, C86.2, C87.2, C88.2, C89.1, C90.1, C91.2, C92.2, C93.2, C94.2, C95.1, C96.1, C97.2, C98.2, C99.2, C100.2, C101.2, C102.2, C103.2, C104.2, C105.2, C106.2, C107.2, C108.1, C109.2, C110.2, C111.2, CN1.3, CN1.4, CN2.3, CN2.4, D1.1 (K), D2.1 (K), D3.1 (K), D4.1 (K), D5.1 (K), D6.3 (A), D7.3 (A), H1.1, H2.1, H3.1, H4.1, J1.1, J1.2, J1.5, J1.6, J2.1, J2.2, J2.5, J2.6, J3.1, J3.2, J3.5, J3.6, J4.1, J4.2, J4.5, J4.6, J5.1, J6.1, J7.1, J8.1, J9.1, J9.2, J9.9, J9.10, J9.26, J9.27, J9.28, J9.35, J9.36, J10.A1_B12 (GND), J10.B1_A12 (GND__1), R3.2, R5.2, R10.2, R11.2, R13.1, R14.1, R16.1, R17.1, R20.2, R24.2, R26.2, R29.2, R30.1, R39.2, RN1.2 (R2.1), RN2.2 (R2.1), RN3.2 (R2.1), RN8.8 (R1.2), RN14.3 (R2.2), RN14.4 (R1.2), RN15.3 (R2.2), RN15.4 (R1.2), RN16.8 (R1.2), TH1.1, TH2.1, U1.8 (GND), U1.11 (TPAD), U2.8 (GND), U2.11 (TPAD), U3.2 (GND), U4.10 (VSS), U4.19 (VSSA), U4.20 (VREF-), U4.27 (VSS), U4.49 (VSS), U4.74 (VSS), U4.99 (VSS), U5.4 (VSS), U5.9 (PAD), U6.6 (MODE), U6.7 (GND), U7.2 (GND), U7.9 (GND), U8.2 (GND), U8.9 (GND), U9.6 (MODE), U9.7 (GND), U10.6 (MODE), U10.7 (GND), U11.16 (GND), U11.25 (GND), U12.16 (GND), U12.25 (GND), U13.4 (GND), U14.2 (V-), U15.4 (GND), U16.2 (V-), U17.5 (GND), U17.9 (EXP), U18.8 (GND), U18.11 (TPAD), U19.8 (GND), U19.11 (TPAD), U20.8 (GND), U20.11 (TPAD), U21.8 (GND), U21.11 (TPAD), U22.4 (VSS), U23.8 (GND), U23.11 (TPAD), U24.8 (GND), U24.11 (TPAD), U25.3 (A2), U25.4 (A1), U25.5 (A0), U25.9 (VSS), U26.1 (A1), U26.2 (A0), U26.7 (GND), U27.2 (A0), U27.7 (GND), U28.3 (A2), U28.4 (A1), U28.5 (A0), U28.9 (VSS), U29.1 (A1), U29.2 (A0), U29.7 (GND), U30.1 (GND), U30.4 (ON), U30.5 (GND), U31.1 (GND), U31.4 (ON), U31.5 (GND), U32.2 (GND), U33.6 (MODE), U33.7 (GND), X1.2 (GND), X2.2 (GND)
unnamed: BT1.1 (+), C23.1, C25.1, U4.6 (VBAT)
unnamed: BT2.1 (+), F1.2
unnamed: BT3.1 (+), F2.2
unnamed: C33.1, R6.2, R7.1
unnamed: C37.1, R8.2, R9.1
unnamed: D1.2 (A), RN11.1 (R)
unnamed: D2.2 (A), RN11.2 (R)
unnamed: D3.2 (A), RN11.3 (R)
unnamed: D4.2 (A), RN11.4 (R)
unnamed: D5.2 (A), RN11.5 (R)
unnamed: J7.2, U13.5 (VOUT)
unnamed: J8.2, U15.5 (VOUT)
unnamed: J10.A5 (CC1_A), R29.1
unnamed: J10.B5 (CC2_B), R30.2
unnamed: C1.1, U1.9 (CT1)
unnamed: C5.2, U1.7 (CT2)
unnamed: C7.1, U2.9 (CT1)
unnamed: C11.2, U2.7 (CT2)
unnamed: R3.1, SW2.1, U3.3 (DELAY/M_RST)
unnamed: SW3.2, U3.6 (~RST)
unnamed: R14.2, U11.23 (PROG)
unnamed: C49.1, U11.21 (TIMER)
unnamed: R12.1, R13.2, U11.20 (WALL)
unnamed: R17.2, U12.23 (PROG)
unnamed: C53.1, U12.21 (TIMER)
unnamed: R15.1, R16.2, U12.20 (WALL)
unnamed: R18.2, R19.2, R20.1, U14.3 (+)
unnamed: R22.2, R23.2, R24.1, U16.3 (+)
unnamed: R26.1, U17.4 (ILIM)
unnamed: C60.1, U18.9 (CT1)
unnamed: C64.2, U18.7 (CT2)
unnamed: C66.1, U19.9 (CT1)
unnamed: C70.2, U19.7 (CT2)
unnamed: C72.1, U20.9 (CT1)
unnamed: C76.2, U20.7 (CT2)
unnamed: C78.1, U21.9 (CT1)
unnamed: C82.2, U21.7 (CT2)
unnamed: R28.2, U22.7 (HOLD#/IO3)
unnamed: R27.2, U22.3 (WP#/IO2)
unnamed: C85.1, U23.9 (CT1)
unnamed: C89.2, U23.7 (CT2)
unnamed: C91.1, U24.9 (CT1)
unnamed: C95.2, U24.7 (CT2)
VBUS: C31.1, C42.1, C45.1, J9.3, J9.4, R33.1, RN5.5 (R4.2), RN5.6 (R3.2), RN5.7 (R2.2), RN5.8 (R1.2), RN16.6 (R3.2), RN16.7 (R2.2), U6.4 (VIN), U9.4 (VIN), U10.4 (VIN), U17.7 (OUT), U27.10 (IN+)
