MatthiasGeorgImhof/Hardware_CSAT/sci_extra/bodge/bodge.kicad_pcb

## KiCad design sci_extra/bodge/bodge.kicad_pcb (2026-06-08)

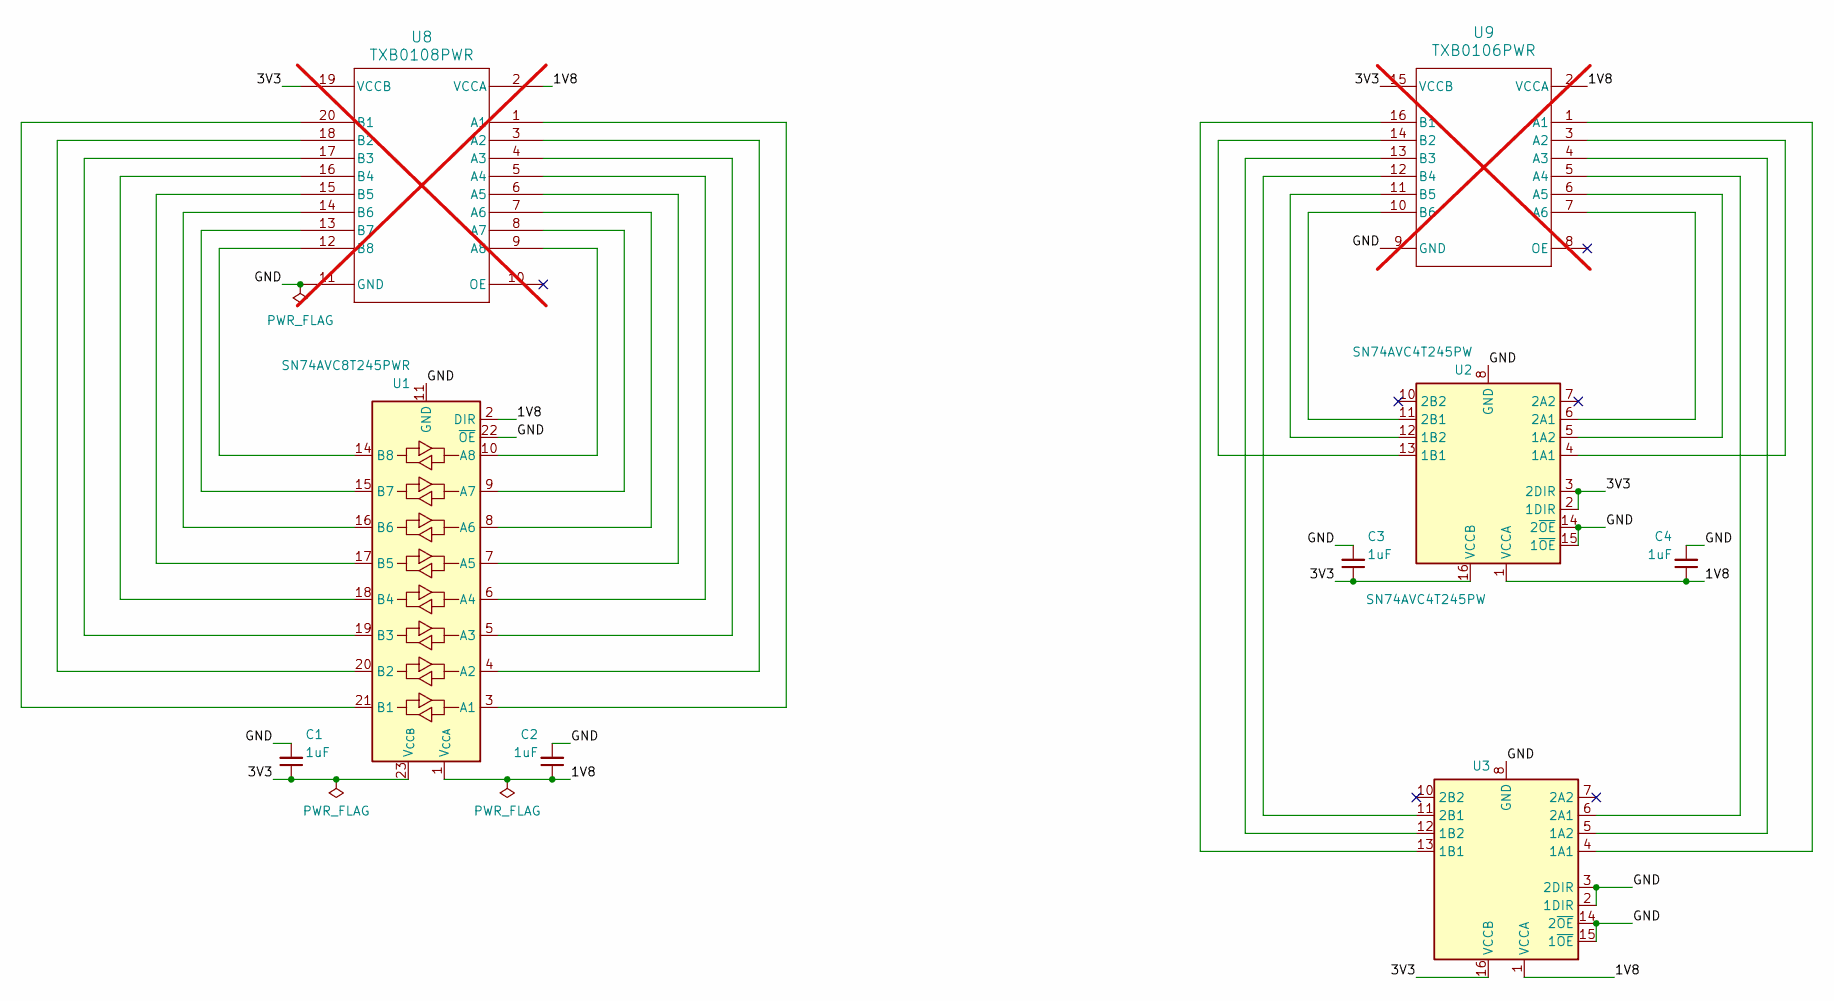
[picture p56: schematic bodge.kicad_sch]

Parts:
C1, C2, C3, C4: 1uF; C_0402_1005Metric_Pad0.74x0.62mm_HandSolder; Tolerance 10; Voltage 25; Part Number GRM155R61C105MA12D
U1: SN74AVC8T245PWR; TSSOP-24_4.4x7.8mm_P0.65mm; Part Number SN74AVC8T245PWR
U2, U3: SN74AVC4T245PW; TSSOP-16_4.4x5mm_P0.65mm; Part Number SN74AVC4T245PW
U8: TXB0108PWR; TSSOP-20_4.4x6.5mm_P0.65mm_Flipped; Part Number TXB0108PWR; not fitted
U9: TXB0106PWR; TSSOP-16_4.4x5mm_P0.65mm_Flipped; Part Number TXB0106PWR; not fitted

Connections:
/1V8: C2.1, C4.1, U1.1 (V_{CCA}), U1.2 (DIR), U2.1 (VCCA), U3.1 (VCCA), U8.2 (VCCA), U9.2 (VCCA)
/3V3: C1.1, C3.1, U1.23 (V_{CCB}), U1.24 (V_{CCB}), U2.2 (1DIR), U2.3 (2DIR), U2.16 (VCCB), U3.16 (VCCB), U8.19 (VCCB), U9.15 (VCCB)
/GND: C1.2, C2.2, C3.2, C4.2, U1.11 (GND), U1.12 (GND), U1.13 (GND), U1.22 (~OE), U2.8 (GND), U2.9 (GND), U2.14 (2~OE), U2.15 (1~OE), U3.2 (1DIR), U3.3 (2DIR), U3.8 (GND), U3.9 (GND), U3.14 (2~OE), U3.15 (1~OE), U8.11 (GND), U9.9 (GND)
unnamed: U1.3 (A1), U8.1 (A1)
unnamed: U1.4 (A2), U8.3 (A2)
unnamed: U1.5 (A3), U8.4 (A3)
unnamed: U1.6 (A4), U8.5 (A4)
unnamed: U1.7 (A5), U8.6 (A5)
unnamed: U1.8 (A6), U8.7 (A6)
unnamed: U1.9 (A7), U8.8 (A7)
unnamed: U1.10 (A8), U8.9 (A8)
unnamed: U1.21 (B1), U8.20 (B1)
unnamed: U1.20 (B2), U8.18 (B2)
unnamed: U1.19 (B3), U8.17 (B3)
unnamed: U1.18 (B4), U8.16 (B4)
unnamed: U1.17 (B5), U8.15 (B5)
unnamed: U1.16 (B6), U8.14 (B6)
unnamed: U1.15 (B7), U8.13 (B7)
unnamed: U1.14 (B8), U8.12 (B8)
unnamed: U2.4 (1A1), U9.3 (A2)
unnamed: U2.5 (1A2), U9.6 (A5)
unnamed: U2.13 (1B1), U9.14 (B2)
unnamed: U2.12 (1B2), U9.11 (B5)
unnamed: U2.6 (2A1), U9.7 (A6)
unnamed: U2.11 (2B1), U9.10 (B6)
unnamed: U3.4 (1A1), U9.1 (A1)
unnamed: U3.5 (1A2), U9.4 (A3)
unnamed: U3.13 (1B1), U9.16 (B1)
unnamed: U3.12 (1B2), U9.13 (B3)
unnamed: U3.6 (2A1), U9.5 (A4)
unnamed: U3.11 (2B1), U9.12 (B4)

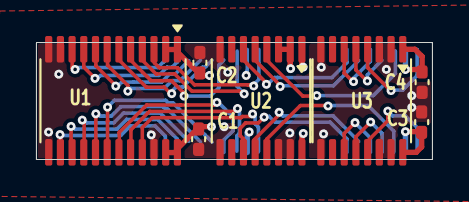
[picture p57: board bodge.kicad_pcb from above]

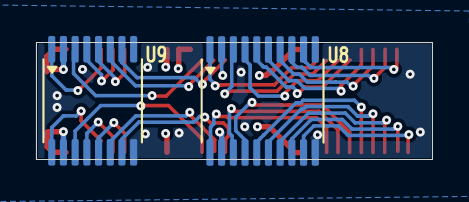
[picture p58: board bodge.kicad_pcb from below]

Board: 4 copper layers, 22.0 x 6.5 mm, 9 parts (2 on the bottom side), 31 nets.
