MatthiasGeorgImhof/Hardware_CSAT/comm_board/comm_board.kicad_pcb

## KiCad design comm_board/comm_board.kicad_pcb (2026-06-08)

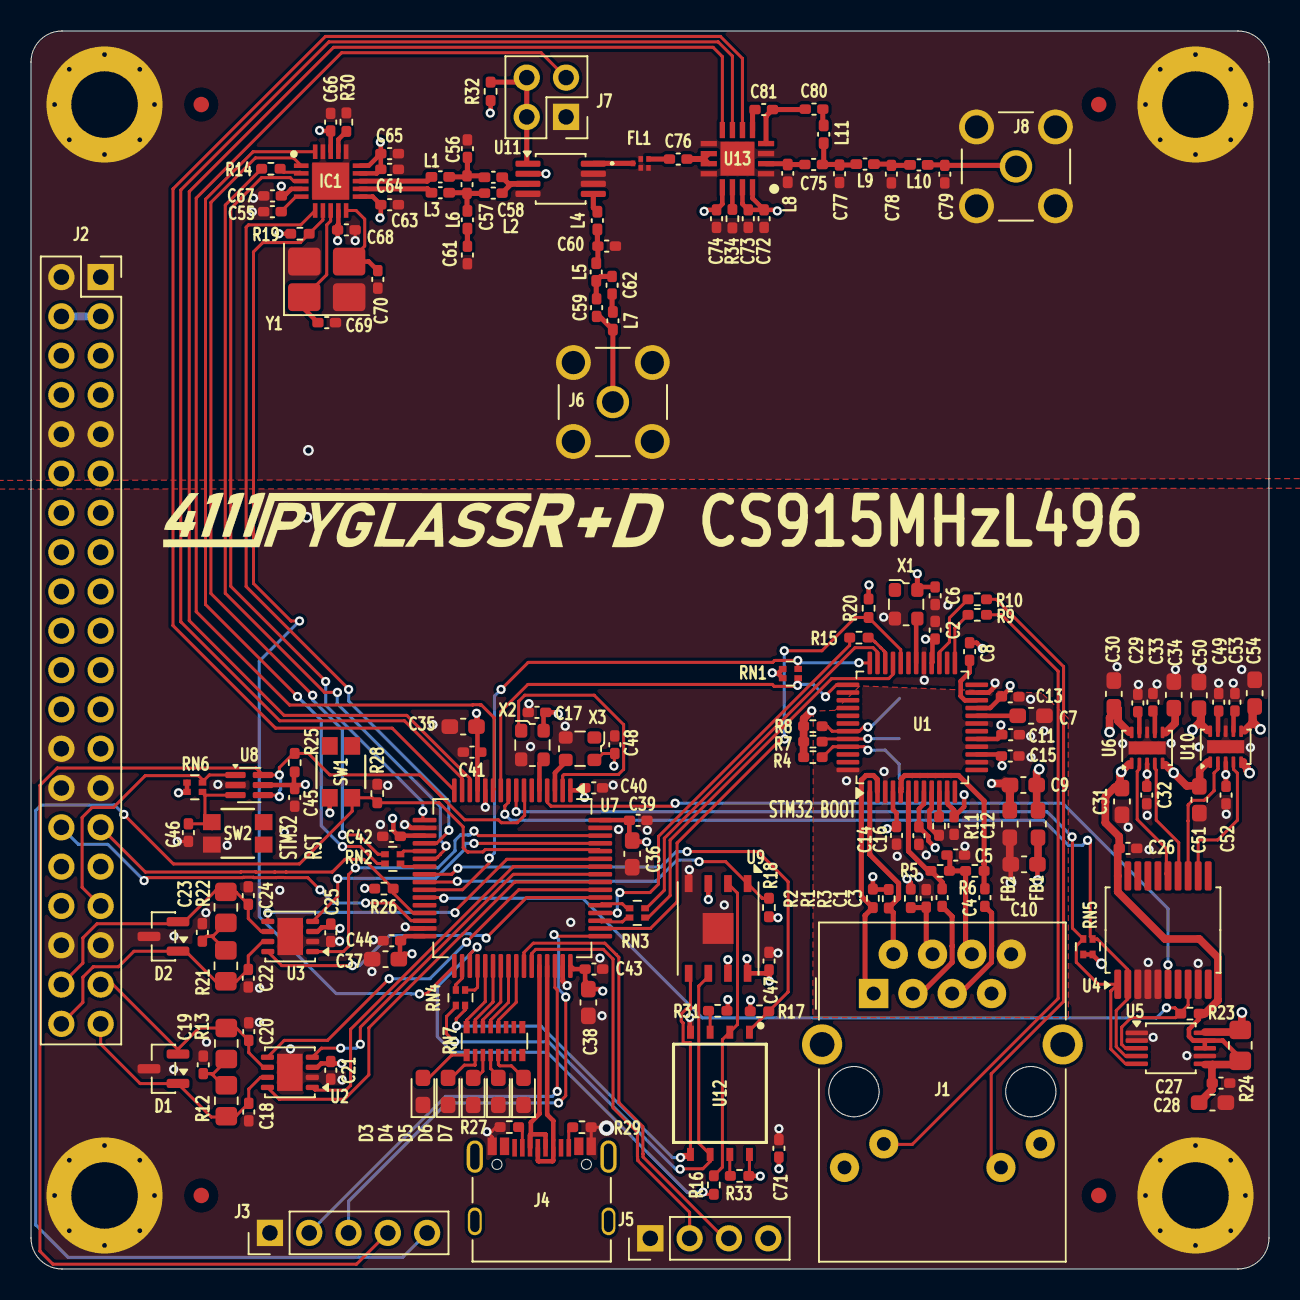
[picture p59: board comm_board.kicad_pcb from above]

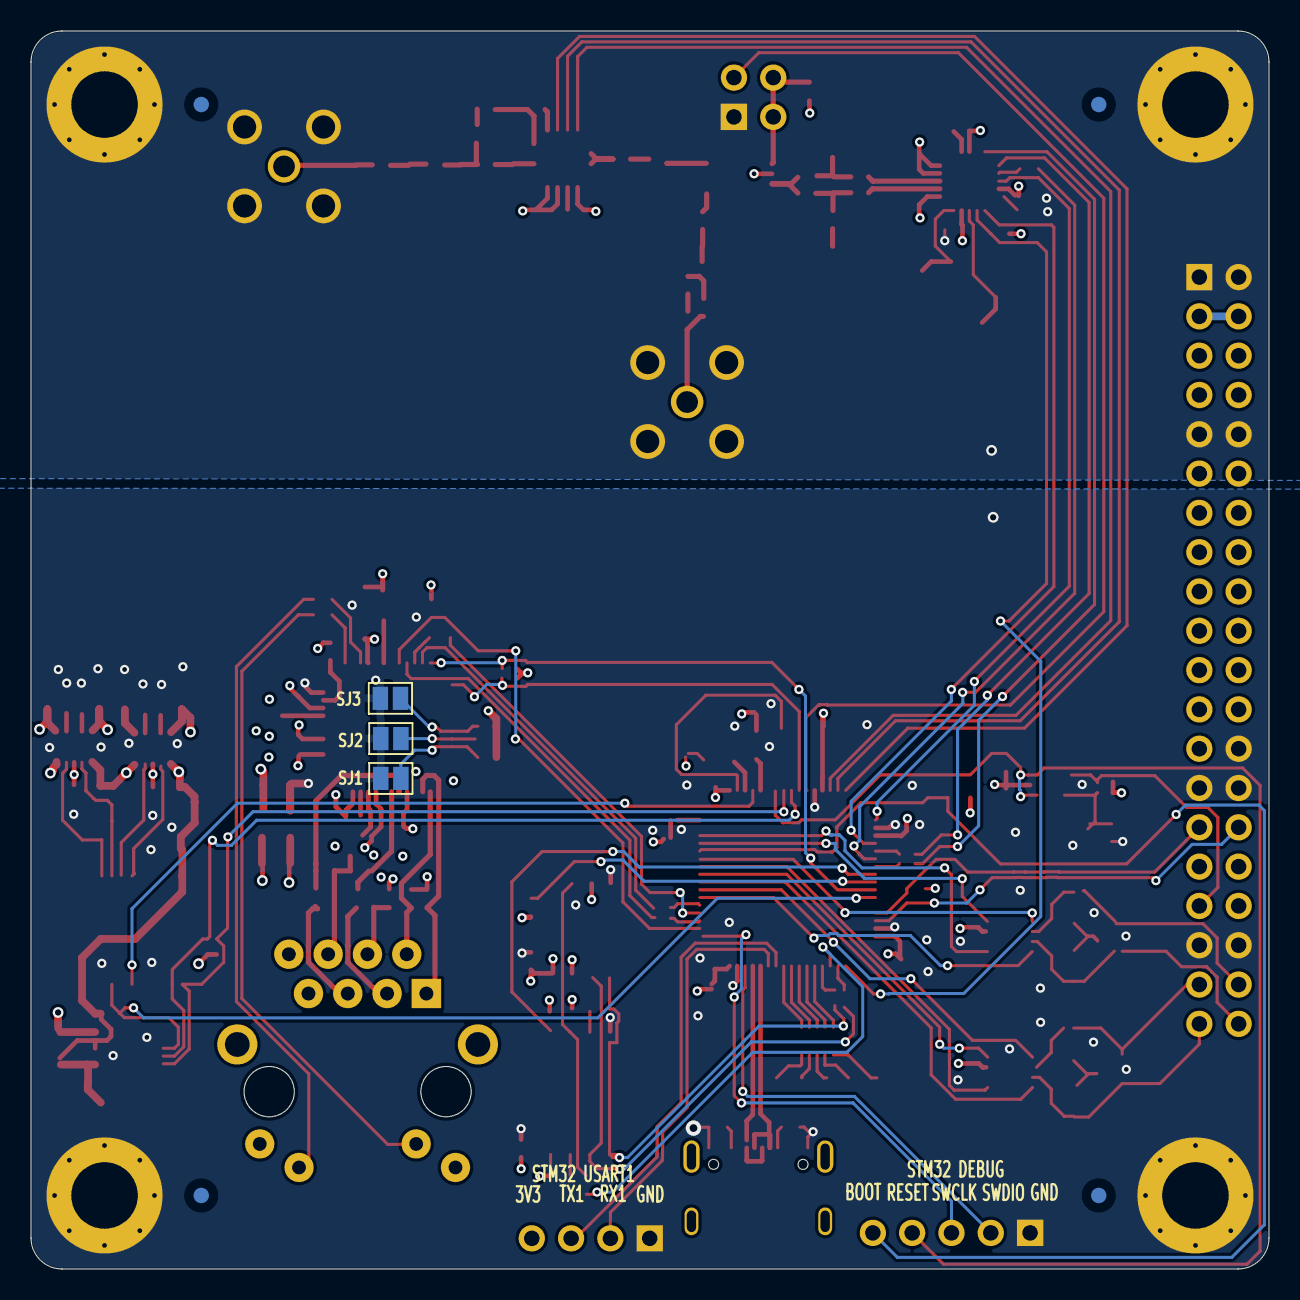
[picture p60: board comm_board.kicad_pcb from below]

Board: 4 copper layers, 80.0 x 80.0 mm, 186 parts (7 on the bottom side), 143 nets.

Parts:
C1, C5: 10nF; C_0402_1005Metric_Pad0.74x0.62mm_HandSolder
C2, C6, C8, C11, C12, C13, C14, C15, C16, C17, C21, C25, C26, C27, C32, C39, C40, C41, C42, C43, C44, C45, C46, C47, C48, C52, C71: 100nF; C_0402_1005Metric_Pad0.74x0.62mm_HandSolder
C3, C4: 6.8nF; C_0402_1005Metric_Pad0.74x0.62mm_HandSolder
C7, C9, C10, C28, C30, C34, C35, C36, C37, C38, C50, C54: 10uF; C_0603_1608Metric_Pad1.08x0.95mm_HandSolder
C18, C20, C22, C24: 100pF; C_0402_1005Metric_Pad0.74x0.62mm_HandSolder
C19, C23: 4nF7; C_0402_1005Metric_Pad0.74x0.62mm_HandSolder
C29, C33, C49, C53: 220pF; C_0402_1005Metric_Pad0.74x0.62mm_HandSolder
C31, C51: 22uF; C_0603_1608Metric_Pad1.08x0.95mm_HandSolder
C55, C61, C63, C64, C65, C66, C67, C68, C72, C73, C74: 100n; C_0402_1005Metric_Pad0.74x0.62mm_HandSolder
C56, C58, C59, C62: 1p5; C_0402_1005Metric_Pad0.74x0.62mm_HandSolder
C57: 1p; C_0402_1005Metric_Pad0.74x0.62mm_HandSolder
C60, C77: 3p3; C_0402_1005Metric_Pad0.74x0.62mm_HandSolder
C69, C70: 27p; C_0402_1005Metric_Pad0.74x0.62mm_HandSolder
C75, C76: 47p; C_0402_1005Metric_Pad0.74x0.62mm_HandSolder
C78: 8p2; C_0402_1005Metric_Pad0.74x0.62mm_HandSolder
C79: 0p5; C_0402_1005Metric_Pad0.74x0.62mm_HandSolder
C80, C81: 12p; C_0402_1005Metric_Pad0.74x0.62mm_HandSolder
D1, D2: NUP2105LT1G; SOT-23
D3: RED; LED_0603_1608Metric_Pad1.05x0.95mm_HandSolder
D4: GREEN; LED_0603_1608Metric_Pad1.05x0.95mm_HandSolder
D5, D6, D7: YELLOW; LED_0603_1608Metric_Pad1.05x0.95mm_HandSolder
FB1, FB2: 1K; L_0603_1608Metric_Pad1.05x0.95mm_HandSolder
FID1, FID2, FID3, FID4, FID5, FID6, FID7, FID8: Fiducial; Fiducial_1mm_Mask2mm
FL1: B39921B2672P810
H1, H2, H3, H4: MountingHole_Pad; MountingHole_4.3mm_M4_Pad_Via_Custom
IC1: CC1101RGPR; QFN50P400X400X100-21N-D
J1: RJ45_Amphenol_RJMG1BD3B8K1ANR
J2: PC104 Conn_02x20_Odd_Even; PinSocket_2x20_P2.54mm_Vertical
J3: Conn_01x05_Pin Vertical; PinHeader_1x05_P2.54mm_Vertical
J4: 10155435-00011LF; AMPHENOL_10155435-00011LF
J5: Conn_01x04_Pin Vertical; PinHeader_1x04_P2.54mm_Vertical
J6, J8: SMA Jack; LINX_CONSMA001-G
J7: Conn_02x03_Odd_Even; PinHeader_2x02_P2.54mm_Vertical
L1, L3, L4, L5, L7: 12n; L_0402_1005Metric_Pad0.77x0.64mm_HandSolder
L2, L6: 18n; L_0402_1005Metric_Pad0.77x0.64mm_HandSolder
L8: 10n; L_0402_1005Metric_Pad0.77x0.64mm_HandSolder
L9: 2n2; L_0402_1005Metric_Pad0.77x0.64mm_HandSolder
L10: 3n9; L_0402_1005Metric_Pad0.77x0.64mm_HandSolder
L11: 7n5; L_0402_1005Metric_Pad0.77x0.64mm_HandSolder
R1, R2, R5, R6: 49R9; R_0402_1005Metric_Pad0.72x0.64mm_HandSolder
R3: 10R; R_0402_1005Metric_Pad0.72x0.64mm_HandSolder
R4, R7, R8: 10K; R_0402_1005Metric_Pad0.72x0.64mm_HandSolder
R9, R10: 470R; R_0402_1005Metric_Pad0.72x0.64mm_HandSolder
R11: 12K4; R_0402_1005Metric_Pad0.72x0.64mm_HandSolder
R12, R13, R21, R22: 60R4; R_0805_2012Metric_Pad1.20x1.40mm_HandSolder
R14, R15, R16: 22R; R_0402_1005Metric_Pad0.72x0.64mm_HandSolder
R17, R18, R19, R20, R23, R25, R28, R31, R32, R33: 100K; R_0402_1005Metric_Pad0.72x0.64mm_HandSolder
R24: 10m; R_0805_2012Metric_Pad1.20x1.40mm_HandSolder
R26: 330K; R_0402_1005Metric_Pad0.72x0.64mm_HandSolder
R27, R29: 5K1; R_0402_1005Metric_Pad0.72x0.64mm_HandSolder
R30: 56K; R_0402_1005Metric_Pad0.72x0.64mm_HandSolder
R34: 3K3; R_0402_1005Metric_Pad0.72x0.64mm_HandSolder
RN1: 10K; R_Array_Convex_2x0402_widepads
RN2, RN3, RN4: 22R; R_Array_Convex_2x0402_widepads
RN5: 5K6; R_Array_Convex_2x0402_widepads
RN6: 100K; R_Array_Convex_2x0402_widepads
RN7: 1K; R_Array_Convex_8x0602_widepads
SJ1, SJ2, SJ3: SOLDERJUMPERREFLOW_NOPASTE; SolderJumper-2_P1.3mm_Open_Pad1.0x1.5mm
SW1, SW2: EVP-AA602W; EVP602AA
U1: W5500; LQFP-48_7x7mm_P0.5mm
U2, U3: TCAN3414; VSON-8-1EP_3x3mm_P0.65mm_EP1.65x2.4mm
U4: MCP23008T-E/SS; SSOP-20_5.3x7.2mm_P0.65mm
U5: INA226AIDGSR; VSSOP-10_3x3mm_P0.5mm
U6, U10: TPS22968QDMGRQ1; WSON-10-1EP_2x3mm_P0.5mm_EP0.84x2.4mm
U7: STM32L496RGTx; LQFP-64_10x10mm_P0.5mm
U8: 74LVC2G07; SOT-363_SC-70-6
U9: MR25H10; DFN-8-1EP_6x5mm_P1.27mm_EP2x2mm
U11: PE4250MLI; MSOP-8_3x3mm_P0.65mm
U12: MT29F4G01ABAFDWB-IT:F TR; SON127P800X600X65-8N
U13: CC1190RGVR; QFN65P400X400X100-17N-D
X1: 25MHz; Oscillator_SMD_ECS_2520MV-xxx-xx-4Pin_2.5x2.0mm
X2: 10MHz; Oscillator_SMD_ECS_2520MV-xxx-xx-4Pin_2.5x2.0mm
X3: 32.768KHZ; Oscillator_SMD_ECS_2520MV-xxx-xx-4Pin_2.5x2.0mm
Y1: 26MHz; Crystal_SMD_3225-4Pin_3.2x2.5mm_HandSoldering

Connections:
/3V3_AUX: J2.15, R24.1, U5.10 (IN+)
/3V3_BRIDGE: C17.1, C21.1, C25.1, C35.1, C36.1, C37.1, C38.1, C39.1, C40.1, C41.1, C42.1, C43.1, C44.1, C45.2, C48.1, J2.13, J5.4, R25.1, R26.1, RN5.3 (R2.2), RN5.4 (R1.2), RN6.1 (R1.1), RN6.2 (R2.1), SW1.1, U2.3 (VCC), U3.3 (VCC), U7.1 (VBAT), U7.13 (VDDA), U7.19 (VDD), U7.32 (VDD), U7.48 (VDDUSB), U7.64 (VDD), U8.5 (VCC), X2.4 (VDD), X3.4 (VCC)
/3V3_COMM: C54.2, C63.1, C64.1, C65.1, C66.1, C67.1, C68.1, IC1.4 (DVDD), IC1.9 (AVDD_1), IC1.11 (AVDD_2), IC1.14 (AVDD_3), IC1.15 (AVDD_4), IC1.18 (DGUARD), R19.1, R32.1, U10.6 (VOUT2), U11.2 (V1)
/3V3_LAN: C2.1, C6.1, C9.1, C30.1, FB1.1, J1.L1, J1.L4, R4.1, R7.1, R8.1, R20.1, RN1.3 (R2.2), RN1.4 (R1.2), U1.28 (VDD), U6.10 (VOUT1), X1.4 (VCC)
/CAN Bridge/3V3_MRAM: C47.1, C50.1, C71.1, R17.1, R18.1, R31.1, R33.1, U9.3 (~WP), U9.7 (~HOLD), U9.8 (VDD), U10.10 (VOUT1), U12.8 (VCC)
/CAN Bridge/CAN1_H: C22.1, D2.1 (K), J2.40, R21.1, U3.7 (CANH)
/CAN Bridge/CAN1_L: C24.2, D2.2 (K), J2.38, R22.2, U3.6 (CANL)
/CAN Bridge/CAN2_H: C18.1, D1.1 (K), J2.39, R12.1, U2.7 (CANH)
/CAN Bridge/CAN2_L: C20.2, D1.2 (K), J2.37, R13.2, U2.6 (CANL)
/CAN Bridge/COMM1_RST: J2.33, RN6.4 (R1.2), U8.1 (IN1)
/CAN Bridge/Flash/SPI_CLK: RN4.1 (R1.1), U9.6 (SCK), U12.6 (SCK)
/CAN Bridge/Flash/SPI_MISO: R16.1, U9.2 (SO), U12.2 (SO/IO1)
/CAN Bridge/Flash/SPI_MOSI: RN4.2 (R2.1), U9.5 (SI), U12.5 (SI/IO0)
/CAN Bridge/I2C2_SCL: RN5.2 (R2.1), U4.1 (SCL), U5.5 (SCL), U7.8 (PC0)
/CAN Bridge/I2C2_SDA: RN5.1 (R1.1), U4.2 (SDA), U5.4 (SDA), U7.9 (PC1)
/CAN Bridge/PMIC/BOOT: J3.5, R28.1, SW1.2, U7.60 (PH3_BOOT0)
/CAN Bridge/PMIC/CAN1_RX: U3.4 (RXD), U7.61 (PB8)
/CAN Bridge/PMIC/CAN1_SHDN: U3.5 (SHTD), U7.59 (PB7)
/CAN Bridge/PMIC/CAN1_STB: U3.8 (STB), U7.54 (PD2)
/CAN Bridge/PMIC/CAN1_TX: U3.1 (TXD), U7.62 (PB9)
/CAN Bridge/PMIC/CAN2_RX: U2.4 (RXD), U7.57 (PB5)
/CAN Bridge/PMIC/CAN2_SHDN: U2.5 (SHTD), U7.55 (PB3)
/CAN Bridge/PMIC/CAN2_STB: U2.8 (STB), U7.56 (PB4)
/CAN Bridge/PMIC/CAN2_TX: U2.1 (TXD), U7.58 (PB6)
/CAN Bridge/PMIC/EXTI0: RN1.2 (R2.1), U1.36 (~INT), U7.26 (PB0)
/CAN Bridge/PMIC/EXTI3: IC1.3 (GDO2), U7.17 (PA3)
/CAN Bridge/PMIC/EXTI4: IC1.6 (GDO0_(ATEST)), U7.20 (PA4)
/CAN Bridge/PMIC/EXTI10: J2.29, R26.2, U7.29 (PB10)
/CAN Bridge/PMIC/EXTI11: J2.30, U7.30 (PB11)
/CAN Bridge/PMIC/FS_DN: J4.A7 (DN1_A), J4.B7 (DN2_B), U7.44 (PA11)
/CAN Bridge/PMIC/FS_DP: J4.A6 (DP1_A), J4.B6 (DP2_B), U7.45 (PA12)
/CAN Bridge/PMIC/HSE_EN: U7.2 (PC13), X2.1 (TRI-STATE)
/CAN Bridge/PMIC/HSE_IN: U7.5 (PH0), X2.3 (OUTPUT)
/CAN Bridge/PMIC/LED1: RN7.16 (R), U7.37 (PC6)
/CAN Bridge/PMIC/LED2: RN7.15 (R), U7.38 (PC7)
/CAN Bridge/PMIC/LED3: RN7.14 (R), U7.39 (PC8)
/CAN Bridge/PMIC/LED4: RN7.13 (R), U7.40 (PC9)
/CAN Bridge/PMIC/LED5: RN7.12 (R), U7.41 (PA8)
/CAN Bridge/PMIC/NRST: J3.4, R25.2, U7.7 (NRST), U8.4 (OUT2), U8.6 (OUT1)
/CAN Bridge/PMIC/OSC32_IN: U7.3 (PC14), X3.3 (OUT)
/CAN Bridge/PMIC/PA0: U7.14 (PA0), U13.8 (PA_EN)
/CAN Bridge/PMIC/PA1: U7.15 (PA1), U13.7 (LNA_EN)
/CAN Bridge/PMIC/PA2: U7.16 (PA2), U13.6 (HGM)
/CAN Bridge/PMIC/PC2: RN1.1 (R1.1), U1.37 (~RST), U7.10 (PC2)
/CAN Bridge/PMIC/PC3: J7.3, U7.11 (PC3)
/CAN Bridge/PMIC/RESET: C46.1, RN6.3 (R2.2), SW2.3, U8.3 (IN2)
/CAN Bridge/PMIC/SPI1_MISO: R14.2, U7.22 (PA6)
/CAN Bridge/PMIC/SPI1_MOSI: RN2.3 (R2.2), U7.23 (PA7)
/CAN Bridge/PMIC/SPI1_SCK: RN2.4 (R1.2), U7.21 (PA5)
/CAN Bridge/PMIC/SPI2_MISO: R16.2, U7.35 (PB14)
/CAN Bridge/PMIC/SPI2_MOSI: RN4.3 (R2.2), U7.36 (PB15)
/CAN Bridge/PMIC/SPI2_SCK: RN4.4 (R1.2), U7.34 (PB13)
/CAN Bridge/PMIC/SPI3_MISO: R15.1, U7.52 (PC11)
/CAN Bridge/PMIC/SPI3_MOSI: RN3.3 (R2.2), U7.53 (PC12)
/CAN Bridge/PMIC/SPI3_SCK: RN3.4 (R1.2), U7.51 (PC10)
/CAN Bridge/PMIC/SYS_JTMS_SWCLK: J3.3, U7.49 (PA14)
/CAN Bridge/PMIC/SYS_JTMS_SWDIO: J3.2, U7.46 (PA13)
/CAN Bridge/PMIC/USART1_RX: J5.2, U7.43 (PA10)
/CAN Bridge/PMIC/USART1_TX: J5.3, U7.42 (PA9)
/CAN Bridge/Power Switch/ENABLE0: U4.12 (GP0), U10.4 (ON2)
/CAN Bridge/Power Switch/ENABLE1: U4.13 (GP1), U10.2 (ON1)
/CAN Bridge/Power Switch/ENABLE2: U4.14 (GP2), U6.4 (ON2)
/CAN Bridge/Power Switch/ENABLE3: U4.15 (GP3), U6.2 (ON1)
/CAN Bridge/Power Switch/VBUS: C26.1, C27.1, C28.1, C31.1, C32.1, C51.1, C52.1, R23.1, R24.2, U4.20 (VDD), U5.6 (VS), U5.8 (VBUS), U5.9 (IN-), U6.1 (VIN1), U6.3 (VBIAS), U6.5 (VIN2), U10.1 (VIN1), U10.3 (VBIAS), U10.5 (VIN2)
/CAN Bridge/Power Switch/VOUT2: C34.2, U6.6 (VOUT2)
/CAN Bridge/Power_INT: R23.2, U4.8 (INT), U5.3 (ALERT), U7.27 (PB1)
/CAN Bridge/Power_RST: U4.6 (*RESET), U7.4 (PC15)
/CAN Bridge/SPI_FLASH_CS: R17.2, U7.24 (PC4), U12.1 (CS#)
/CAN Bridge/SPI_LAN_CS: R20.2, U1.32 (~SCS), U7.50 (PA15)
/CAN Bridge/SPI_LAN_MISO: R15.2, U1.34 (MISO)
/CAN Bridge/SPI_LAN_MOSI: RN3.2 (R2.1), U1.35 (MOSI)
/CAN Bridge/SPI_LAN_SCK: RN3.1 (R1.1), U1.33 (SCLK)
/CAN Bridge/SPI_MRAM_CS: R18.2, U7.25 (PC5), U9.1 (~CS)
/CAN Bridge/SPI_RF_CS: IC1.7 (CSN), R19.2, U7.33 (PB12)
/CAN Bridge/SPI_RF_MISO: IC1.2 (SO_(GDO1)), R14.1
/CAN Bridge/SPI_RF_MOSI: IC1.20 (SI), RN2.2 (R2.1)
/CAN Bridge/SPI_RF_SCK: IC1.1 (SCLK), RN2.1 (R1.1)
/GND: C2.2, C6.2, C9.2, C17.2, C18.2, C19.2, C20.1, C21.2, C22.2, C23.2, C24.1, C25.2, C26.2, C27.2, C28.2, C29.2, C30.2, C31.2, C32.2, C33.1, C34.1, C35.2, C36.2, C37.2, C38.2, C39.2, C40.2, C41.2, C42.2, C43.2, C44.2, C45.1, C46.2, C47.2, C48.2, C49.2, C50.2, C51.2, C52.2, C53.1, C54.1, C55.2, C56.1, C60.2, C61.2, C63.2, C64.2, C65.2, C66.2, C67.2, C68.2, C69.2, C70.2, C71.2, C72.2, C73.2, C74.2, C77.2, C78.2, C79.2, D1.3 (A), D2.3 (A), D3.1 (K), D4.1 (K), D5.1 (K), D6.1 (K), D7.1 (K), FB2.1, FL1.2 (GROUND_1), FL1.3 (GROUND_2), FL1.5 (GROUND_3), H1.1, H2.1, H3.1, H4.1, IC1.16 (GND_1), IC1.19 (GND_2), IC1.21 (GND_3), J2.1, J2.2, J2.9, J2.10, J2.26, J2.27, J2.28, J2.35, J2.36, J3.1, J4.A1_B12 (GND), J4.B1_A12 (GND__1), J5.1, J6.2 (Ext), J7.1, J8.2 (Ext), L8.1, R27.1, R28.2, R29.1, R30.2, R34.2, SJ1.2 (B), SJ2.2 (B), SJ3.2 (B), SW2.4, U1.23 (RSVD), U1.29 (GND), U2.2 (GND), U2.9 (GND), U3.2 (GND), U3.9 (GND), U4.3 (A2), U4.4 (A1), U4.5 (A0), U4.9 (VSS), U5.1 (A1), U5.2 (A0), U5.7 (GND), U6.8 (GND), U6.11 (TPAD), U7.12 (VSSA), U7.18 (VSS), U7.31 (VSS), U7.47 (VSS), U7.63 (VSS), U8.2 (GND), U9.4 (VSS), U9.9 (PAD), U10.8 (GND), U10.11 (TPAD), U11.4 (N/C_OR_GND), U11.6 (GND_1), U11.7 (GND_2), U12.4 (VSS), U13.1 (GND_1), U13.3 (GND_2), U13.9 (GND_3), U13.12 (GND_4), U13.17 (GND_5), X1.2 (GND), X2.2 (GND), X3.2 (GND), Y1.2 (G), Y1.4 (G)
/INTERBOARD_CONNECTOR2/BATT: J2.3, J2.4
/PW_RF_915MHz/RF_INOUT: FL1.1 (INPUT), U11.8 (RF2)
/SPI_LAN/AGND: C1.2, C5.2, C7.2, C8.2, C10.2, C11.2, C12.2, C13.2, C14.2, C15.2, C16.2, FB2.2, J1.R8, R11.2, U1.3 (AGND), U1.9 (AGND), U1.14 (AGND), U1.16 (AGND), U1.19 (AGND), U1.48 (AGND)
/SPI_LAN/AVDD: C10.1, C11.1, C12.1, C13.1, C14.1, C15.1, C16.1, FB1.2, R1.1, R2.1, R3.1, U1.4 (AVDD), U1.8 (AVDD), U1.11 (AVDD), U1.15 (AVDD), U1.17 (AVDD), U1.21 (AVDD)
/SPI_LAN/GREENLED: J1.L3, R9.1
/SPI_LAN/RX+: C3.2, R5.2, U1.6 (RXP)
/SPI_LAN/RX-: C4.2, R6.2, U1.5 (RXN)
/SPI_LAN/TX+: J1.R1 (TD+), R2.2, U1.2 (TXP)
/SPI_LAN/TX-: J1.R2 (TD-), R1.2, U1.1 (TXN)
/SPI_LAN/YELLOWLED: J1.L2, R10.1
/VRF: C72.1, C73.1, C74.1, J2.5, U13.13 (VDD_LNA), U13.15 (VDD_PA2), U13.16 (VDD_PA1)
unnamed: C19.1, R12.2, R13.1
unnamed: C23.1, R21.2, R22.1
unnamed: C56.2, C57.1, L1.2, L2.1
unnamed: C57.2, C58.1, L3.2, L6.1
unnamed: C59.1, C62.1, L5.2
unnamed: C60.1, L4.2, L5.1
unnamed: C61.1, L6.2
unnamed: C62.2, L7.1
unnamed: C75.2, C77.1, L9.1, L11.1
unnamed: C78.1, L9.2, L10.1
unnamed: C80.1, L11.2
unnamed: D3.2 (A), RN7.1 (R)
unnamed: D4.2 (A), RN7.2 (R)
unnamed: D5.2 (A), RN7.3 (R)
unnamed: D6.2 (A), RN7.4 (R)
unnamed: D7.2 (A), RN7.5 (R)
unnamed: C76.1, FL1.4 (OUTPUT)
unnamed: C55.1, IC1.5 (DCOUPL)
unnamed: IC1.17 (RBIAS), R30.1
unnamed: IC1.13 (RF_N), L1.1
unnamed: IC1.12 (RF_P), L3.1
unnamed: C69.1, IC1.8 (XOSC_Q1), Y1.1
unnamed: C70.1, IC1.10 (XOSC_Q2), Y1.3
unnamed: C4.1, J1.R5 (RCT)
unnamed: C3.1, J1.R3 (RD+)
unnamed: C5.1, J1.R6 (RD-), R5.1, R6.1
unnamed: C1.1, J1.R4 (TCT), R3.2
unnamed: J4.A5 (CC1_A), R27.2
unnamed: J4.B5 (CC2_B), R29.2
unnamed: C59.2, J6.1 (In), L7.2
unnamed: J7.2, J7.4, R32.2, U11.1 (V2/DIR)
unnamed: C79.1, J8.1 (In), L10.2
unnamed: R4.2, SJ1.1 (A), U1.45 (PMODE0)
unnamed: R7.2, SJ2.1 (A), U1.44 (PMODE1)
unnamed: R8.2, SJ3.1 (A), U1.43 (PMODE2)
unnamed: C8.1, U1.22 (1V2O)
unnamed: R10.2, U1.27 (ACTLED)
unnamed: R11.1, U1.10 (EXRES1)
unnamed: R9.2, U1.25 (LINKLED)
unnamed: C7.1, U1.20 (TOCAP)
unnamed: U1.30 (XI/CLKIN), X1.3 (OUT)
unnamed: C29.1, U6.9 (CT1)
unnamed: C33.2, U6.7 (CT2)
unnamed: C49.1, U10.9 (CT1)
unnamed: C53.2, U10.7 (CT2)
unnamed: L4.1, U11.5 (RF1)
unnamed: C58.2, L2.2, U11.3 (RFC)
unnamed: R33.2, U12.7 (HOLD#/IO3)
unnamed: R31.2, U12.3 (WP#/IO2)
unnamed: R34.1, U13.14 (BIAS)
unnamed: C81.1, U13.5 (LNA_IN)
unnamed: C76.2, U13.10 (LNA_OUT), U13.11 (PA_IN)
unnamed: C75.1, L8.2, U13.2 (PA_OUT)
unnamed: C80.2, C81.2, U13.4 (TR_SW)
