MatthiasGeorgImhof/Hardware_CSAT/sci_board_wo_switches/sci_board_wo_switches.kicad_pcb

## KiCad design sci_board_wo_switches/sci_board_wo_switches.kicad_pcb (2026-06-08)

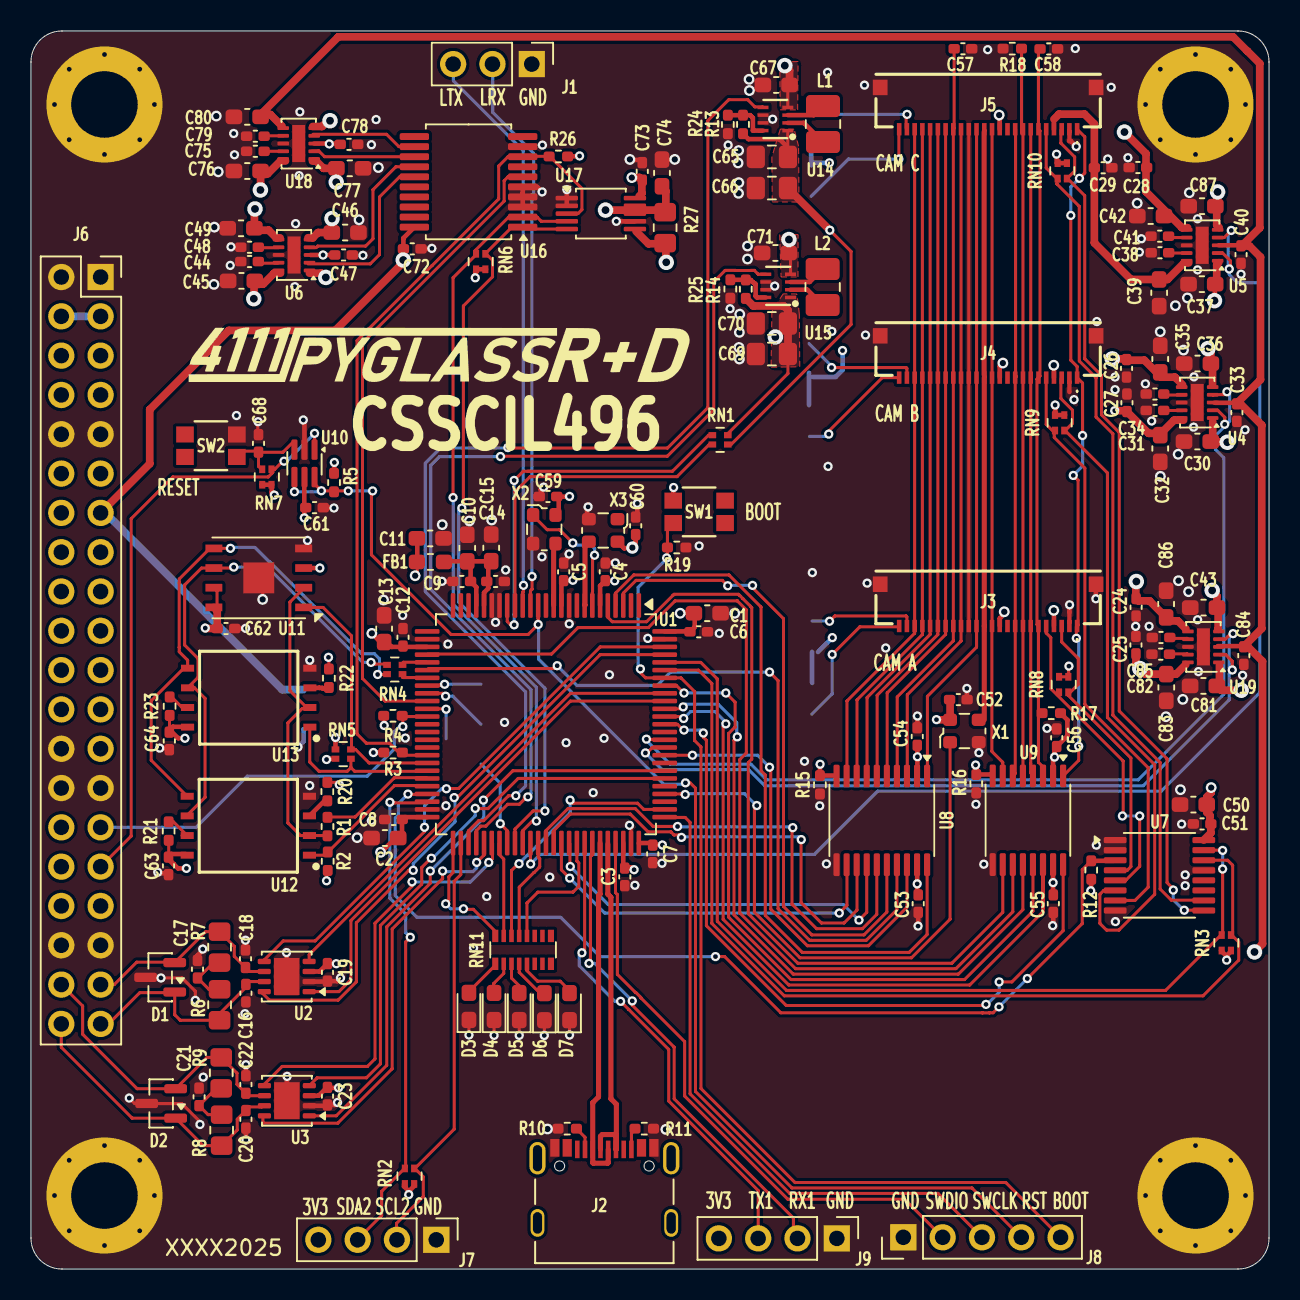
[picture p61: board sci_board_wo_switches.kicad_pcb from above]

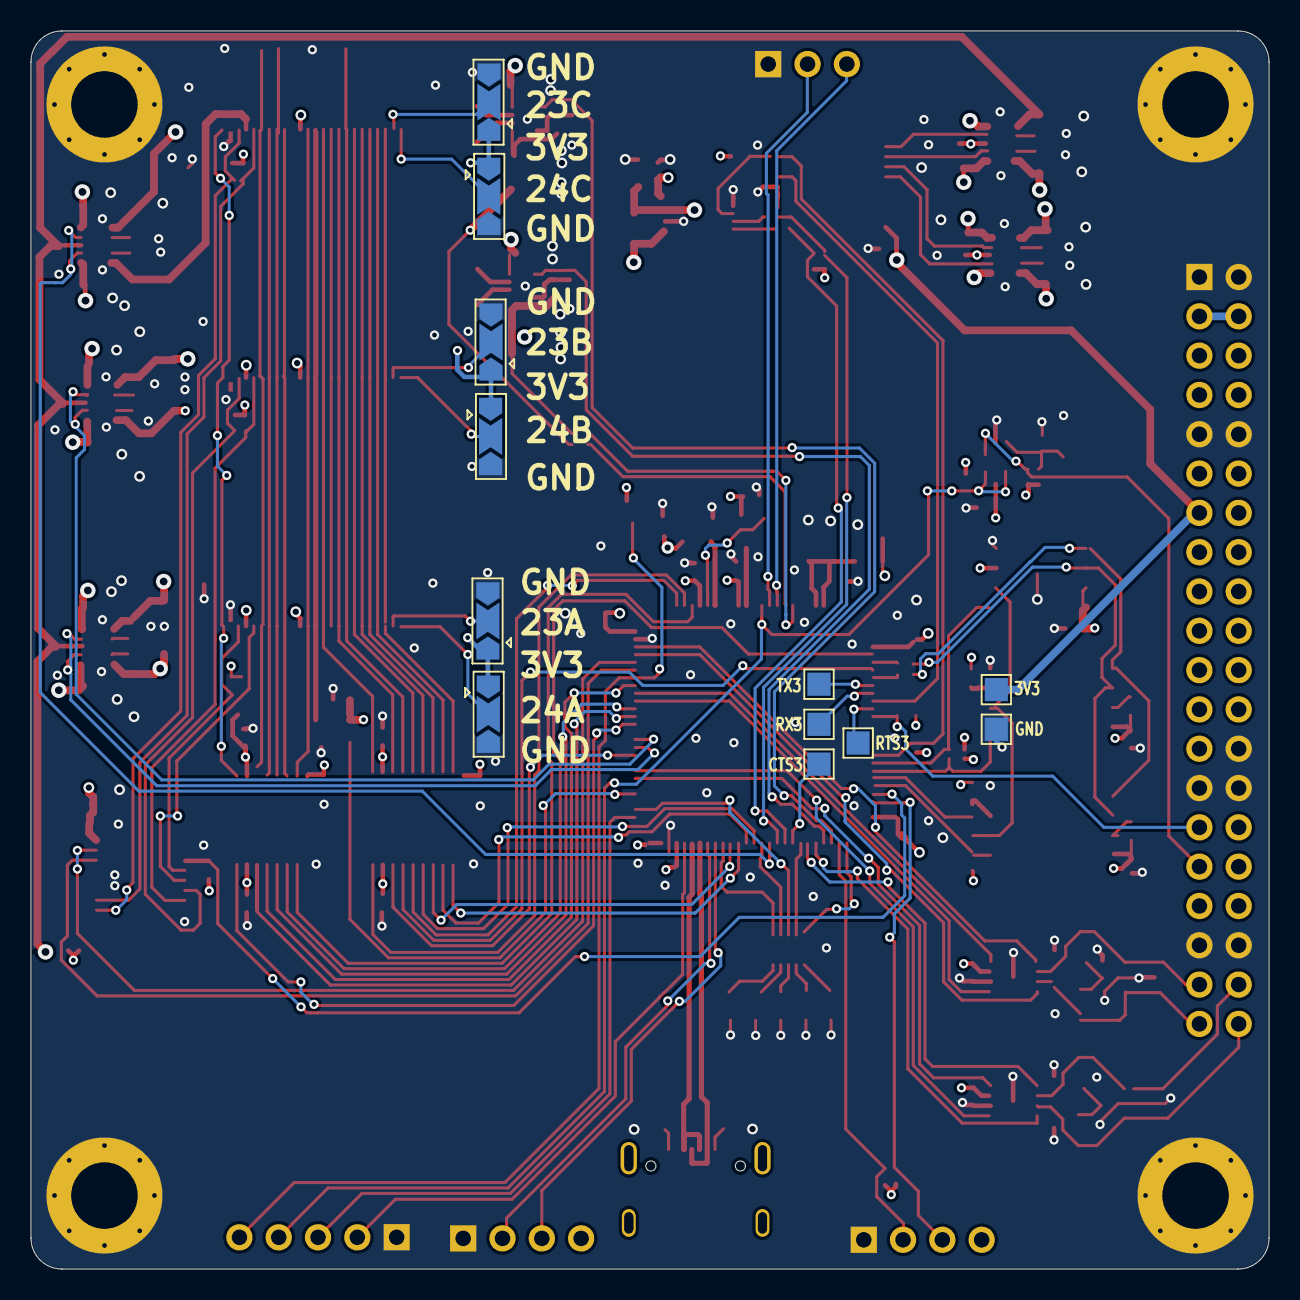
[picture p62: board sci_board_wo_switches.kicad_pcb from below]

Board: 4 copper layers, 80.0 x 80.0 mm, 187 parts (12 on the bottom side), 159 nets.

Parts:
C1, C2, C10, C11, C13, C15, C32, C35, C39, C42, C45, C49, C50, C74, C76, C80, C83, C86: 10uF; C_0603_1608Metric_Pad1.08x0.95mm_HandSolder
C3, C4, C5, C6, C7, C8, C9, C12, C14, C19, C23, C24, C25, C26, C27, C28, C29, C33, C40, C47, C51, C52, C53, C54, C55, C56, C58, C59, C60, C61, C62, C63, C64, C68, C72, C73, C78, C84: 100nF; C_0402_1005Metric_Pad0.74x0.62mm_HandSolder
C16, C18, C20, C22: 100pF; C_0402_1005Metric_Pad0.74x0.62mm_HandSolder
C17, C21: 4nF7; C_0402_1005Metric_Pad0.74x0.62mm_HandSolder
C30, C36, C37, C43, C46, C67, C71, C77, C81, C87: 22uF; C_0603_1608Metric_Pad1.08x0.95mm_HandSolder
C31, C34, C38, C41, C44, C48, C75, C79, C82, C85: 220pF; C_0402_1005Metric_Pad0.74x0.62mm_HandSolder
C57: 22pF; C_0402_1005Metric_Pad0.74x0.62mm_HandSolder
C65, C66, C69, C70: 47uF; C_0805_2012Metric_Pad1.18x1.45mm_HandSolder
D1, D2: NUP2105LT1G; SOT-23
D3: RED; LED_0603_1608Metric_Pad1.05x0.95mm_HandSolder
D4: GREEN; LED_0603_1608Metric_Pad1.05x0.95mm_HandSolder
D5, D6, D7: YELLOW; LED_0603_1608Metric_Pad1.05x0.95mm_HandSolder
FB1: 120R; L_0603_1608Metric_Pad1.05x0.95mm_HandSolder
H1, H2, H3, H4: MountingHole_Pad; MountingHole_4.3mm_M4_Pad_Via_Custom
J1: Conn_01x03_Pin Vertical; PinHeader_1x03_P2.54mm_Vertical
J2: 10155435-00011LF; AMPHENOL_10155435-00011LF
J3, J4, J5: 10051922-2410EHLF; 100519222410EHLF
J6: PC104 Conn_02x20_Odd_Even; PinSocket_2x20_P2.54mm_Vertical
J7, J9: Conn_01x04_Pin Vertical; PinHeader_1x04_P2.54mm_Vertical
J8: Conn_01x05_Pin Vertical; PinHeader_1x05_P2.54mm_Vertical
JP1, JP2, JP3, JP4, JP5, JP6: SolderJumper_3_Open; SolderJumper-3_P2.0mm_Open_TrianglePad1.0x1.5mm
L1, L2: 1uH; L_1008_2520Metric_Pad1.43x2.20mm_HandSolder
NT1, NT2, NT3: NetTie_2; NetTie-2_SMD_Pad0.3mm
R1: 22R; R_0402_1005Metric_Pad0.72x0.64mm_HandSolder
R2, R3, R5, R12, R15, R16, R17, R18, R19, R20, R21, R22, R23, R26: 100K; R_0402_1005Metric_Pad0.72x0.64mm_HandSolder
R4: 330K; R_0402_1005Metric_Pad0.72x0.64mm_HandSolder
R6, R7, R8, R9: 60R4; R_0805_2012Metric_Pad1.20x1.40mm_HandSolder
R10, R11: 5K1; R_0402_1005Metric_Pad0.72x0.64mm_HandSolder
R13: 422K; R_0402_1005Metric_Pad0.72x0.64mm_HandSolder
R14: 237K; R_0402_1005Metric_Pad0.72x0.64mm_HandSolder
R24, R25: 91K; R_0402_1005Metric_Pad0.72x0.64mm_HandSolder
R27: 10m; R_0805_2012Metric_Pad1.20x1.40mm_HandSolder
RN1: 10K; R_Array_Convex_2x0402_widepads
RN2, RN3, RN6, RN8, RN9, RN10: 5K6; R_Array_Convex_2x0402_widepads
RN4: 22R; R_Array_Convex_2x0402_widepads
RN5, RN7: 100K; R_Array_Convex_2x0402_widepads
RN11: 1K; R_Array_Convex_8x0602_widepads
SW1, SW2: EVP-AA602W; EVP602AA
TP1: TX3; TestPoint_Pad_1.5x1.5mm
TP2: RX3; TestPoint_Pad_1.5x1.5mm
TP3: RTS3; TestPoint_Pad_1.5x1.5mm
TP4: CTS3; TestPoint_Pad_1.5x1.5mm
TP5: 3V3AUX; TestPoint_Pad_1.5x1.5mm
TP6: GND; TestPoint_Pad_1.5x1.5mm
U1: STM32L496VGTx; LQFP-100_14x14mm_P0.5mm
U2, U3: TCAN3414; VSON-8-1EP_3x3mm_P0.65mm_EP1.65x2.4mm
U4, U5, U6, U18, U19: TPS22968QDMGRQ1; WSON-10-1EP_2x3mm_P0.5mm_EP0.84x2.4mm
U7: TCA9546APWR; TSSOP-16_4.4x5mm_P0.65mm
U8: TXB0108PWR; TSSOP-20_4.4x6.5mm_P0.65mm
U9: TXB0106PWR; TSSOP-16_4.4x5mm_P0.65mm
U10: 74LVC2G07; SOT-363_SC-70-6
U11: MR25H10; DFN-8-1EP_6x5mm_P1.27mm_EP2x2mm
U12, U13: MT29F4G01ABAFDWB-IT:F TR; SON127P800X600X65-8N
U14, U15: TPS631000DRLR; TPS631000DRLR_TEX
U16: MCP23008T-E/SS; SSOP-20_5.3x7.2mm_P0.65mm
U17: INA226AIDGSR; VSSOP-10_3x3mm_P0.5mm
X1: 24MHz; Oscillator_SMD_ECS_2520MV-xxx-xx-4Pin_2.5x2.0mm
X2: 10MHz; Oscillator_SMD_ECS_2520MV-xxx-xx-4Pin_2.5x2.0mm
X3: 32.768KHZ; Oscillator_SMD_ECS_2520MV-xxx-xx-4Pin_2.5x2.0mm

Connections:
+3V3_AUX: C72.1, C73.1, J6.13, R26.1, R27.1, RN6.3 (R2.2), RN6.4 (R1.2), TP5.1, U16.20 (VDD), U17.6 (VS), U17.10 (IN+)
+3V3_STM32_Core: C1.2, C2.2, C3.1, C4.1, C5.1, C6.1, C7.1, C8.1, C11.1, C12.2, C13.2, C19.1, C23.1, C59.1, C60.1, C61.2, FB1.1, J6.14, J9.4, R3.1, R4.1, R5.1, RN7.1 (R1.1), RN7.2 (R2.1), SW1.1, U1.6 (VBAT), U1.11 (VDD), U1.28 (VDD), U1.50 (VDD), U1.73 (VDDUSB), U1.75 (VDD), U1.100 (VDD), U2.3 (VCC), U3.3 (VCC), U10.5 (VCC), X2.4 (VDD), X3.4 (VCC)
+BATT: C67.1, C71.1, J6.8, U14.4 (VIN), U15.4 (VIN)
/1V8: C36.1, C43.1, C50.1, C51.1, C52.1, C54.1, C56.1, C69.1, C70.1, C87.1, R12.1, R14.1, R15.1, R16.1, R17.1, RN1.2 (R2.1), U4.5 (VIN2), U5.5 (VIN2), U7.16 (VCC), U8.2 (VCCA), U8.10 (OE), U9.2 (VCCA), U9.8 (OE), U15.1 (VOUT), U19.5 (VIN2), X1.4 (VDD)
/2V8: C30.1, C37.1, C65.1, C66.1, C81.1, R13.1, RN1.1 (R1.1), U4.1 (VIN1), U5.1 (VIN1), U14.1 (VOUT), U19.1 (VIN1)
/3V3_Cameras: C33.1, C40.1, C53.1, C55.1, C80.2, C84.1, RN3.3 (R2.2), RN3.4 (R1.2), U4.3 (VBIAS), U5.3 (VBIAS), U8.19 (VCCB), U9.15 (VCCB), U18.6 (VOUT2), U19.3 (VBIAS)
/3V3_Flash: C49.2, C63.1, C64.1, R2.1, R20.1, R21.1, R22.1, R23.1, RN5.2 (R2.1), U6.6 (VOUT2), U12.8 (VCC), U13.8 (VCC)
/3V3_Imager: C76.1, J7.4, RN2.3 (R2.2), RN2.4 (R1.2), U18.10 (VOUT1)
/3V3_MRAM: C45.1, C62.1, RN5.1 (R1.1), U6.10 (VOUT1), U11.3 (~WP), U11.7 (~HOLD), U11.8 (VDD)
/ATTN: J6.29, R4.2, U1.37 (PB2)
/Aux Power Switch 3V3/ENABLE0: U16.12 (GP0), U18.4 (ON2)
/Aux Power Switch 3V3/ENABLE1: U16.13 (GP1), U18.2 (ON1)
/Aux Power Switch 3V3/ENABLE2: U6.4 (ON2), U16.14 (GP2)
/Aux Power Switch 3V3/ENABLE3: U6.2 (ON1), U16.15 (GP3)
/Aux Power Switch 3V3/RESET: U1.35 (PB0), U16.6 (*RESET)
/Aux Power Switch 3V3/VBUS: C46.1, C47.1, C74.1, C77.1, C78.1, R27.2, U6.1 (VIN1), U6.3 (VBIAS), U6.5 (VIN2), U17.8 (VBUS), U17.9 (IN-), U18.1 (VIN1), U18.3 (VBIAS), U18.5 (VIN2)
/CAN1_H: C20.1, D2.1 (K), J6.40, R8.1, U3.7 (CANH)
/CAN1_L: C22.2, D2.2 (K), J6.38, R9.2, U3.6 (CANL)
/CAN1_RX: U1.81 (PD0), U3.4 (RXD)
/CAN1_SHDN: U1.56 (PD9), U3.5 (SHTD)
/CAN1_STB: U1.55 (PD8), U3.8 (STB)
/CAN1_TX: U1.82 (PD1), U3.1 (TXD)
/CAN2_H: C16.1, D1.1 (K), J6.39, R6.1, U2.7 (CANH)
/CAN2_L: C18.2, D1.2 (K), J6.37, R7.2, U2.6 (CANL)
/CAN2_RX: U1.92 (PB6), U2.4 (RXD)
/CAN2_SHDN: U1.98 (PE1), U2.5 (SHTD)
/CAN2_STB: U1.97 (PE0), U2.8 (STB)
/CAN2_TX: U1.91 (PB5), U2.1 (TXD)
/Cameras/1V8_A: C24.1, C86.2, J3.11, JP1.1 (A), JP2.1 (A), RN8.3 (R2.2), RN8.4 (R1.2), U19.6 (VOUT2)
/Cameras/1V8_B: C26.1, C35.2, J4.11, JP3.1 (A), JP4.1 (A), RN9.3 (R2.2), RN9.4 (R1.2), U4.6 (VOUT2)
/Cameras/1V8_C: C28.1, C42.2, J5.11, JP5.1 (A), JP6.1 (A), RN10.3 (R2.2), RN10.4 (R1.2), U5.6 (VOUT2)
/Cameras/2V8_A: C25.1, C83.1, J3.4, U19.10 (VOUT1)
/Cameras/2V8_B: C27.1, C32.1, J4.4, U4.10 (VOUT1)
/Cameras/2V8_C: C29.1, C39.1, J5.4, U5.10 (VOUT1)
/Cameras/*RESET_1V8: C58.1, J3.6, J4.6, J5.6, R17.2, U9.3 (A2)
/Cameras/CLK_OE: U1.79 (PC11), X1.1 (TRI-STATE)
/Cameras/Camera_A/A_GND: J3.2, NT1.1
/Cameras/Camera_A/DCMI_02: J3.19, J4.19, J5.19, U8.6 (A5)
/Cameras/Camera_A/DCMI_03: J3.21, J4.21, J5.21, U8.8 (A7)
/Cameras/Camera_A/DCMI_04: J3.22, J4.22, J5.22, U8.9 (A8)
/Cameras/Camera_A/DCMI_05: J3.20, J4.20, J5.20, U8.7 (A6)
/Cameras/Camera_A/DCMI_06: J3.18, J4.18, J5.18, U8.5 (A4)
/Cameras/Camera_A/DCMI_07: J3.16, J4.16, J5.16, U8.3 (A2)
/Cameras/Camera_A/DCMI_08: J3.14, J4.14, J5.14, U8.1 (A1)
/Cameras/Camera_A/DCMI_09: J3.12, J4.12, J5.12, U9.7 (A6)
/Cameras/Camera_A/DCMI_HSYNC: J3.9, J4.9, J5.9, U9.6 (A5)
/Cameras/Camera_A/DCMI_VSYNC: J3.7, J4.7, J5.7, U9.4 (A3)
/Cameras/Camera_A/SCK: J3.5, RN8.1 (R1.1), U7.5 (SC0)
/Cameras/Camera_A/SDA: J3.3, RN8.2 (R2.1), U7.4 (SD0)
/Cameras/Camera_A/STROBE: J3.1, J4.1, J5.1, U9.1 (A1)
/Cameras/Camera_B/A_GND: J4.2, NT2.1
/Cameras/Camera_B/SCK: J4.5, RN9.1 (R1.1), U7.7 (SC1)
/Cameras/Camera_B/SDA: J4.3, RN9.2 (R2.1), U7.6 (SD1)
/Cameras/Camera_C/A_GND: J5.2, NT3.1
/Cameras/Camera_C/SCK: J5.5, RN10.1 (R1.1), U7.10 (SC2)
/Cameras/Camera_C/SDA: J5.3, RN10.2 (R2.1), U7.9 (SD2)
/Cameras/DCMI_00: U1.63 (PC6), U8.15 (B5)
/Cameras/DCMI_01: U1.64 (PC7), U8.13 (B7)
/Cameras/DCMI_02: U1.65 (PC8), U8.12 (B8)
/Cameras/DCMI_03: U1.66 (PC9), U8.14 (B6)
/Cameras/DCMI_04: U1.3 (PE4), U8.16 (B4)
/Cameras/DCMI_05: U1.84 (PD3), U8.18 (B2)
/Cameras/DCMI_06: U1.4 (PE5), U8.20 (B1)
/Cameras/DCMI_07: U1.5 (PE6), U9.10 (B6)
/Cameras/DCMI_HSYNC: U1.29 (PA4), U9.11 (B5)
/Cameras/DCMI_PLXCLK: U1.31 (PA6), U8.17 (B3)
/Cameras/DCMI_PLXCLK_1V8: C57.1, J3.17, J4.17, J5.17, U8.4 (A3)
/Cameras/DCMI_VSYNC: U1.93 (PB7), U9.13 (B3)
/Cameras/ENABLE_1V8: U1.54 (PB15), U15.5 (EN)
/Cameras/ENABLE_2V8: U1.53 (PB14), U14.5 (EN)
/Cameras/ENABLE_A: U1.85 (PD4), U19.2 (ON1), U19.4 (ON2)
/Cameras/ENABLE_B: U1.86 (PD5), U4.2 (ON1), U4.4 (ON2)
/Cameras/ENABLE_C: U1.61 (PD14), U5.2 (ON1), U5.4 (ON2)
/Cameras/I2C_RST: R12.2, U1.47 (PB10), U7.3 (RESET_N)
/Cameras/PWRDN: U1.90 (PB4), U9.12 (B4)
/Cameras/PWRDN_1V8: J3.8, J4.8, J5.8, R18.1, U9.5 (A4)
/Cameras/Power Regulator 1V8/LX1: L2.2, U15.3 (LX1)
/Cameras/Power Regulator 1V8/LX2: L2.1, U15.2 (LX2)
/Cameras/Power Regulator 1V8/R-: R14.2, R25.1, U15.8 (FB)
/Cameras/Power Regulator 2V8/LX1: L1.2, U14.3 (LX1)
/Cameras/Power Regulator 2V8/LX2: L1.1, U14.2 (LX2)
/Cameras/Power Regulator 2V8/R-: R13.2, R24.1, U14.8 (FB)
/Cameras/RESET: U1.89 (PB3), U9.14 (B2)
/Cameras/STROBE: U1.88 (PD7), U9.16 (B1)
/Cameras/XCLK: J3.13, J4.13, J5.13, X1.3 (OUTPUT)
/Flash1/SPI_CLK: RN4.1 (R1.1), U11.6 (SCK), U12.6 (SCK), U13.6 (SCK)
/Flash1/SPI_MISO: R1.2, U11.2 (SO), U12.2 (SO/IO1), U13.2 (SO/IO1)
/Flash1/SPI_MOSI: RN4.2 (R2.1), U11.5 (SI), U12.5 (SI/IO0), U13.5 (SI/IO0)
/I2C1_SCK: RN3.1 (R1.1), U1.95 (PB8), U7.14 (SCL)
/I2C1_SDA: RN3.2 (R2.1), U1.96 (PB9), U7.15 (SDA)
/I2C2_SCK: J7.2, RN2.1 (R1.1), U1.52 (PB13)
/I2C2_SDA: J7.3, RN2.2 (R2.1), U1.48 (PB11)
/I2C4_SCK: RN6.1 (R1.1), U1.59 (PD12), U16.1 (SCL), U17.5 (SCL)
/I2C4_SDA: RN6.2 (R2.1), U1.60 (PD13), U16.2 (SDA), U17.4 (SDA)
/INTERBOARD CONNECTOR/BATT: J6.3, J6.4
/PMIC/ADC3_IN3: RN1.4 (R1.2), U1.17 (PC2)
/PMIC/ADC3_IN4: RN1.3 (R2.2), U1.18 (PC3)
/PMIC/BOOT0: J8.5, R19.1, SW1.2, U1.94 (PH3)
/PMIC/LED1: RN11.16 (R), U1.51 (PB12)
/PMIC/LED2: RN11.15 (R), U1.57 (PD10)
/PMIC/LED3: RN11.14 (R), U1.77 (PA15)
/PMIC/LED4: RN11.13 (R), U1.62 (PD15)
/PMIC/LED5: RN11.12 (R), U1.67 (PA8)
/PMIC/LPUART_RX: J1.2, U1.15 (PC0)
/PMIC/LPUART_TX: J1.3, U1.16 (PC1)
/PMIC/NRST: J8.4, R5.2, U1.14 (NRST), U10.4 (OUT2), U10.6 (OUT1)
/PMIC/OSC32_IN: U1.8 (PC14), X3.3 (OUT)
/PMIC/OSC_HSE_IN: U1.12 (PH0), X2.3 (OUTPUT)
/PMIC/OSC_HSE_OE: U1.7 (PC13), X2.1 (TRI-STATE)
/PMIC/RESET: C68.1, RN7.4 (R1.2), SW2.3, U10.3 (IN2)
/PMIC/SPI1_MISO: R1.1, U1.45 (PE14)
/PMIC/SPI1_MOSI: RN4.3 (R2.2), U1.32 (PA7)
/PMIC/SPI1_SCK: RN4.4 (R1.2), U1.30 (PA5)
/PMIC/SWCLK: J8.3, U1.76 (PA14)
/PMIC/SWDIO: J8.2, U1.72 (PA13)
/PMIC/USART1_RX: J9.2, U1.69 (PA10)
/PMIC/USART1_TX: J9.3, U1.68 (PA9)
/PMIC/USART3_CTS: TP4.1, U1.58 (PD11)
/PMIC/USART3_RTS: TP3.1, U1.36 (PB1)
/PMIC/USART3_RX: TP2.1, U1.34 (PC5)
/PMIC/USART3_TX: TP1.1, U1.33 (PC4)
/PMIC/USB_OTG_FS_DM: J2.A7 (DN1_A), J2.B7 (DN2_B), U1.70 (PA11)
/PMIC/USB_OTG_FS_DP: J2.A6 (DP1_A), J2.B6 (DP2_B), U1.71 (PA12)
/PMIC/VDDA: C9.1, C10.1, C14.2, C15.2, FB1.2, U1.21 (VREF+), U1.22 (VDDA)
/Power_INT: R3.2, R26.2, U1.42 (PE11), U16.8 (INT), U17.3 (ALERT)
/SCI_RESET: J6.31, RN7.3 (R2.2), U10.1 (IN1)
/SPI1_CS_FLASH1: R2.2, U1.46 (PE15), U12.1 (CS#)
/SPI1_CS_FLASH2: RN5.3 (R2.2), U1.44 (PE13), U13.1 (CS#)
/SPI1_CS_MRAM: RN5.4 (R1.2), U1.43 (PE12), U11.1 (~CS)
GND: C1.1, C2.1, C3.2, C4.2, C5.2, C6.2, C7.2, C8.2, C9.2, C10.2, C11.2, C12.1, C13.1, C14.1, C15.1, C16.2, C17.2, C18.1, C19.2, C20.2, C21.2, C22.1, C23.2, C24.2, C25.2, C26.2, C27.2, C28.2, C29.2, C30.2, C31.2, C32.2, C33.2, C34.1, C35.1, C36.2, C37.2, C38.2, C39.2, C40.2, C41.1, C42.1, C43.2, C44.2, C45.2, C46.2, C47.2, C48.1, C49.1, C50.2, C51.2, C52.2, C53.2, C54.2, C55.2, C56.2, C57.2, C58.2, C59.2, C60.2, C61.1, C62.2, C63.2, C64.2, C65.2, C66.2, C67.2, C68.2, C69.2, C70.2, C71.2, C72.2, C73.2, C74.2, C75.2, C76.2, C77.2, C78.2, C79.1, C80.1, C81.2, C82.2, C83.2, C84.2, C85.1, C86.1, C87.2, D1.3 (A), D2.3 (A), D3.1 (K), D4.1 (K), D5.1 (K), D6.1 (K), D7.1 (K), H1.1, H2.1, H3.1, H4.1, J1.1, J2.A1_B12 (GND), J2.B1_A12 (GND__1), J3.15, J3.MP1, J3.MP2, J4.15, J4.MP1, J4.MP2, J5.15, J5.MP1, J5.MP2, J6.1, J6.2, J6.9, J6.10, J6.26, J6.27, J6.28, J6.35, J6.36, J7.1, J8.1, J9.1, JP1.3 (B), JP2.3 (B), JP3.3 (B), JP4.3 (B), JP5.3 (B), JP6.3 (B), NT1.2, NT2.2, NT3.2, R10.1, R11.1, R15.2, R16.2, R18.2, R19.2, R24.2, R25.2, SW2.4, TP6.1, U1.10 (VSS), U1.19 (VSSA), U1.20 (VREF-), U1.27 (VSS), U1.49 (VSS), U1.74 (VSS), U1.99 (VSS), U2.2 (GND), U2.9 (GND), U3.2 (GND), U3.9 (GND), U4.8 (GND), U4.11 (TPAD), U5.8 (GND), U5.11 (TPAD), U6.8 (GND), U6.11 (TPAD), U7.1 (A0), U7.2 (A1), U7.8 (GND), U7.13 (A2), U8.11 (GND), U9.9 (GND), U10.2 (GND), U11.4 (VSS), U11.9 (PAD), U12.4 (VSS), U13.4 (VSS), U14.6 (MODE), U14.7 (GND), U15.6 (MODE), U15.7 (GND), U16.3 (A2), U16.4 (A1), U16.5 (A0), U16.9 (VSS), U17.1 (A1), U17.2 (A0), U17.7 (GND), U18.8 (GND), U18.11 (TPAD), U19.8 (GND), U19.11 (TPAD), X1.2 (GND), X2.2 (GND), X3.2 (GND)
unnamed: C17.1, R6.2, R7.1
unnamed: C21.1, R8.2, R9.1
unnamed: D3.2 (A), RN11.1 (R)
unnamed: D4.2 (A), RN11.2 (R)
unnamed: D5.2 (A), RN11.3 (R)
unnamed: D6.2 (A), RN11.4 (R)
unnamed: D7.2 (A), RN11.5 (R)
unnamed: J2.A5 (CC1_A), R10.2
unnamed: J2.B5 (CC2_B), R11.2
unnamed: J3.23, JP1.2 (C)
unnamed: J3.24, JP2.2 (C)
unnamed: J4.23, JP3.2 (C)
unnamed: J4.24, JP4.2 (C)
unnamed: J5.23, JP5.2 (C)
unnamed: J5.24, JP6.2 (C)
unnamed: C31.1, U4.9 (CT1)
unnamed: C34.2, U4.7 (CT2)
unnamed: C38.1, U5.9 (CT1)
unnamed: C41.2, U5.7 (CT2)
unnamed: C44.1, U6.9 (CT1)
unnamed: C48.2, U6.7 (CT2)
unnamed: R21.2, U12.7 (HOLD#/IO3)
unnamed: R20.2, U12.3 (WP#/IO2)
unnamed: R23.2, U13.7 (HOLD#/IO3)
unnamed: R22.2, U13.3 (WP#/IO2)
unnamed: C75.1, U18.9 (CT1)
unnamed: C79.2, U18.7 (CT2)
unnamed: C82.1, U19.9 (CT1)
unnamed: C85.2, U19.7 (CT2)
