MatthiasGeorgImhof/Hardware_CSAT/avionics_board/AVIONICS_BOARD.kicad_pcb

## KiCad design avionics_board/AVIONICS_BOARD.kicad_pcb (2026-06-08)

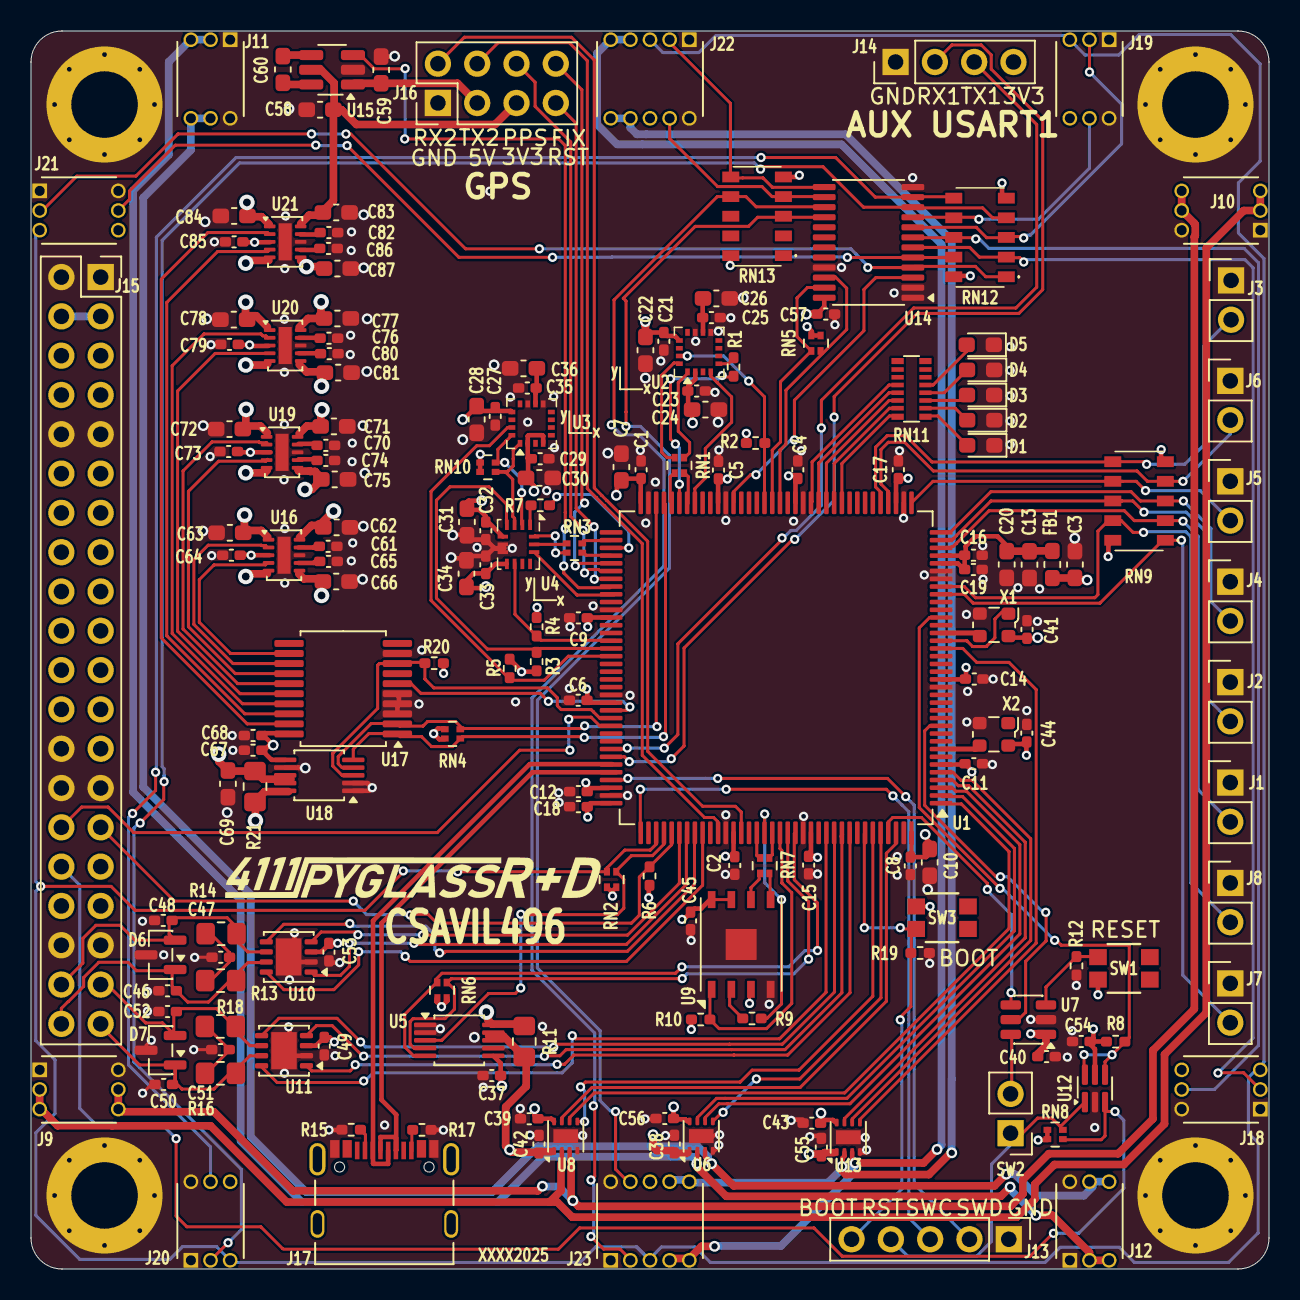
[picture p63: board AVIONICS_BOARD.kicad_pcb from above]

Board: 4 copper layers, 80.0 x 80.0 mm, 182 parts (0 on the bottom side), 161 nets.

Parts:
C1, C2, C4, C5, C6, C8, C9, C11, C12, C14, C15, C16, C17, C18, C19, C21, C23, C25, C27, C29, C32, C33, C35, C37, C38, C39, C40, C41, C42, C43, C44, C45, C49, C53, C54, C55, C56, C57, C64, C67, C68, C73, C79, C85: 100nF; C_0402_1005Metric_Pad0.74x0.62mm_HandSolder
C3, C7, C10, C13, C20, C22, C24, C26, C28, C30, C31, C34, C36, C58, C59, C62, C66, C69, C71, C75, C77, C81, C83, C87: 10uF; C_0603_1608Metric_Pad1.08x0.95mm_HandSolder
C46, C48, C50, C52: 100pF; C_0402_1005Metric_Pad0.74x0.62mm_HandSolder
C47, C51: 4nF7; C_0402_1005Metric_Pad0.74x0.62mm_HandSolder
C60: 1uF; C_0603_1608Metric_Pad1.08x0.95mm_HandSolder
C61, C65, C70, C74, C76, C80, C82, C86: 220pF; C_0402_1005Metric_Pad0.74x0.62mm_HandSolder
C63, C72, C78, C84: 22uF; C_0603_1608Metric_Pad1.08x0.95mm_HandSolder
D1: RED; LED_0603_1608Metric_Pad1.05x0.95mm_HandSolder
D2: GREEN; LED_0603_1608Metric_Pad1.05x0.95mm_HandSolder
D3, D4, D5: YELLOW; LED_0603_1608Metric_Pad1.05x0.95mm_HandSolder
D6, D7: NUP2105LT1G; SOT-23
FB1: 120R; L_0603_1608Metric_Pad1.05x0.95mm_HandSolder
H1, H2, H3, H4: MountingHole_Pad; MountingHole_4.3mm_M4_Pad_Via_Custom
J1, J2, J3, J4, J5, J6, J7, J8: Conn_01x02_Pin Vertical; PinHeader_1x02_P2.54mm_Vertical
J9, J10, J11, J12, J18, J19, J20, J21: Conn_02x03_Odd_Even; HARWIN_M50-3200345
J13: Conn_01x05_Pin Vertical; PinHeader_1x05_P2.54mm_Vertical
J14: Conn_01x04_Pin Vertical; PinHeader_1x04_P2.54mm_Vertical
J15: PC104 Conn_02x20_Odd_Even; PinSocket_2x20_P2.54mm_Vertical
J16: Conn_02x04; PinHeader_2x04_P2.54mm_Vertical
J17: 10155435-00011LF; AMPHENOL_10155435-00011LF
J22, J23: Conn_02x05_Odd_Even; HARWIN_M50-3200545
R1, R7, R9: 22R; R_0402_1005Metric_Pad0.72x0.64mm_HandSolder
R2, R3, R4, R5, R8, R10, R19, R20: 100K; R_0402_1005Metric_Pad0.72x0.64mm_HandSolder
R6: 330K; R_0402_1005Metric_Pad0.72x0.64mm_HandSolder
R11, R21: 10m; R_0805_2012Metric_Pad1.20x1.40mm_HandSolder
R12: 22K; R_0402_1005Metric_Pad0.72x0.64mm_HandSolder
R13, R14, R16, R18: 60R4; R_0805_2012Metric_Pad1.20x1.40mm_HandSolder
R15, R17: 5K1; R_0402_1005Metric_Pad0.72x0.64mm_HandSolder
RN1, RN3, RN7: 22R; R_Array_Convex_2x0402_widepads
RN2, RN8: 100K; R_Array_Convex_2x0402_widepads
RN4, RN5, RN6, RN10: 5K6; R_Array_Convex_2x0402_widepads
RN9: 22K; R_Array_Concave_5x2512_widepads
RN11: 1K; R_Array_Convex_8x0602_widepads
RN12, RN13: 5K6; R_Array_Concave_5x2512_widepads
SW1, SW3: EVP-AA602W; EVP602AA
SW2: Conn_01x02_Pin Vertical; PinHeader_1x02_P2.54mm_Vertical
U1: STM32L496ZGTx; LQFP-144_20x20mm_P0.5mm
U2, U3: MMC5983MA; LGA-16_3x3mm_P0.5mm
U4: BMI270; Bosch_LGA-14_3x2.5mm_P0.5mm
U5, U18: INA226; VSSOP-10_3x3mm_P0.5mm
U6, U8, U13: DRV8838; WSON-8-1EP_2x2mm_P0.5mm_EP0.9x1.6mm
U7: TPL5010; SOT-23-6
U9: MR25H10; DFN-8-1EP_6x5mm_P1.27mm_EP2x2mm
U10, U11: TCAN3414; VSON-8-1EP_3x3mm_P0.65mm_EP1.65x2.4mm
U12: 74LVC2G07; SOT-363_SC-70-6
U14: TCA9548APWR; TSSOP-24_4.4x7.8mm_P0.65mm
U15: AP3602AKTR-G1; SOT-23-6_Handsoldering
U16, U19, U20, U21: TPS22968QDMGRQ1; WSON-10-1EP_2x3mm_P0.5mm_EP0.84x2.4mm
U17: MCP23008T-E/SS; SSOP-20_5.3x7.2mm_P0.65mm
X1: 10MHz; Oscillator_SMD_ECS_2520MV-xxx-xx-4Pin_2.5x2.0mm
X2: 32.768KHZ; Oscillator_SMD_ECS_2520MV-xxx-xx-4Pin_2.5x2.0mm

Connections:
/3V3_ACS_LOGIC: C37.1, C39.1, C43.1, C56.1, C66.2, RN6.3 (R2.2), RN6.4 (R1.2), U5.6 (VS), U6.8 (VCC), U8.8 (VCC), U13.8 (VCC), U16.6 (VOUT2)
/3V3_AUX: C67.1, C68.1, J15.11, R20.1, R21.1, RN4.3 (R2.2), RN4.4 (R1.2), U17.20 (VDD), U18.6 (VS), U18.10 (IN+)
/3V3_CLK: C41.1, C71.1, U19.10 (VOUT1), X1.4 (VDD)
/3V3_GPS: C58.1, C83.1, J16.5, U15.5 (VIN), U21.10 (VOUT1)
/3V3_GYRO: C27.2, C28.1, C29.2, C30.1, C31.1, C32.1, C33.1, C34.1, C75.2, RN10.3 (R2.2), RN10.4 (R1.2), U3.2 (VDD), U3.4 (SPI_CS), U3.13 (VDDIO), U4.5 (VDDIO), U4.8 (VDD), U19.6 (VOUT2)
/3V3_MAG: C21.2, C22.1, C23.2, C24.1, C77.1, U2.2 (VDD), U2.13 (VDDIO), U20.10 (VOUT1)
/3V3_MRAM: C45.1, C62.1, R10.2, U9.3 (~WP), U9.7 (~HOLD), U9.8 (VDD), U16.10 (VOUT1)
/3V3_STM_CORE: C1.1, C2.1, C3.1, C4.1, C5.2, C6.1, C7.2, C8.2, C9.2, C10.2, C11.1, C12.2, C14.1, C15.2, C17.1, C18.2, C40.1, C44.1, C49.1, C53.1, C54.2, FB1.1, J14.4, J15.12, R2.1, R3.1, R4.1, R5.1, R6.1, R8.1, RN2.3 (R2.2), RN2.4 (R1.2), RN8.1 (R1.1), RN8.2 (R2.1), SW1.2, SW3.1, U1.6 (VBAT), U1.17 (VDD), U1.39 (VDD), U1.52 (VDD), U1.62 (VDD), U1.72 (VDD), U1.84 (VDD), U1.95 (VDDIO2), U1.106 (VDDUSB), U1.108 (VDD), U1.121 (VDD), U1.131 (VDDIO2), U1.144 (VDD), U7.1 (VDD), U10.3 (VCC), U11.3 (VCC), U12.5 (VCC), X2.4 (VCC)
/3V3_SUN: C57.1, C87.2, J18.6, J19.6, J20.6, J21.6, J22.6, J23.6, RN5.3 (R2.2), RN5.4 (R1.2), RN12.5, RN12.10, RN13.5, RN13.10, U14.24 (VCC), U21.6 (VOUT2)
/3V3_TEMP: C81.2, RN9.5, RN9.10, U20.6 (VOUT2)
/5V_ACS_COIL: J15.7, R11.1, U5.10 (Vin+)
/*ATTENTION: J15.29, R6.2, U1.113 (PC12)
/*AVI_RST: J15.32, RN8.3 (R2.2), U12.3 (IN2)
/*EPS_RST: J15.30, U1.98 (PC8)
/ACS/PWR_DRIVER: C38.1, C42.1, C55.1, R11.2, U5.8 (Vbus), U5.9 (Vin-), U6.1 (VM), U8.1 (VM), U13.1 (VM)
/ACS/X_N: J9.4, J9.6, J10.4, J10.6, U8.3 (OUT2)
/ACS/X_P: J9.3, J9.5, J10.3, J10.5, U8.2 (OUT1)
/ACS/Y_N: J11.4, J11.6, J12.4, J12.6, U6.3 (OUT2)
/ACS/Y_P: J11.3, J11.5, J12.3, J12.5, U6.2 (OUT1)
/ACS_INT: RN2.1 (R1.1), U1.112 (PC11), U5.3 (~Alert)
/ACS_X_PH: U1.1 (PE2), U8.6 (PH)
/ACS_X_SLEEP: U1.142 (PE1), U8.7 (~SLEEP)
/ACS_Y_PH: U1.3 (PE4), U6.6 (PH)
/ACS_Y_SLEEP: U1.2 (PE3), U6.7 (~SLEEP)
/ACS_Z_PH: U1.5 (PE6), U13.6 (PH)
/ACS_Z_SLEEP: U1.4 (PE5), U13.7 (~SLEEP)
/ADC1_IN3: J7.2, RN9.1, U1.28 (PC2)
/ADC1_IN4: J8.2, RN9.9, U1.29 (PC3)
/ADC1_IN5: J1.2, RN9.2, U1.34 (PA0)
/ADC1_IN6: J2.2, RN9.8, U1.35 (PA1)
/ADC1_IN7: J4.2, RN9.3, U1.36 (PA2)
/ADC1_IN8: J5.2, RN9.7, U1.37 (PA3)
/ADC1_IN9: J6.2, RN9.4, U1.40 (PA4)
/ADC1_IN10: J3.2, RN9.6, U1.41 (PA5)
/AUX POWER/ENABLE_0: U16.4 (ON2), U17.12 (GP0)
/AUX POWER/ENABLE_1: U16.2 (ON1), U17.13 (GP1)
/AUX POWER/ENABLE_2: U17.14 (GP2), U19.4 (ON2)
/AUX POWER/ENABLE_3: U17.15 (GP3), U19.2 (ON1)
/AUX POWER/ENABLE_4: U17.16 (GP4), U20.4 (ON2)
/AUX POWER/ENABLE_5: U17.17 (GP5), U20.2 (ON1)
/AUX POWER/ENABLE_6: U17.18 (GP6), U21.4 (ON2)
/AUX POWER/ENABLE_7: U17.19 (GP7), U21.2 (ON1)
/AUX POWER/VBUS: C63.1, C64.1, C69.1, C72.1, C73.1, C78.1, C79.1, C84.1, C85.1, R21.2, U16.1 (VIN1), U16.3 (VBIAS), U16.5 (VIN2), U18.8 (VBUS), U18.9 (IN-), U19.1 (VIN1), U19.3 (VBIAS), U19.5 (VIN2), U20.1 (VIN1), U20.3 (VBIAS), U20.5 (VIN2), U21.1 (VIN1), U21.3 (VBIAS), U21.5 (VIN2)
/CAN1_H: C46.1, D6.1 (K), J15.40, R13.1, U10.7 (CANH)
/CAN1_L: C48.2, D6.2 (K), J15.38, R14.2, U10.6 (CANL)
/CAN2_H: C50.1, D7.1 (K), J15.39, R16.1, U11.7 (CANH)
/CAN2_L: C52.2, D7.2 (K), J15.37, R18.2, U11.6 (CANL)
/GPS_INTERFACE/CAN_POWER6/VOUT: C59.1, J16.3, U15.1 (VOUT)
/GPS_INTERFACE/FIX: J16.8, U1.77 (PD8)
/GPS_INTERFACE/PPS: J16.6, U1.78 (PD9)
/GPS_INTERFACE/RESET: J16.7, U1.79 (PD10)
/GPS_INTERFACE/SHDN_5V: U1.80 (PD11), U15.3 (*SHDN)
/GPS_INTERFACE/UART_RX: J16.2, U1.122 (PD6)
/GPS_INTERFACE/UART_TX: J16.4, U1.119 (PD5)
/GYRO1_INT: R3.2, U1.88 (PG3), U4.4 (INT1)
/GYRO2_INT: R4.2, U1.87 (PG2), U4.9 (INT2)
/GYRO/SCL: RN10.1 (R1.1), U3.1 (SCL/SPI_SCK), U4.3 (ASCx)
/GYRO/SDA: RN10.2 (R2.1), U3.16 (SDA/SPI_SDI), U4.2 (ASDx)
/GYROAUX_INT: R5.2, U1.89 (PG4), U3.15 (INT)
/GYRO_CS: U1.81 (PD12), U4.12 (CSB)
/I2C1_SCL: RN6.2 (R2.1), U1.129 (PG14), U5.5 (SCL)
/I2C1_SDA: RN6.1 (R1.1), U1.128 (PG13), U5.4 (SDA)
/I2C2_SCL: RN4.1 (R1.1), U1.69 (PB10), U17.1 (SCL), U18.5 (SCL)
/I2C2_SDA: RN4.2 (R2.1), U1.70 (PB11), U17.2 (SDA), U18.4 (SDA)
/I2C4_SCL: RN5.2 (R2.1), U1.54 (PF14), U14.22 (SCL)
/I2C4_SDA: RN5.1 (R1.1), U1.55 (PF15), U14.23 (SDA)
/INTERBOARD_CONNECTOR/BATT: J15.3, J15.4
/MAG_CS: U1.65 (PE12), U2.4 (SPI_CS)
/MAG_INT: R2.2, U1.56 (PG0), U2.15 (INT)
/Power_INT: R20.2, U1.97 (PC7), U17.8 (INT), U18.3 (ALERT)
/Power_RST: U1.96 (PC6), U17.6 (*RESET)
/RST_SUN: U1.60 (PE9), U14.3 (~RESET)
/SPI1_MISO: R1.1, U2.5 (SPI_SDO)
/SPI1_MOSI: RN1.2 (R2.1), U2.16 (SDA/SPI_SDI)
/SPI1_SCK: RN1.1 (R1.1), U2.1 (SCL/SPI_SCK)
/SPI2_MISO: R7.1, U4.1 (SDO)
/SPI2_MOSI: RN3.2 (R2.1), U4.14 (SDx)
/SPI2_SCK: RN3.1 (R1.1), U4.13 (SCx)
/STM32L4/10MHZ_OE: U1.22 (PF10), X1.1 (TRI-STATE)
/STM32L4/BOOT0: J13.5, R19.1, SW3.2, U1.138 (PH3)
/STM32L4/CAN1_RX: U1.114 (PD0), U10.4 (RXD)
/STM32L4/CAN1_SHDN: U1.116 (PD2), U10.5 (SHTD)
/STM32L4/CAN1_STB: U1.117 (PD3), U10.8 (STB)
/STM32L4/CAN1_TX: U1.115 (PD1), U10.1 (TXD)
/STM32L4/CAN2_RX: U1.135 (PB5), U11.4 (RXD)
/STM32L4/CAN2_SHDN: U1.134 (PB4), U11.5 (SHTD)
/STM32L4/CAN2_STB: U1.133 (PB3), U11.8 (STB)
/STM32L4/CAN2_TX: U1.136 (PB6), U11.1 (TXD)
/STM32L4/JTCK_SWCLK: J13.3, U1.109 (PA14)
/STM32L4/JTMS_SWDIO: J13.2, U1.105 (PA13)
/STM32L4/LED_1: RN11.16 (R), U1.46 (PB0)
/STM32L4/LED_2: RN11.15 (R), U1.47 (PB1)
/STM32L4/LED_3: RN11.14 (R), U1.48 (PB2)
/STM32L4/LED_4: RN11.13 (R), U1.49 (PF11)
/STM32L4/LED_5: RN11.12 (R), U1.50 (PF12)
/STM32L4/MRAM/SPI_MISO: R9.2, U9.2 (SO)
/STM32L4/MRAM/SPI_MOSI: RN7.4 (R1.2), U9.5 (SI)
/STM32L4/MRAM/SPI_SCK: RN7.3 (R2.2), U9.6 (SCK)
/STM32L4/MRAM_CS: R10.1, U1.127 (PG12), U9.1 (~CS)
/STM32L4/NRST: R8.2, U1.25 (NRST), U12.4 (OUT2), U12.6 (OUT1)
/STM32L4/RCC_OSC32_IN: U1.8 (PC14), X2.3 (OUT)
/STM32L4/RCC_OSC_IN: U1.23 (PH0), X1.3 (OUTPUT)
/STM32L4/RST: J13.4, RN8.4 (R1.2), SW2.1, U12.1 (IN1)
/STM32L4/SPI1_MISO: R1.2, U1.67 (PE14)
/STM32L4/SPI1_MOSI: RN1.3 (R2.2), U1.68 (PE15)
/STM32L4/SPI1_SCK: RN1.4 (R1.2), U1.66 (PE13)
/STM32L4/SPI2_MISO: R7.2, U1.75 (PB14)
/STM32L4/SPI2_MOSI: RN3.3 (R2.2), U1.76 (PB15)
/STM32L4/SPI2_SCK: RN3.4 (R1.2), U1.74 (PB13)
/STM32L4/SPI3_MISO: R9.1, U1.125 (PG10)
/STM32L4/SPI3_MOSI: RN7.1 (R1.1), U1.126 (PG11)
/STM32L4/SPI3_SCK: RN7.2 (R2.1), U1.124 (PG9)
/STM32L4/USART1_RX: J14.2, U1.102 (PA10)
/STM32L4/USART1_TX: J14.3, U1.101 (PA9)
/STM32L4/USB/DN: J17.A7 (DN1_A), J17.B7 (DN2_B), U1.103 (PA11)
/STM32L4/USB/DP: J17.A6 (DP1_A), J17.B6 (DP2_B), U1.104 (PA12)
/STM32L4/VDDA: C13.1, C16.1, C19.2, C20.2, FB1.2, U1.32 (VREF+), U1.33 (VDDA)
/STM32L4/WATCHDOG_DONE: U1.141 (PE0), U7.4 (DONE)
/STM32L4/WATCHDOG_WAKE: U1.11 (PF1), U7.5 (WAKE)
/SUN_INT: J18.5, J19.5, J20.5, J21.5, J22.5, J23.5, RN2.2 (R2.1), U1.111 (PC10)
/Solar Sensors/SC0: J21.4, RN12.9, U14.5 (SC0)
/Solar Sensors/SC1: J18.4, RN12.8, U14.7 (SC1)
/Solar Sensors/SC2: J19.4, RN12.7, U14.9 (SC2)
/Solar Sensors/SC3: J20.4, RN12.6, U14.11 (SC3)
/Solar Sensors/SC4: J22.4, RN13.4, U14.14 (SC4)
/Solar Sensors/SC5: J23.4, RN13.3, U14.16 (SC5)
/Solar Sensors/SD0: J21.3, RN12.1, U14.4 (SD0)
/Solar Sensors/SD1: J18.3, RN12.2, U14.6 (SD1)
/Solar Sensors/SD2: J19.3, RN12.3, U14.8 (SD2)
/Solar Sensors/SD3: J20.3, RN12.4, U14.10 (SD3)
/Solar Sensors/SD4: J22.3, RN13.6, U14.13 (SD4)
/Solar Sensors/SD5: J23.3, RN13.7, U14.15 (SD5)
/TIM15_CH1: U1.21 (PF9), U13.5 (EN)
/TIM16_CH1: U1.139 (PB8), U8.5 (EN)
/TIM17_CH1: U1.140 (PB9), U6.5 (EN)
GND: C1.2, C2.2, C3.2, C4.2, C5.1, C6.2, C7.1, C8.1, C9.1, C10.1, C11.2, C12.1, C13.2, C14.2, C15.1, C16.2, C17.2, C18.1, C19.1, C20.1, C21.1, C22.2, C23.1, C24.2, C25.1, C26.1, C27.1, C28.2, C29.1, C30.2, C31.2, C32.2, C33.2, C34.2, C35.1, C36.1, C37.2, C38.2, C39.2, C40.2, C41.2, C42.2, C43.2, C44.2, C45.2, C46.2, C47.2, C48.1, C49.2, C50.2, C51.2, C52.1, C53.2, C54.1, C55.2, C56.2, C57.2, C58.2, C59.2, C61.2, C62.2, C63.2, C64.2, C65.1, C66.1, C67.2, C68.2, C69.2, C70.2, C71.2, C72.2, C73.2, C74.1, C75.1, C76.2, C77.2, C78.2, C79.2, C80.1, C81.1, C82.2, C83.2, C84.2, C85.2, C86.1, C87.1, D1.1 (K), D2.1 (K), D3.1 (K), D4.1 (K), D5.1 (K), D6.3 (A), D7.3 (A), H1.1, H2.1, H3.1, H4.1, J1.1, J2.1, J3.1, J4.1, J5.1, J6.1, J7.1, J8.1, J9.1, J9.2, J10.1, J10.2, J11.1, J11.2, J12.1, J12.2, J13.1, J14.1, J15.1, J15.2, J15.9, J15.10, J15.26, J15.27, J15.28, J15.35, J15.36, J16.1, J17.A1_B12 (GND), J17.B1_A12 (GND__1), J18.1, J18.2, J19.1, J19.2, J20.1, J20.2, J21.1, J21.2, J22.1, J22.2, J23.1, J23.2, R12.2, R15.1, R17.1, R19.2, U1.16 (VSS), U1.30 (VSSA), U1.31 (VREF-), U1.38 (VSS), U1.51 (VSS), U1.61 (VSS), U1.71 (VSS), U1.83 (VSS), U1.94 (VSS), U1.107 (VSS), U1.120 (VSS), U1.130 (VSS), U1.143 (VSS), U2.9 (VSS), U2.11 (VSS), U3.9 (VSS), U3.11 (VSS), U4.6 (GNDIO), U4.7 (GND), U5.1 (A1), U5.2 (A0), U5.7 (GND), U6.4 (GND), U6.9 (GND), U7.2 (GND), U8.4 (GND), U8.9 (GND), U9.4 (VSS), U9.9 (PAD), U10.2 (GND), U10.9 (GND), U11.2 (GND), U11.9 (GND), U12.2 (GND), U13.4 (GND), U13.9 (GND), U14.1 (A0), U14.2 (A1), U14.12 (GND), U14.21 (A2), U15.2 (GND), U16.8 (GND), U16.11 (TPAD), U17.3 (A2), U17.4 (A1), U17.5 (A0), U17.9 (VSS), U18.1 (A1), U18.2 (A0), U18.7 (GND), U19.8 (GND), U19.11 (TPAD), U20.8 (GND), U20.11 (TPAD), U21.8 (GND), U21.11 (TPAD), X1.2 (GND), X2.2 (GND)
unnamed: C47.1, R13.2, R14.1
unnamed: C51.1, R16.2, R18.1
unnamed: D1.2 (A), RN11.1 (R)
unnamed: D2.2 (A), RN11.2 (R)
unnamed: D3.2 (A), RN11.3 (R)
unnamed: D4.2 (A), RN11.4 (R)
unnamed: D5.2 (A), RN11.5 (R)
unnamed: J17.A5 (CC1_A), R15.2
unnamed: J17.B5 (CC2_B), R17.2
unnamed: C25.2, C26.2, U2.10 (CAP)
unnamed: C35.2, C36.2, U3.10 (CAP)
unnamed: R12.1, SW1.1, U7.3 (DELAY/M_RST)
unnamed: SW2.2, U7.6 (~RST)
unnamed: C60.2, U15.6 (C+)
unnamed: C60.1, U15.4 (C-)
unnamed: C61.1, U16.9 (CT1)
unnamed: C65.2, U16.7 (CT2)
unnamed: C70.1, U19.9 (CT1)
unnamed: C74.2, U19.7 (CT2)
unnamed: C76.1, U20.9 (CT1)
unnamed: C80.2, U20.7 (CT2)
unnamed: C82.1, U21.9 (CT1)
unnamed: C86.2, U21.7 (CT2)
Z_N: J22.7, J22.9, J23.7, J23.9, U13.3 (OUT2)
Z_P: J22.8, J22.10, J23.8, J23.10, U13.2 (OUT1)
