MatthiasGeorgImhof/Hardware_CSAT/common/sheets/CAN_TRANSCEIVER.kicad_sch

## KiCad design common/sheets/CAN_TRANSCEIVER.kicad_sch (2026-09-15)

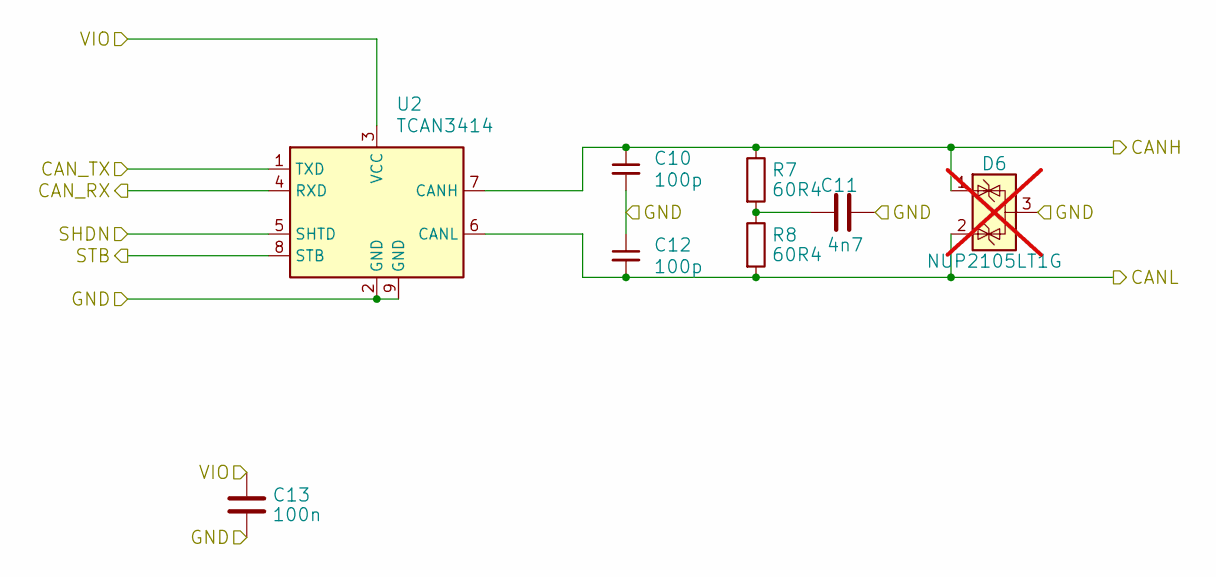
[picture p64: schematic CAN_TRANSCEIVER.kicad_sch]

Parts:
C10, C12: 100p; C_0402_1005Metric_Pad0.74x0.62mm_HandSolder; Tolerance 5; Voltage 50; Part Number GRM1555C1H101JA01D
C11: 4n7; C_0402_1005Metric_Pad0.74x0.62mm_HandSolder; Voltage 50; Tolerance 10; Part Number GRM155R61H472KA01D
C13: 100n; C_0402_1005Metric_Pad0.74x0.62mm_HandSolder; Voltage 25; Tolerance 10; Part Number GRM155R61E104KA87D
D6: NUP2105LT1G; SOT-23; Voltage 24; Part Number NUP2105LT1G; not fitted
R7, R8: 60R4; R_0805_2012Metric_Pad1.20x1.40mm_HandSolder; Tolerance 1; Part Number RC0805FR-0760R4L
U2: TCAN3414; VSON-8-1EP_3x3mm_P0.65mm_EP1.65x2.4mm; Part Number TCAN3414DRBR

Connections:
CANH: C10.1, D6.1 (K), R7.1, U2.7 (CANH)
CANL: C12.2, D6.2 (K), R8.2, U2.6 (CANL)
CAN_RX: U2.4 (RXD)
CAN_TX: U2.1 (TXD)
GND: C10.2, C11.2, C12.1, C13.2, D6.3 (A), U2.2 (GND), U2.9 (GND)
unnamed: C11.1, R7.2, R8.1
SHDN: U2.5 (SHTD)
STB: U2.8 (STB)
VIO: C13.1, U2.3 (VCC)
