MatthiasGeorgImhof/Hardware_CSAT/common/sheets/DEBUG_INTERFACE.kicad_sch

## KiCad design common/sheets/DEBUG_INTERFACE.kicad_sch (2026-06-08)

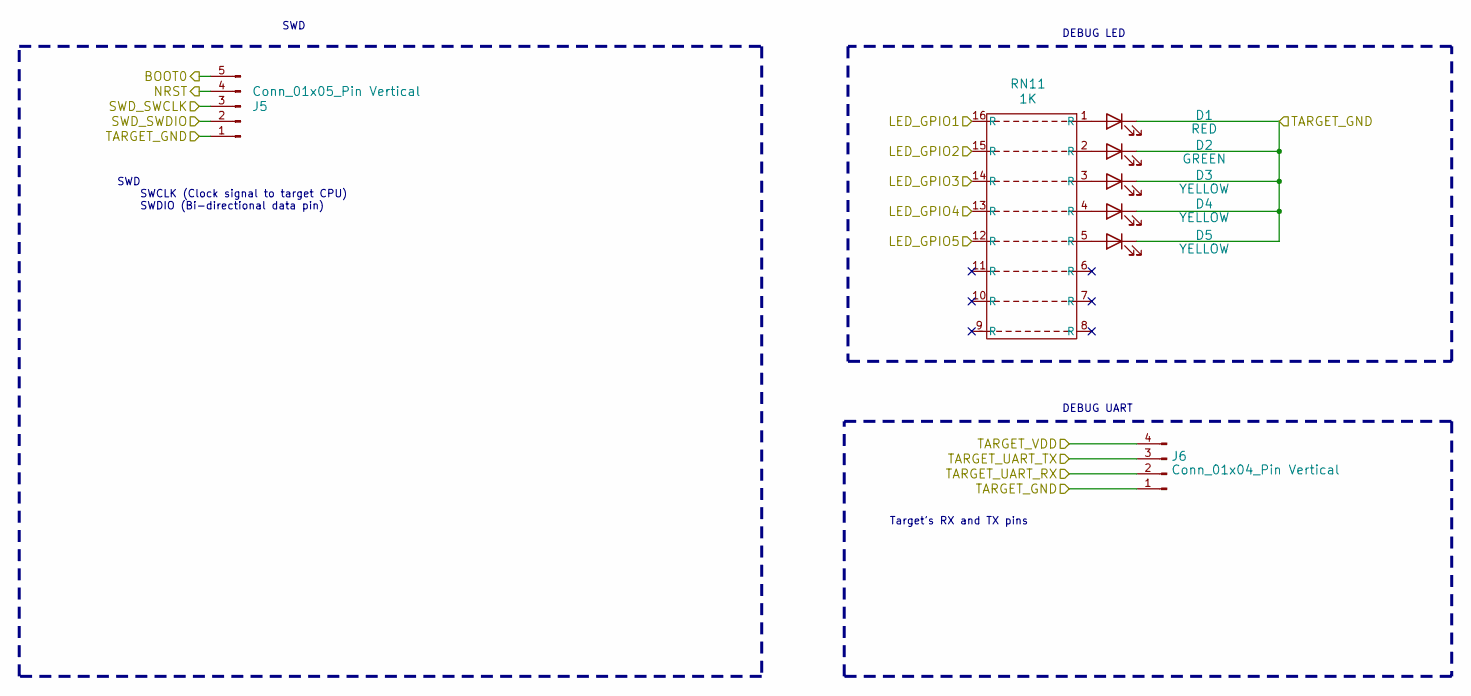
[picture p65: schematic DEBUG_INTERFACE.kicad_sch]

Parts:
D1: RED; LED_0603_1608Metric_Pad1.05x0.95mm_HandSolder; Voltage 2; Part Number LTST-C191KRKT
D2: GREEN; LED_0603_1608Metric_Pad1.05x0.95mm_HandSolder; Voltage 2; Part Number LTST-C191KGKT
D3, D4, D5: YELLOW; LED_0603_1608Metric_Pad1.05x0.95mm_HandSolder; Voltage 2; Part Number LTST-C191KSKT
J5: Conn_01x05_Pin Vertical; PinHeader_1x05_P2.54mm_Vertical; Part Number vertical
J6: Conn_01x04_Pin Vertical; PinHeader_1x04_P2.54mm_Vertical; Part Number vertical
RN11: 1K; R_Array_Convex_8x0602_widepads; Tolerance 5; Part Number EXB-2HV102JV

Connections:
BOOT0: J5.5
LED_GPIO1: RN11.16
LED_GPIO2: RN11.15
LED_GPIO3: RN11.14
LED_GPIO4: RN11.13
LED_GPIO5: RN11.12
NRST: J5.4
unnamed: D1.2 (A), RN11.1
unnamed: D2.2 (A), RN11.2
unnamed: D3.2 (A), RN11.3
unnamed: D4.2 (A), RN11.4
unnamed: D5.2 (A), RN11.5
SWD_SWCLK: J5.3
SWD_SWDIO: J5.2
TARGET_GND: D1.1 (K), D2.1 (K), D3.1 (K), D4.1 (K), D5.1 (K), J5.1, J6.1
TARGET_UART_RX: J6.2
TARGET_UART_TX: J6.3
TARGET_VDD: J6.4

Notes on the sheet:
DEBUG UART
SWD
Target's RX and TX pins
DEBUG LED
SWD SWCLK (Clock signal to target CPU) SWDIO (Bi-directional data pin)
