MatthiasGeorgImhof/Hardware_CSAT/common/sheets/MRAM.kicad_sch

## KiCad design common/sheets/MRAM.kicad_sch (2026-06-08)

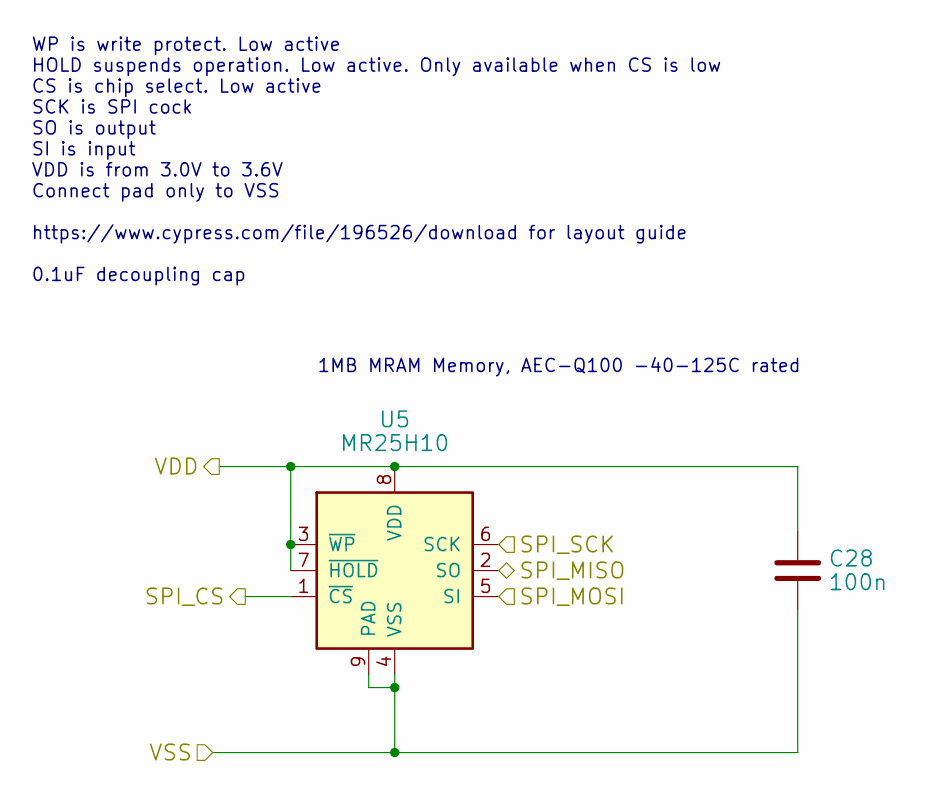
[picture p66: schematic MRAM.kicad_sch]

Parts:
C28: 100n; C_0402_1005Metric_Pad0.74x0.62mm_HandSolder; Voltage 25; Tolerance 10; Part Number GRM155R61E104KA87D
U5: MR25H10; DFN-8-1EP_6x5mm_P1.27mm_EP2x2mm; Part Number MR25H10CDFR

Connections:
SPI_CS: U5.1 (~CS)
SPI_MISO: U5.2 (SO)
SPI_MOSI: U5.5 (SI)
SPI_SCK: U5.6 (SCK)
VDD: C28.1, U5.3 (~WP), U5.7 (~HOLD), U5.8 (VDD)
VSS: C28.2, U5.4 (VSS), U5.9 (PAD)

Notes on the sheet:
WP is write protect. Low active HOLD suspends operation. Low active. Only available when CS is low CS is chip select. Low active SCK is SPI cock SO is output SI is input VDD is from 3.0V to 3.6V Connect pad only to VSS https://www.cypress.com/file/196526/download for layout guide 0.1uF decoupling c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
1MB MRAM Memory, AEC-Q100 -40-125C rated
