MatthiasGeorgImhof/Hardware_CSAT/common/sheets/OSC32_TCXO.kicad_sch

## KiCad design common/sheets/OSC32_TCXO.kicad_sch (2026-09-15)

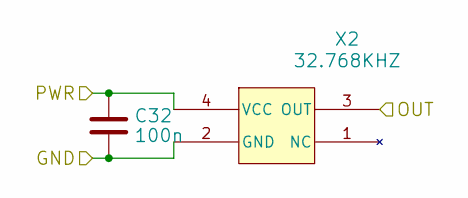
[picture p67: schematic OSC32_TCXO.kicad_sch]

Parts:
C32: 100n; C_0402_1005Metric_Pad0.74x0.62mm_HandSolder; Voltage 25; Tolerance 10; Part Number GRM155R61E104KA87D
X2: 32.768KHZ; Oscillator_SMD_ECS_2520MV-xxx-xx-4Pin_2.5x2.0mm; Tolerance 25ppm; Part Number ECS-327MVATX-2-CN-TR3

Connections:
GND: C32.2, X2.2 (GND)
OUT: X2.3 (OUT)
PWR: C32.1, X2.4 (VCC)
