MatthiasGeorgImhof/Hardware_CSAT/common/sheets/OSC_HSE_TCXO.kicad_sch

## KiCad design common/sheets/OSC_HSE_TCXO.kicad_sch (2026-09-15)

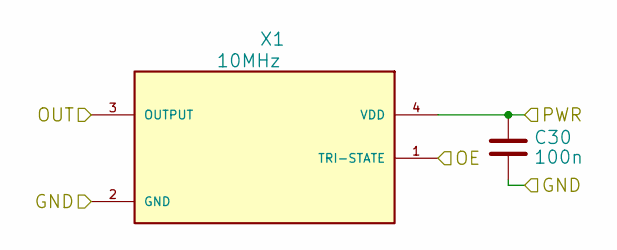
[picture p68: schematic OSC_HSE_TCXO.kicad_sch]

Parts:
C30: 100n; C_0402_1005Metric_Pad0.74x0.62mm_HandSolder; Voltage 25; Tolerance 10; Part Number GRM155R61E104KA87D
X1: 10MHz; Oscillator_SMD_ECS_2520MV-xxx-xx-4Pin_2.5x2.0mm; Tolerance 25ppm; Part Number ECS-2520MVLC-100-CN-TR

Connections:
GND: C30.2, X1.2 (GND)
OE: X1.1 (TRI-STATE)
OUT: X1.3 (OUTPUT)
PWR: C30.1, X1.4 (VDD)
