MatthiasGeorgImhof/Hardware_CSAT/common/sheets/USB.kicad_sch

## KiCad design common/sheets/USB.kicad_sch (2026-09-15)

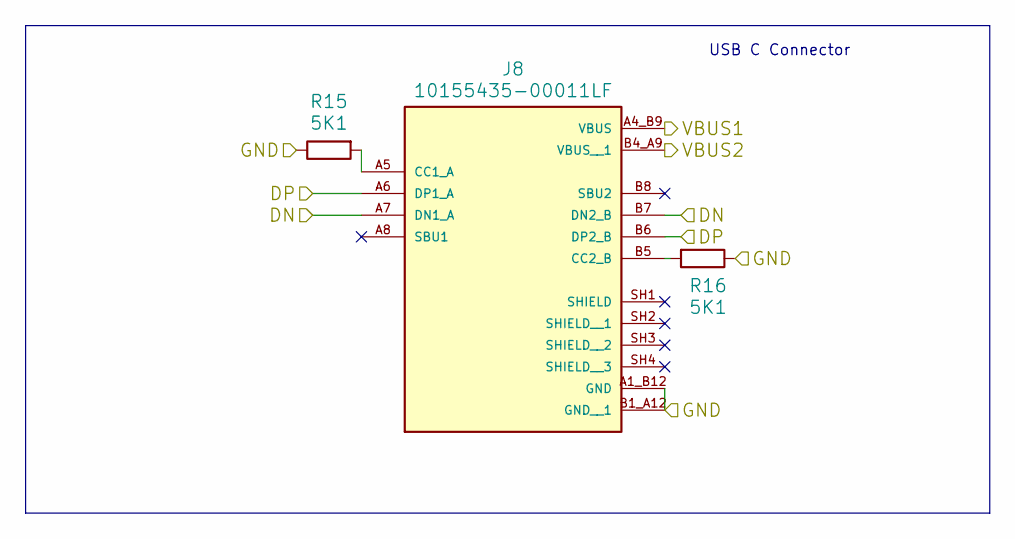
[picture p69: schematic USB.kicad_sch]

Parts:
J8: 10155435-00011LF; AMPHENOL_10155435-00011LF; Part Number 10155435-00011LF
R15, R16: 5K1; R_0402_1005Metric_Pad0.72x0.64mm_HandSolder; Tolerance 1; Part Number RC0402FR-075K1L

Connections:
DN: J8.A7 (DN1_A), J8.B7 (DN2_B)
DP: J8.A6 (DP1_A), J8.B6 (DP2_B)
GND: J8.A1_B12 (GND), J8.B1_A12 (GND__1), R15.1, R16.1
unnamed: J8.A5 (CC1_A), R15.2
unnamed: J8.B5 (CC2_B), R16.2
VBUS1: J8.A4_B9 (VBUS)
VBUS2: J8.B4_A9 (VBUS__1)

Notes on the sheet:
USB C Connector
