MatthiasGeorgImhof/Hardware_CSAT/common/sheets/WATCHDOG.kicad_sch

## KiCad design common/sheets/WATCHDOG.kicad_sch (2026-09-15)

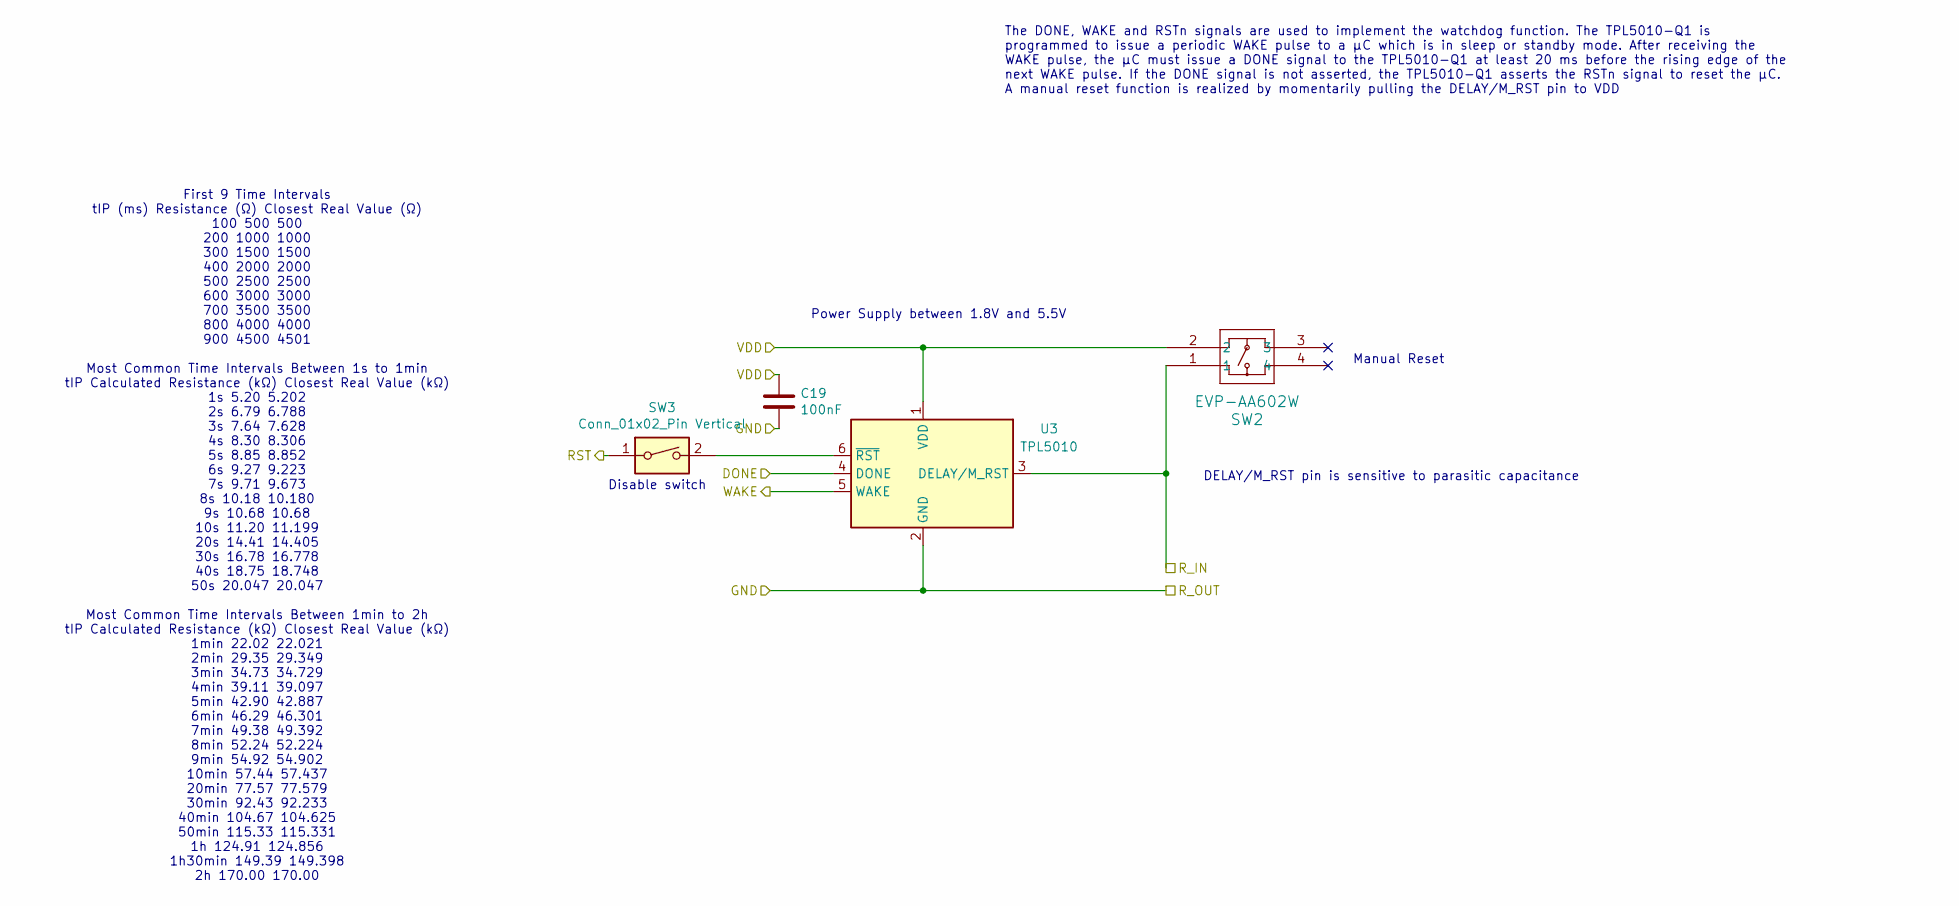
[picture p70: schematic WATCHDOG.kicad_sch]

Parts:
C19: 100nF; C_0402_1005Metric_Pad0.74x0.62mm_HandSolder; Voltage 25; Tolerance 10; Part Number GRM155R61E104KA87D
SW2: EVP-AA602W; EVP602AA; Part Number EVP-AA602W
SW3: Conn_01x02_Pin Vertical; PinHeader_1x02_P2.54mm_Vertical; Part Number vertical
U3: TPL5010; SOT-23-6; Part Number TPL5010DDCR

Connections:
DONE: U3.4 (DONE)
GND: C19.2, U3.2 (GND)
unnamed: SW3.2, U3.6 (~RST)
RST: SW3.1
R_IN: SW2.1, U3.3 (DELAY/M_RST)
VDD: C19.1, SW2.2, U3.1 (VDD)
WAKE: U3.5 (WAKE)

Notes on the sheet:
DELAY/M_RST pin is sensitive to parasitic capacitance
The DONE, WAKE and RSTn signals are used to implement the watchdog function. The TPL5010-Q1 is programmed to issue a periodic WAKE pulse to a μC which is in sleep or standby mode. After receiving the WAKE pulse, the μC must issue a DONE signal to the TPL5010-Q1 at least 20 ms before the rising edge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
Power Supply between 1.8V and 5.5V
Disable switch
Manual Reset
First 9 Time Intervals tIP (ms) Resistance (Ω) Closest Real Value (Ω) 100 500 500 200 1000 1000 300 1500 1500 400 2000 2000 500 2500 2500 600 3000 3000 700 3500 3500 800 4000 4000 900 4500 4501 Most Common Time Intervals Between 1s to 1min tIP Calculated Resistance (kΩ) Closest Real Value (kΩ) 1s 5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
