MatthiasGeorgImhof/Hardware_CSAT/common/sheets/boot.kicad_sch

## KiCad design common/sheets/boot.kicad_sch (2026-09-15)

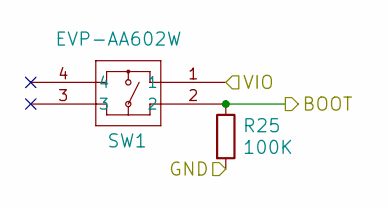
[picture p71: schematic boot.kicad_sch]

Parts:
R25: 100K; R_0402_1005Metric_Pad0.72x0.64mm_HandSolder; Tolerance 1; Part Number RC0402FR-07100KL
SW1: EVP-AA602W; EVP602AA; Part Number EVP-AA602W

Connections:
BOOT: R25.1, SW1.2
GND: R25.2
VIO: SW1.1
