MatthiasGeorgImhof/Hardware_CSAT/common/sheets/camera.kicad_sch

## KiCad design common/sheets/camera.kicad_sch (2026-06-08)

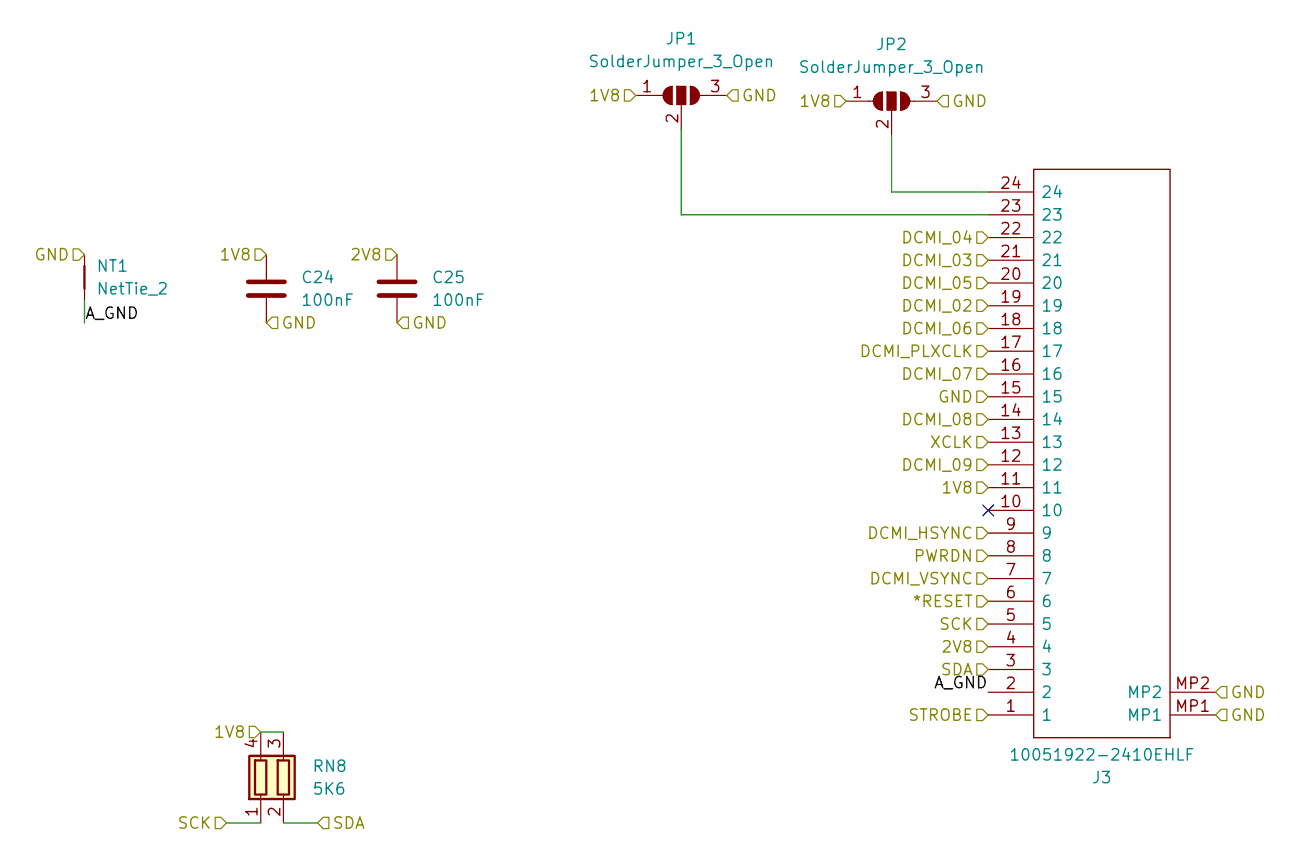
[picture p72: schematic camera.kicad_sch]

Parts:
C24, C25: 100nF; C_0402_1005Metric_Pad0.74x0.62mm_HandSolder; Tolerance 10; Voltage 25; Part Number GRM155R61E104KA87D
J3: 10051922-2410EHLF; 100519222410EHLF; Part Number 10051922-2410EHLF
JP1, JP2: SolderJumper_3_Open; SolderJumper-3_P2.0mm_Open_TrianglePad1.0x1.5mm
NT1: NetTie_2; NetTie-2_SMD_Pad0.3mm
RN8: 5K6; R_Array_Convex_2x0402_widepads; Tolerance 5; Part Number EXB-24V562JX

Connections:
1V8: C24.1, J3.11, JP1.1 (A), JP2.1 (A), RN8.3 (R2.2), RN8.4 (R1.2)
2V8: C25.1, J3.4
A_GND: J3.2, NT1.1
DCMI_02: J3.19
DCMI_03: J3.21
DCMI_04: J3.22
DCMI_05: J3.20
DCMI_06: J3.18
DCMI_07: J3.16
DCMI_08: J3.14
DCMI_09: J3.12
DCMI_HSYNC: J3.9
DCMI_PLXCLK: J3.17
DCMI_VSYNC: J3.7
GND: C24.2, C25.2, J3.15, J3.MP1, J3.MP2, JP1.3 (B), JP2.3 (B), NT1.2
unnamed: J3.23, JP1.2 (C)
unnamed: J3.24, JP2.2 (C)
PWRDN: J3.8
SCK: J3.5, RN8.1 (R1.1)
SDA: J3.3, RN8.2 (R2.1)
STROBE: J3.1
XCLK: J3.13
reset: J3.6
