MatthiasGeorgImhof/Hardware_CSAT/common/sheets/dual_switch.kicad_sch

## KiCad design common/sheets/dual_switch.kicad_sch (2026-06-08)

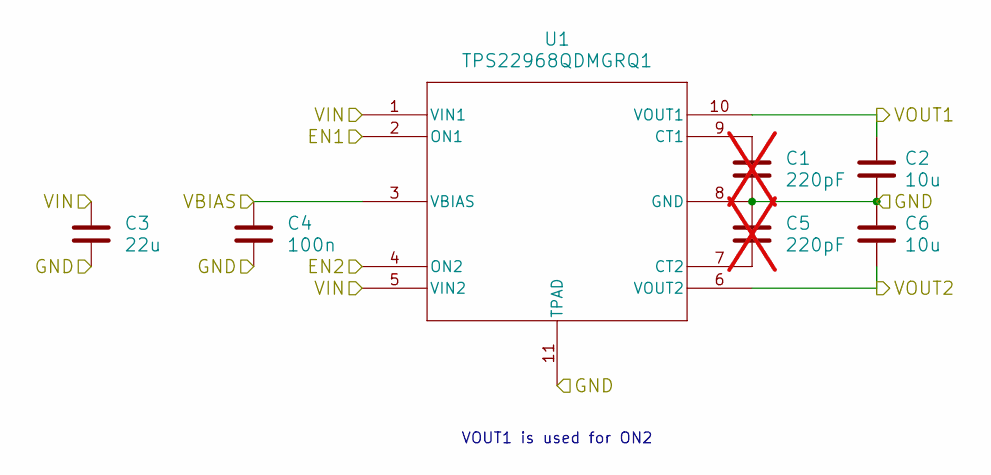
[picture p73: schematic dual_switch.kicad_sch]

Parts:
C1, C5: 220pF; C_0402_1005Metric_Pad0.74x0.62mm_HandSolder; Tolerance 5; Voltage 50; Part Number GRM1555C1H221JA01J; not fitted
C2, C6: 10u; C_0603_1608Metric_Pad1.08x0.95mm_HandSolder; Tolerance 10; Voltage 25; Part Number GRM188R61E106KA73D
C3: 22u; C_0603_1608Metric_Pad1.08x0.95mm_HandSolder; Tolerance 20; Voltage 10; Part Number GRM188R61A226ME15D
C4: 100n; C_0402_1005Metric_Pad0.74x0.62mm_HandSolder; Tolerance 10; Voltage 25; Part Number GRM155R61E104KA87D
U1: TPS22968QDMGRQ1; WSON-10-1EP_2x3mm_P0.5mm_EP0.84x2.4mm; Part Number TPS22968QDMGRQ1

Connections:
EN1: U1.2 (ON1)
EN2: U1.4 (ON2)
GND: C1.2, C2.2, C3.2, C4.2, C5.1, C6.1, U1.8 (GND), U1.11 (TPAD)
unnamed: C1.1, U1.9 (CT1)
unnamed: C5.2, U1.7 (CT2)
VBIAS: C4.1, U1.3 (VBIAS)
VIN: C3.1, U1.1 (VIN1), U1.5 (VIN2)
VOUT1: C2.1, U1.10 (VOUT1)
VOUT2: C6.2, U1.6 (VOUT2)

Notes on the sheet:
VOUT1 is used for ON2
