MatthiasGeorgImhof/Hardware_CSAT/common/sheets/dual_switch_dual_voltages.kicad_sch

## KiCad design common/sheets/dual_switch_dual_voltages.kicad_sch (2026-06-08)

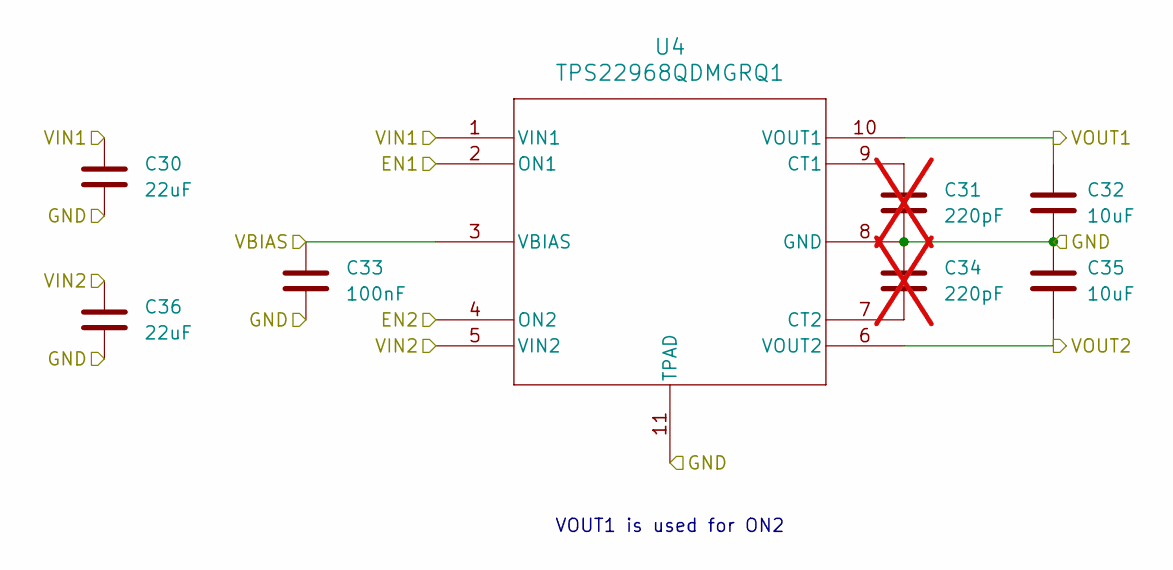
[picture p74: schematic dual_switch_dual_voltages.kicad_sch]

Parts:
C30, C36: 22uF; C_0603_1608Metric_Pad1.08x0.95mm_HandSolder; Tolerance 10; Voltage 25; Part Number GRM188R61E106KA73D
C31, C34: 220pF; C_0402_1005Metric_Pad0.74x0.62mm_HandSolder; Tolerance 1; Voltage 50; not fitted
C32, C35: 10uF; C_0603_1608Metric_Pad1.08x0.95mm_HandSolder; Tolerance 10; Voltage 25; Part Number GRM188R61E106KA73D
C33: 100nF; C_0402_1005Metric_Pad0.74x0.62mm_HandSolder; Tolerance 10; Voltage 25; Part Number GRM155R61E104KA87D
U4: TPS22968QDMGRQ1; WSON-10-1EP_2x3mm_P0.5mm_EP0.84x2.4mm; Part Number TPS22968QDMGRQ1

Connections:
EN1: U4.2 (ON1)
EN2: U4.4 (ON2)
GND: C30.2, C31.2, C32.2, C33.2, C34.1, C35.1, C36.2, U4.8 (GND), U4.11 (TPAD)
unnamed: C31.1, U4.9 (CT1)
unnamed: C34.2, U4.7 (CT2)
VBIAS: C33.1, U4.3 (VBIAS)
VIN1: C30.1, U4.1 (VIN1)
VIN2: C36.1, U4.5 (VIN2)
VOUT1: C32.1, U4.10 (VOUT1)
VOUT2: C35.2, U4.6 (VOUT2)

Notes on the sheet:
VOUT1 is used for ON2
