MatthiasGeorgImhof/Hardware_CSAT/common/sheets/flash.kicad_sch

## KiCad design common/sheets/flash.kicad_sch (2026-06-08)

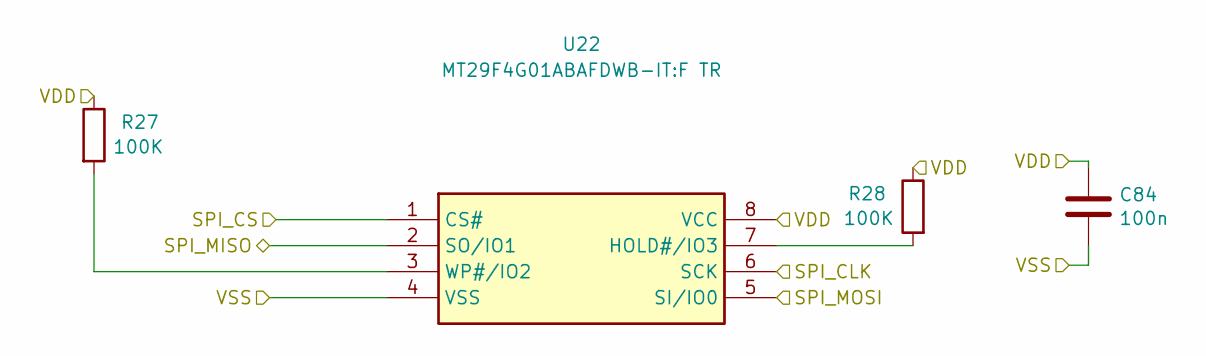
[picture p75: schematic flash.kicad_sch]

Parts:
C84: 100n; C_0402_1005Metric_Pad0.74x0.62mm_HandSolder; Voltage 25; Tolerance 10; PARTREV GRM155R61E104KA87D
R27, R28: 100K; R_0402_1005Metric_Pad0.72x0.64mm_HandSolder; Tolerance 1; PARTREV RC0402FR-07100KL
U22: MT29F4G01ABAFDWB-IT:F TR; SON127P800X600X65-8N; PARTREV MT29F4G01ABAFDWB-IT:F TR; Mouser Part Number 340-359563

Connections:
unnamed: R27.2, U22.3 (WP#/IO2)
unnamed: R28.2, U22.7 (HOLD#/IO3)
SPI_CLK: U22.6 (SCK)
SPI_CS: U22.1 (CS#)
SPI_MISO: U22.2 (SO/IO1)
SPI_MOSI: U22.5 (SI/IO0)
VDD: C84.1, R27.1, R28.1, U22.8 (VCC)
VSS: C84.2, U22.4 (VSS)
