MatthiasGeorgImhof/Hardware_CSAT/common/sheets/i2c_aux_power_switch.kicad_sch

## KiCad design common/sheets/i2c_aux_power_switch.kicad_sch (2026-06-08)

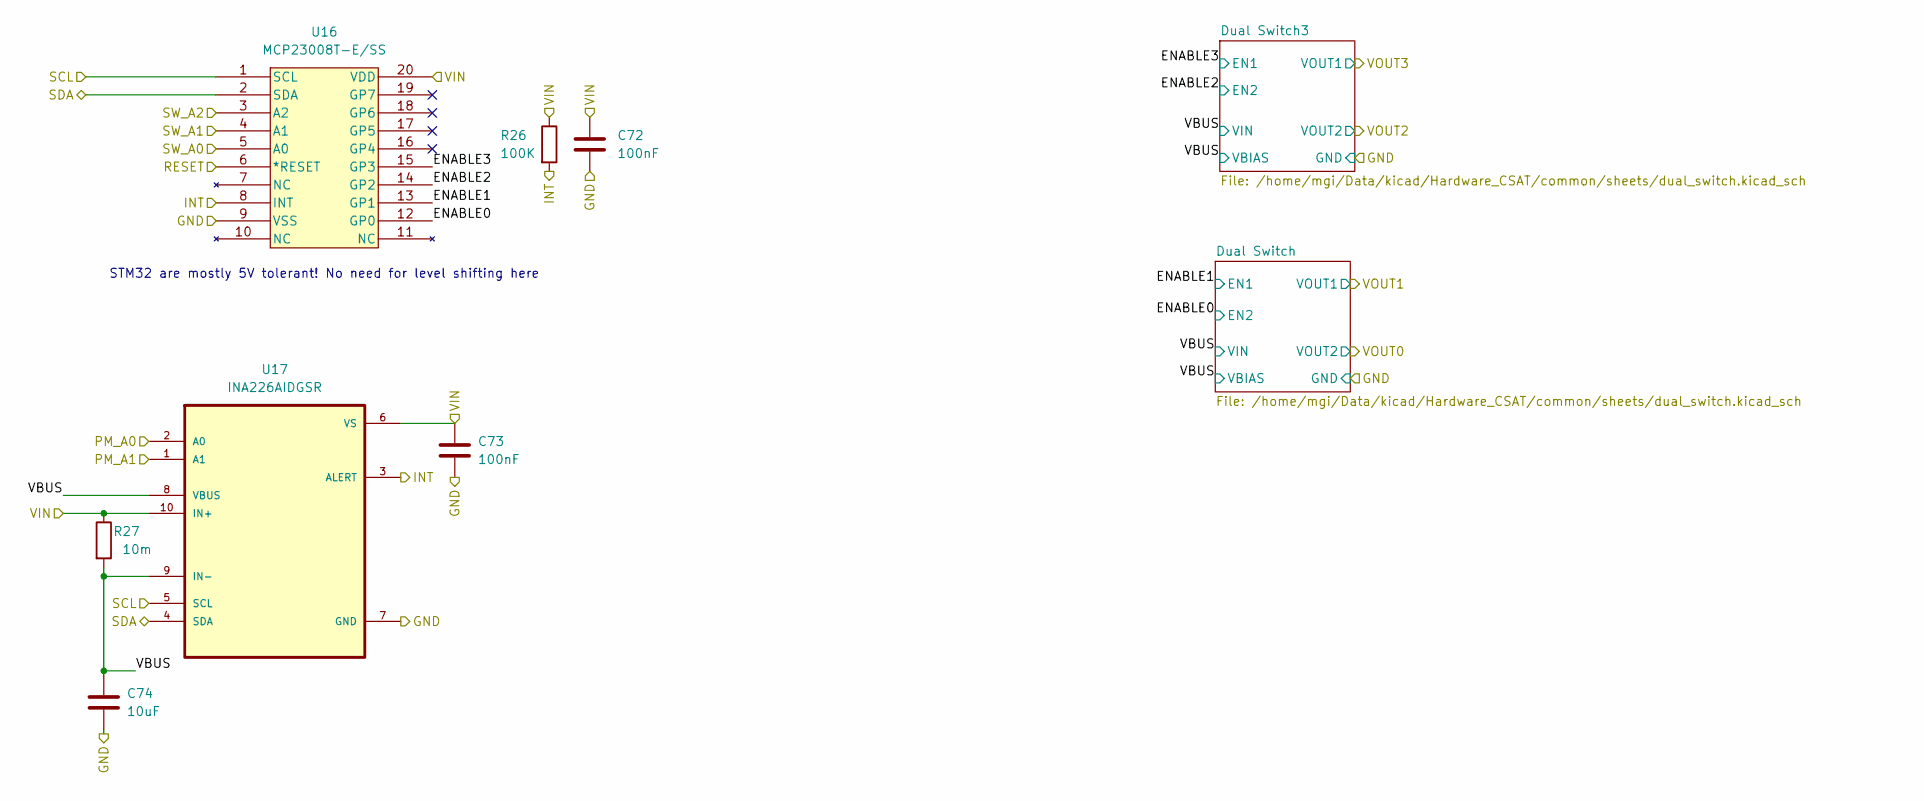
[picture p76: schematic i2c_aux_power_switch.kicad_sch]

Parts:
C72, C73: 100nF; C_0402_1005Metric_Pad0.74x0.62mm_HandSolder; Voltage 25; Tolerance 10; Part Number GRM155R61E104KA87D
C74: 10uF; C_0603_1608Metric_Pad1.08x0.95mm_HandSolder; Tolerance 10; Voltage 25; Part Number GRM188R61E106KA73D
R26: 100K; R_0402_1005Metric_Pad0.72x0.64mm_HandSolder; Tolerance 1; Part Number RC0402FR-07100KL
R27: 10m; R_0805_2012Metric_Pad1.20x1.40mm_HandSolder; Tolerance 1; Part Number PE0805FRE470R01Z
U16: MCP23008T-E/SS; SSOP-20_5.3x7.2mm_P0.65mm; Part Number MCP23008T-E/SS
U17: INA226AIDGSR; VSSOP-10_3x3mm_P0.5mm; Part Number INA226AIDGSR

Connections:
ENABLE0: U16.12 (GP0)
ENABLE1: U16.13 (GP1)
ENABLE2: U16.14 (GP2)
ENABLE3: U16.15 (GP3)
GND: C72.2, C73.2, C74.2, U16.9 (VSS), U17.7 (GND)
INT: R26.2, U16.8 (INT), U17.3 (ALERT)
PM_A0: U17.2 (A0)
PM_A1: U17.1 (A1)
RESET: U16.6 (*RESET)
SCL: U16.1 (SCL), U17.5 (SCL)
SDA: U16.2 (SDA), U17.4 (SDA)
SW_A0: U16.5 (A0)
SW_A1: U16.4 (A1)
SW_A2: U16.3 (A2)
VBUS: C74.1, R27.2, U17.8 (VBUS), U17.9 (IN-)
VIN: C72.1, C73.1, R26.1, R27.1, U16.20 (VDD), U17.6 (VS), U17.10 (IN+)

Notes on the sheet:
STM32 are mostly 5V tolerant! No need for level shifting here
