MatthiasGeorgImhof/Hardware_CSAT/common/sheets/i2c_power_switch.kicad_sch

## KiCad design common/sheets/i2c_power_switch.kicad_sch (2026-09-15)

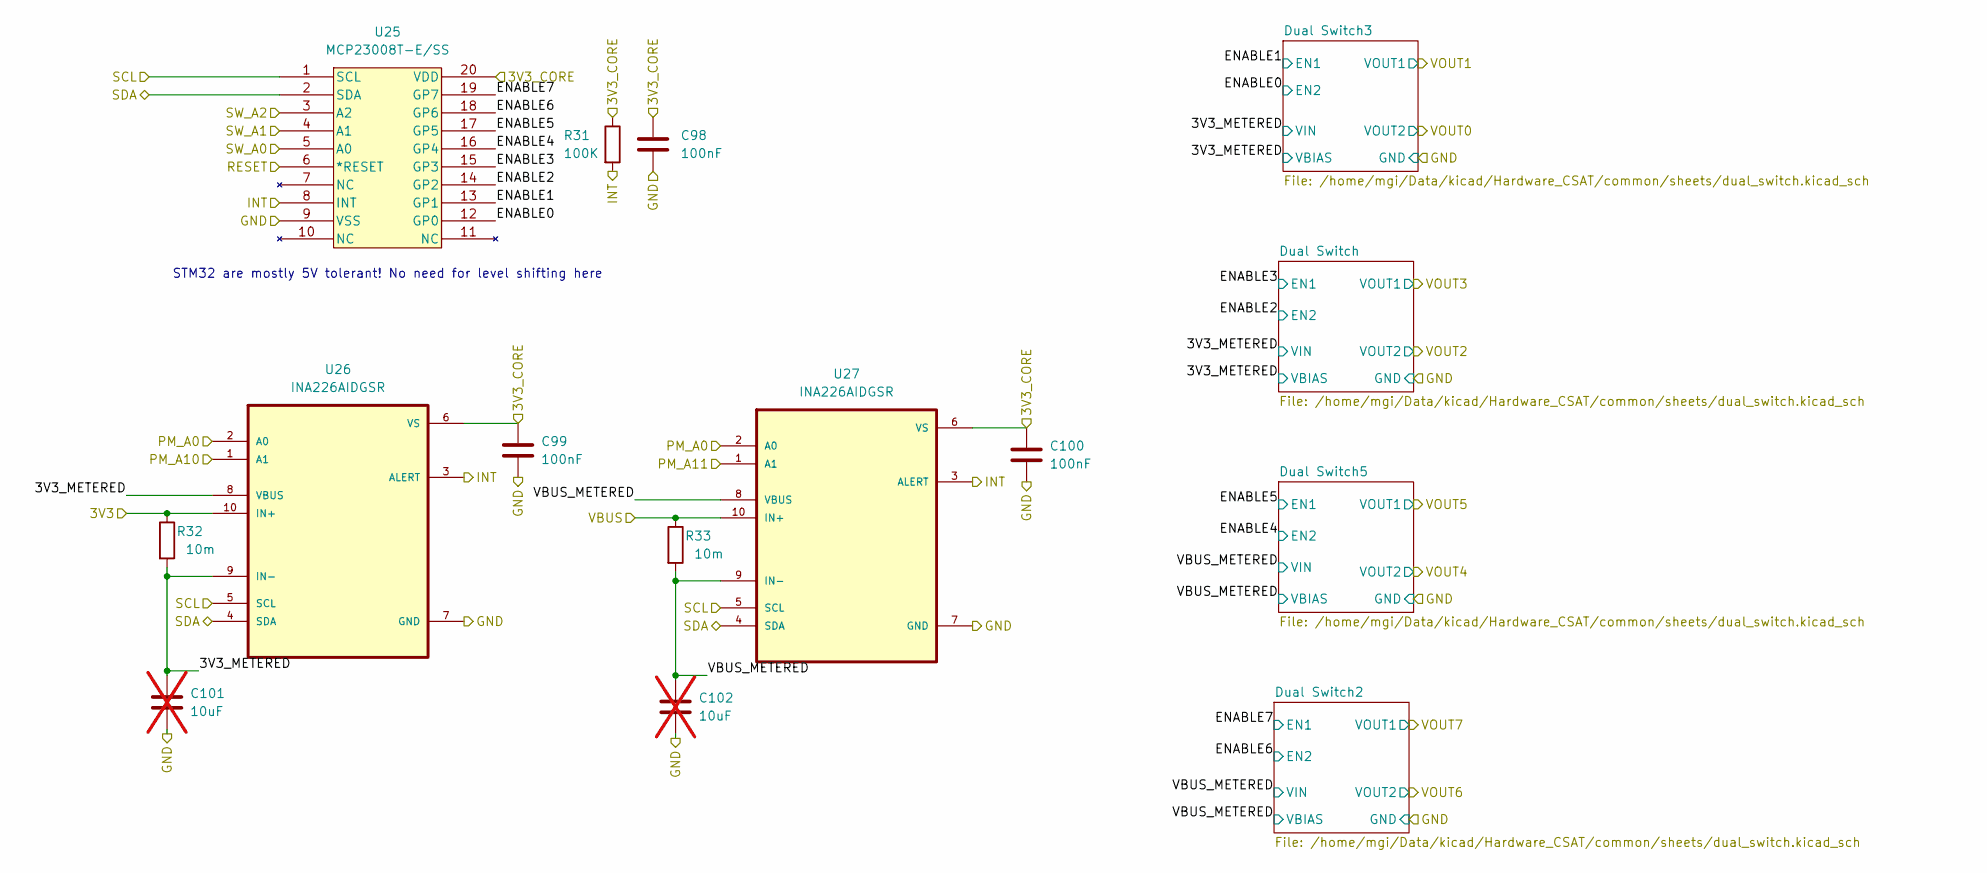
[picture p77: schematic i2c_power_switch.kicad_sch]

Parts:
C98, C99, C100: 100nF; C_0402_1005Metric_Pad0.74x0.62mm_HandSolder; Voltage 25; Tolerance 10; Part Number GRM155R61E104KA87D
C101, C102: 10uF; C_0603_1608Metric_Pad1.08x0.95mm_HandSolder; Tolerance 10; Voltage 25; Part Number GRM188R61E106KA73D; not fitted
R31: 100K; R_0402_1005Metric_Pad0.72x0.64mm_HandSolder; Tolerance 1; Part Number RC0402FR-07100KL
R32, R33: 10m; R_0805_2012Metric_Pad1.20x1.40mm_HandSolder; Tolerance 1; Part Number PE0805FRE470R01Z
U25: MCP23008T-E/SS; SSOP-20_5.3x7.2mm_P0.65mm; Part Number MCP23008T-E/SS
U26, U27: INA226AIDGSR; VSSOP-10_3x3mm_P0.5mm; Part Number INA226AIDGSR

Connections:
3V3: R32.1, U26.10 (IN+)
3V3_CORE: C98.1, C99.1, C100.1, R31.1, U25.20 (VDD), U26.6 (VS), U27.6 (VS)
3V3_METERED: C101.1, R32.2, U26.8 (VBUS), U26.9 (IN-)
ENABLE0: U25.12 (GP0)
ENABLE1: U25.13 (GP1)
ENABLE2: U25.14 (GP2)
ENABLE3: U25.15 (GP3)
ENABLE4: U25.16 (GP4)
ENABLE5: U25.17 (GP5)
ENABLE6: U25.18 (GP6)
ENABLE7: U25.19 (GP7)
GND: C98.2, C99.2, C100.2, C101.2, C102.2, U25.9 (VSS), U26.7 (GND), U27.7 (GND)
INT: R31.2, U25.8 (INT), U26.3 (ALERT), U27.3 (ALERT)
PM_A0: U26.2 (A0), U27.2 (A0)
PM_A10: U26.1 (A1)
PM_A11: U27.1 (A1)
RESET: U25.6 (*RESET)
SCL: U25.1 (SCL), U26.5 (SCL), U27.5 (SCL)
SDA: U25.2 (SDA), U26.4 (SDA), U27.4 (SDA)
SW_A0: U25.5 (A0)
SW_A1: U25.4 (A1)
SW_A2: U25.3 (A2)
VBUS: R33.1, U27.10 (IN+)
VBUS_METERED: C102.1, R33.2, U27.8 (VBUS), U27.9 (IN-)

Notes on the sheet:
STM32 are mostly 5V tolerant! No need for level shifting here
