MatthiasGeorgImhof/Hardware_CSAT/common/sheets/i2c_power_switches_3v_sch.kicad_sch

## KiCad design common/sheets/i2c_power_switches_3v_sch.kicad_sch (2026-09-15)

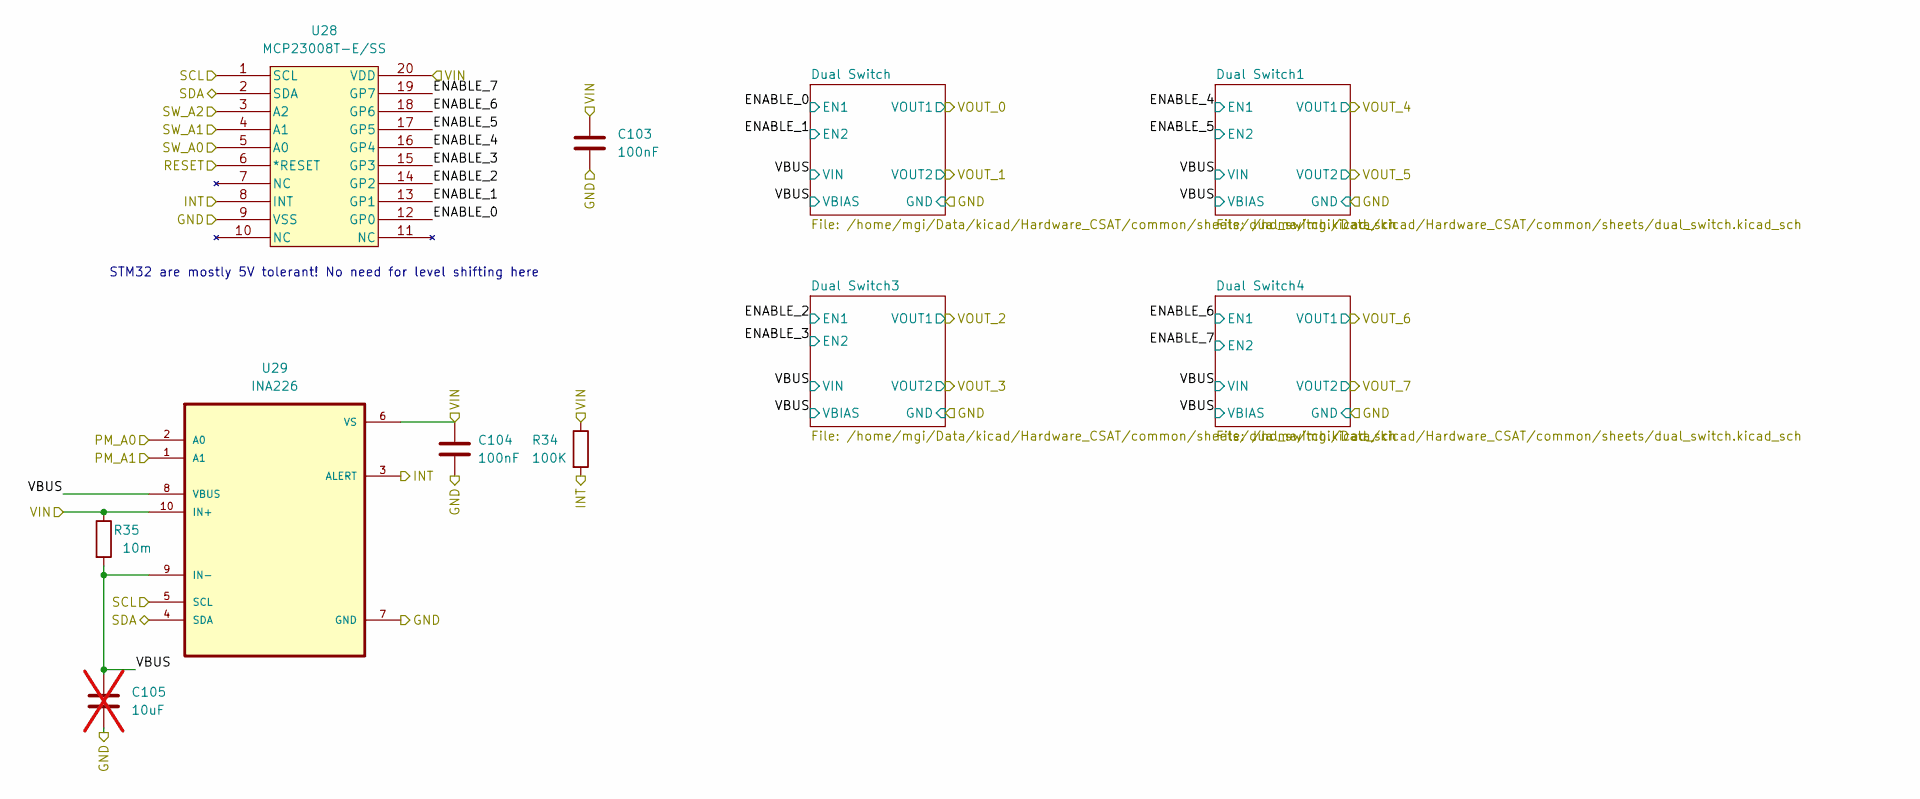
[picture p78: schematic i2c_power_switches_3v_sch.kicad_sch]

Parts:
C103, C104: 100nF; C_0402_1005Metric_Pad0.74x0.62mm_HandSolder; Voltage 25; Tolerance 10; Part Number GRM155R61E104KA87D
C105: 10uF; C_0603_1608Metric_Pad1.08x0.95mm_HandSolder; Tolerance 10; Voltage 25; Part Number GRM188R61E106KA73D; not fitted
R34: 100K; R_0402_1005Metric_Pad0.72x0.64mm_HandSolder; Tolerance 1; Part Number RC0402FR-07100KL
R35: 10m; R_0805_2012Metric_Pad1.20x1.40mm_HandSolder; Tolerance 1; Part Number PE0805FRE470R01Z
U28: MCP23008T-E/SS; SSOP-20_5.3x7.2mm_P0.65mm; Part Number MCP23008T-E/SS
U29: INA226; VSSOP-10_3x3mm_P0.5mm; Part Number INA226AIDGSR

Connections:
ENABLE_0: U28.12 (GP0)
ENABLE_1: U28.13 (GP1)
ENABLE_2: U28.14 (GP2)
ENABLE_3: U28.15 (GP3)
ENABLE_4: U28.16 (GP4)
ENABLE_5: U28.17 (GP5)
ENABLE_6: U28.18 (GP6)
ENABLE_7: U28.19 (GP7)
GND: C103.2, C104.2, C105.2, U28.9 (VSS), U29.7 (GND)
INT: R34.2, U28.8 (INT), U29.3 (ALERT)
PM_A0: U29.2 (A0)
PM_A1: U29.1 (A1)
RESET: U28.6 (*RESET)
SCL: U28.1 (SCL), U29.5 (SCL)
SDA: U28.2 (SDA), U29.4 (SDA)
SW_A0: U28.5 (A0)
SW_A1: U28.4 (A1)
SW_A2: U28.3 (A2)
VBUS: C105.1, R35.2, U29.8 (VBUS), U29.9 (IN-)
VIN: C103.1, C104.1, R34.1, R35.1, U28.20 (VDD), U29.6 (VS), U29.10 (IN+)

Notes on the sheet:
STM32 are mostly 5V tolerant! No need for level shifting here
