MatthiasGeorgImhof/Hardware_CSAT/common/sheets/power_regulator_mp3416.kicad_sch

## KiCad design common/sheets/power_regulator_mp3416.kicad_sch (2026-09-15)

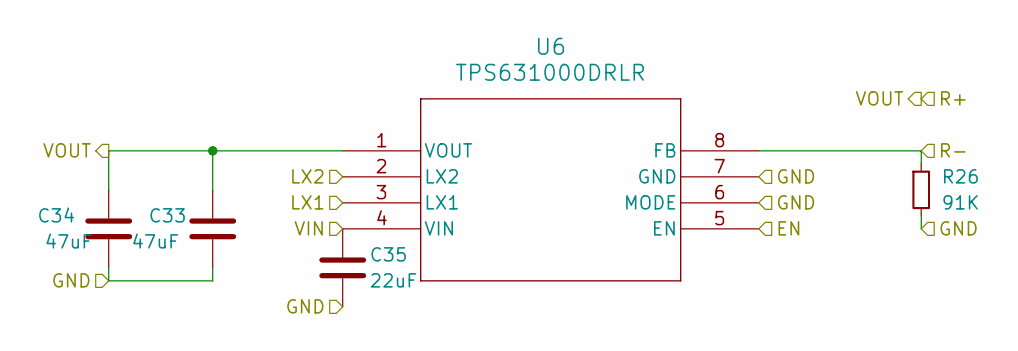
[picture p79: schematic power_regulator_mp3416.kicad_sch]

Parts:
C33, C34: 47uF; C_0805_2012Metric_Pad1.18x1.45mm_HandSolder; Tolerance 20; Voltage 10; Part Number GRM21BR61A476ME15K
C35: 22uF; C_0603_1608Metric_Pad1.08x0.95mm_HandSolder; Tolerance 20; Voltage 10; Part Number GRM188R61A226ME15D
R26: 91K; R_0402_1005Metric_Pad0.72x0.64mm_HandSolder; Tolerance 1; Part Number RC0402FR-0791KL
U6: TPS631000DRLR; TPS631000DRLR_TEX; Part Number TPS631000DRLR

Connections:
EN: U6.5 (EN)
GND: C33.2, C34.2, C35.2, R26.2, U6.6 (MODE), U6.7 (GND)
LX1: U6.3 (LX1)
LX2: U6.2 (LX2)
R+: C33.1, C34.1, U6.1 (VOUT)
R-: R26.1, U6.8 (FB)
VIN: C35.1, U6.4 (VIN)
