MatthiasGeorgImhof/Hardware_CSAT/common/sheets/reset.kicad_sch

## KiCad design common/sheets/reset.kicad_sch (2026-09-15)

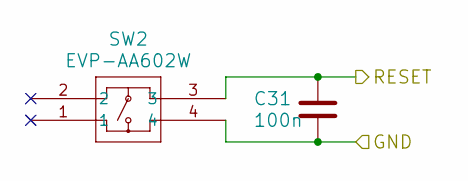
[picture p80: schematic reset.kicad_sch]

Parts:
C31: 100n; C_0402_1005Metric_Pad0.74x0.62mm_HandSolder; Voltage 25; Tolerance 10; Part Number GRM155R61E104KA87D
SW2: EVP-AA602W; EVP602AA; Part Number EVP-AA602W

Connections:
GND: C31.2, SW2.4
RESET: C31.1, SW2.3
