MatthiasGeorgImhof/Hardware_CSAT/common/sheets/schmitt_trigger.kicad_sch

## KiCad design common/sheets/schmitt_trigger.kicad_sch (2026-06-08)

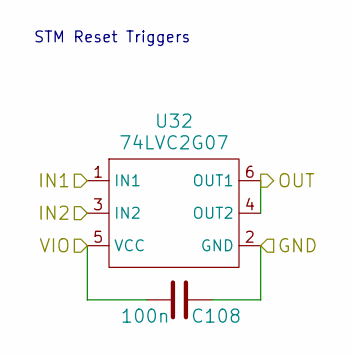
[picture p81: schematic schmitt_trigger.kicad_sch]

Parts:
C108: 100n; C_0402_1005Metric_Pad0.74x0.62mm_HandSolder; Voltage 25; Tolerance 10; Part Number GRM155R61E104KA87D
U32: 74LVC2G07; SOT-363_SC-70-6; Part Number SN74LVC2G07DCKR

Connections:
GND: C108.1, U32.2 (GND)
IN1: U32.1 (IN1)
IN2: U32.3 (IN2)
OUT: U32.4 (OUT2), U32.6 (OUT1)
VIO: C108.2, U32.5 (VCC)

Notes on the sheet:
STM Reset Triggers
