MatthiasGeorgImhof/Hardware_CSAT/(commit log)

2026-06-08 Initial clean YouTube version of the CubeStack boards
    [10051922-2410EHLF.STEP, 10153301-201xxLF.stp, 10155435-00011LF--3DModel-STEP-510211.STEP, 10155435-00011LF.step, 18650-battery-01a-v1.step, 204-211.step, ACS.kicad_sch, ACS.sch]
2026-07-27 prepare for i2c switch refactor
    [BATTERY.kicad_sch, BATTERY_CHARGER.kicad_sch, EPS.kicad_sch, IDEAL_DIODE.kicad_sch, PMIC.kicad_sch, USB.kicad_sch, power_selector.kicad_sch]
2026-09-15 auxio_board: leverage more IO on aux board
    [10155435-00011LF.step, BATTERY.kicad_sch, BATTERY_CHARGER.kicad_sch, CAN_TRANSCEIVER.kicad_sch, ECS-TXO-2016-33-100-TR.step, EPS.kicad_pcb, EPS.kicad_sch, ESQ-124-38-L-D.step]
