MatthiasGeorgImhof/Hardware_CSAT/(notices)

Notices in the files:
comm_board/inactive/openlst-hw.sch:
This work is licensed under a Creative Commons Attribution-ShareAlike 4.0 International
common/step3d/SAMTEC-CLP-106-02-X-DH.step:
author */ ('License CC BY-ND 4.0'),
